4ms/mp153-devboard/v0.2/production/mp153-devboard-mockup-1.png

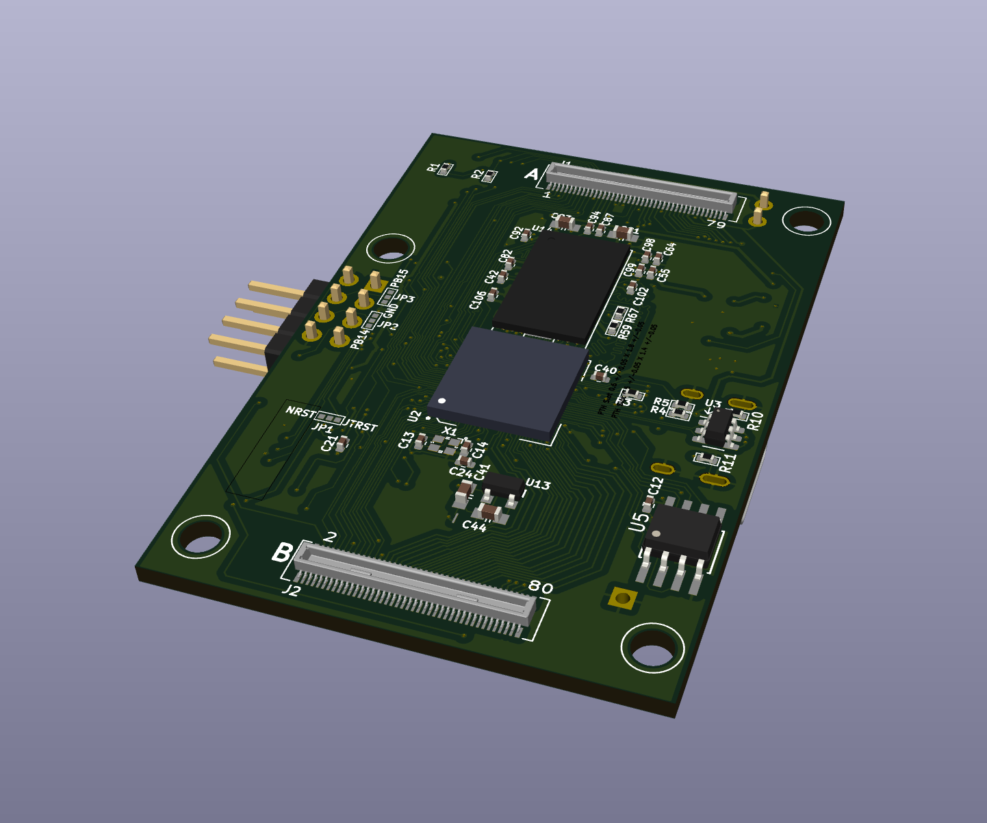
v0.2/production/mp153-devboard-mockup-1.png
