4ms/mp153-devboard/v0.2/uart-connection.jpg

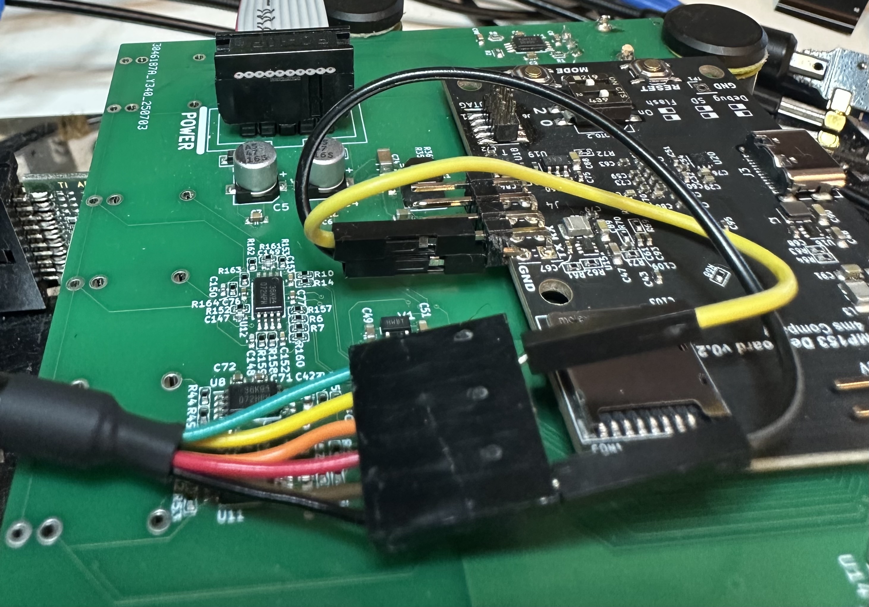
v0.2/uart-connection.jpg
