4ms/mp153-devboard/v0.2/production/mp153-devboard-mockup-2.png

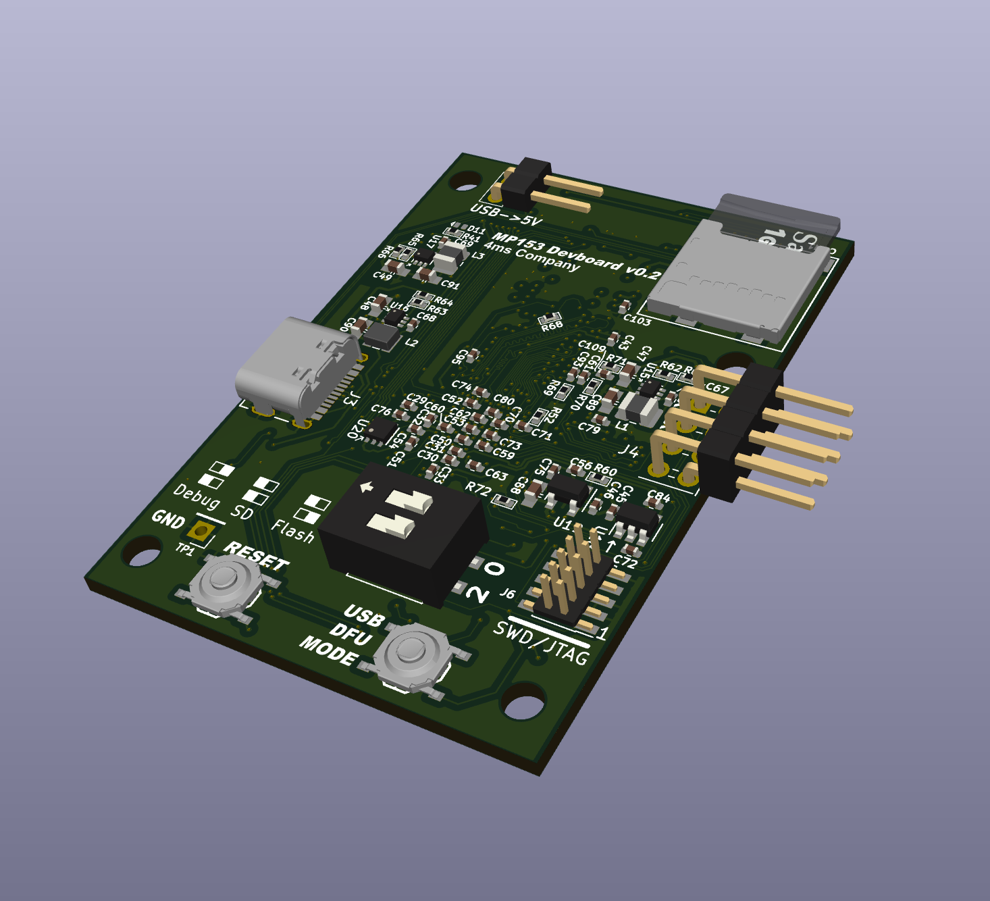
v0.2/production/mp153-devboard-mockup-2.png
