4ms/mp153-devboard/v0.2/production/mp153-devboard-v0.2-bom.xlsx

mp153-devboard-v0.2-bom
4ms Company
PCBA Project: | mp153-devboard | Revision: | v0.2
EMAIL: | 4ms@4mscompany.com
DATE: | 2025-07-10
Group | Item# | Manufacturer | Manufacter Part# | Designator | Quantity | Designation | Package | Comments | Supplied by:
A | 1 | Hirose | DF40C-80DP-0.4V(51) | J1, J2 | 2 | Pins_02x40_P0.4mm_W3.0mm_SMT | Connector-80pin-P0.4mm-W3.0mm
A | 2 | Molex | 217179-0001 | J3 | 1 | USB-C_Receptacle_Molex_2171790001 | USB_C_Receptacle_Molex_2171790001
A | 3 | CTS | 219-2MST | BOOT0_2 | 1 | SW_DIP_x02_CTS_219-2MST, DIP Switch SPST x 2, Gull wing P2.54mm, 6.7x6.55mm Body, 8.6mm Rows | SW_DIP_SPSTx02_CTS_219-2MSTR
A | 4 | Murata | GCM155R71C104KA55D | C12, C21, C30, C40, C42, C43, C61, C64, C67, C68, C69, C82, C87, C92, C93, C94, C95, C98, C99, C102, C103, C106 | 22 | 100nF_0402_16V, 0.1uF, Min. 16V 10%, X7R or X5R or similar | C0402
A | 5 | Yageo | CC0402CRNPO9BN6R8 | C13, C14 | 2 | 6.8pF_0402_25V, 6.8pF, Min. 25V 10%, NP0/C0G | C0402
A | 6 | Yageo | CC0402KRX7R7BB103 | C24 | 1 | 10nF_0402_16V, 10nF, Min. 16V 10%, X7R or X5R or similar | C0402
A | 7 | Murata | GRM155R60J225KE95D | C29, C32 | 2 | 2.2uF_0402_6.3V, 2.2uF, Min. 6.3V 10%, X7R or X5R or similar | C0402
A | 8 | Taiyo Yuden | GMK105CC6105KV-F | C31, C33, C45, C46, C50, C51, C52, C53, C54, C55, C59, C60, C62, C63, C70, C73, C79, C109 | 18 | 1uF_0402_25V, 1uF, Min. 25V, 0402, Ceramic/MLCC | C0402
A | 9 | Murata | GRM188R6YA225KA12D | C41, C47, C48, C49 | 4 | 2.2uF_0603_25V, 2.2uF, Min 25V 10% X5R | C0603
A | 10 | Murata | GRM188R61A106KE69D | C44, C81, C83 | 3 | 10uF_0603_10V, 10uF, Min. 10V X5R 10% | C0603
A | 11 | Murata | GRM155R71H104KE14D | C56, C72, C75 | 3 | 100nF_0402_50V, 0.1uF, Min. 50V 10%, X7R or X5R or similar | C0402
A | 12 | Vishay | VJ0402Y332KXACW1BC | C71, C74, C80 | 3 | 3.3nF_0402_16V, 3.3nF, Min. 16V 10%, X7R or X5R or similar | C0402
A | 13 | Murata | GRM155R60J475ME47 | C76, C84 | 2 | 4.7uF_0402_6.3V, 4.7uF, Min. 6.3V 20%, X7R or X5R or similar | C0402
A | 14 | Murata | GRM188R60J226MEA0J | C88, C89, C90, C91 | 4 | 22uF_0603_6.3V, 22uF, 6.3V,10%,X5R or X7R,0603 | C0603
A | 15 | Diodes Inc | BAT54LP-7 | D11 | 1 | BAT54LP, Schottky, 1mm x 0.6mm, Vr >= 30V, If >= 200mA, Vf = 240mA@0.1mA | DFN-1006-2
A | 16 | Murata | DFE252012P-1R0M=P2 | L1, L3 | 2 | 1uH_3.2A_2520, Inductor 1uH ~42mohm 3.2A 2.5mm x 2.0mm | L_1008_2520Metric
A | 17 | Bourns | SRN2510F-4R7M | L2 | 1 | 4.7uH_1.7A_2510, Power Inductors - SMD 4.7uH 20% SMD 2510 1.7A | L_Wuerth_MAPI-2510
A | 18 | Yageo | RC0402FR-0710KL | R1, R2, R41, R61, R64, R66, R67, R69, R72 | 9 | 10k_0402, 10k, 1%, 1/16W, 0402 | R0402
A | 19 | Yageo | RC0402FR-073KL | R3 | 1 | 3k_0402, 3k, 1%, 1/16W, 0402 | R0402
A | 20 | Yageo | RC0402FR-07430KL | R4 | 1 | 430k_0402, 430k, 1%, 1/16W, 0402 | R0402
A | 21 | Yageo | RC0402FR-07620KL | R5 | 1 | 620k_0402, 620k, 1%, 1/16W, 0402 | R0402
A | 22 | Yageo | RC0402FR-075K1L | R10, R11 | 2 | 5.1k_0402, 5.1k, 1%, 1/16W, 0402 | R0402
A | 23 | Yageo | RC0402FR-07240RL | R52, R59 | 2 | 240Ω_0402, 240Ω, 1%, 1/16W, 0402 | R0402
A | 24 | Yageo | RC0402FR-07100KL | R60 | 1 | 100k_0402, 100k, 1%, 1/16W, 0402 | R0402
A | 25 | Yageo | RC0402FR-0720KL | R62 | 1 | 20k_0402, 20k, 1%, 1/16W, 0402 | R0402
A | 26 | Yageo | RC0402FR-0731K6L | R63 | 1 | 31.6k_0402, 31.6k, 1%, 1/16W, 0402 | R0402
A | 27 | Yageo | RC0402FR-076K8L | R65 | 1 | 6.8k_0402, 6.8k, 1%, 1/16W, 0402 | R0402
A | 28 | Yageo | RC0402FR-07100RL | R68 | 1 | 100Ω_0402, 100Ω, 1%, 1/16W, 0402 | R0402
A | 29 | Yageo | RC0402FR-071KL | R70, R71 | 2 | 1k_0402, 1k, 1%, 1/16W, 0402 | R0402
A | 30 | C&K Switches | PTS526 SM15 SMTR2 LFS | S2, S3 | 2 | SW_Push_PTS526 SM15 SMTR2 LFS, Tact button, NO, | Button_Tact_PTS526
A | 31 | STMicroelectronics | STM32MP153DAD | U2 | 1 | STM32MP15xxAD, Cortex A7x2 + M4, 800MHz, TFBGA12x12 | TFBGA-257_10x10mm_perP0.5_cntrP0.65
A | 32 | STMicroelectronics | USBLC6-2SC6 | U3 | 1 | USBLC6-2SC6, ESD Protection, pins 3+4, 1+6 shorted | SOT-23-6
A | 33 | Winbond | W25Q128JVSIQ | U5 | 1 | NORFLASH_W25Q128JV, 16Mbit QSPI NOR FLASH, 4kb uniform sectors | SOIC-8_5.28x4.9mm_Pitch1.27mm
A | 34 | ON Semiconductor | NCP51460SN33T1G | U13 | 1 | NCP51460SN33, Precision 3.3V Ref 1% 18PPM 28Vmax 20mAmax | SOT23-3_PO132
A | 35 | Micron | MT41K256M16TW-107-P-V00H | U14 | 1 | DDR3L-RAM-4Gb_MT41K256M16TW, 4Gbit DDR3L | FBGA-96_Layout2x3x16_Body8x14_P0.8mm
A | 36 | Diodes Inc | AP62301Z6 | U15, U16, U17 | 3 | AP6230xZ6, 3A, 750kHz Buck DC/DC Converter, VinMax>=12V | SOT-563
A | 37 | Toshiba | TAR5S33TE85LF | U18, U19 | 2 | TAR5S33, LDO 3.3V, Vin >= 12V, Enable, Min Iout >= 50mA | SOT-23-5
A | 38 | Diodes Incorporated | AP2411SN-7 | U20 | 1 | AP2411SN | DFN-6-1EP_2x2mm_P0.65mm_EP1x1.6mm
A | 39 | ECS | ECS-240-8-37-CKM-TR3 | X1 | 1 | 24MHz_8pF_2x1.6mm, 24MHz 8pF Crystal Resonator, 10ppm, 2016 2x1.6mm | Crystal_2.0x1.6mm_4pin
AB | 40 | Molex | 104031-0811 | CON1 | 1 | microSDCon_SMT_104031-0811, MicroSD Card Conn Horiz SMT | CardSlot_MicroSD_Molex_104031-0811
AB | 41 | Samtec | FTSH-105-01-F-DV | J6 | 1 | Pins_02x05_P1.27mm_SMT, Header 2x5 Pins, Pitch=1.27mm, Pin Height=3mm, Vertical, SMT | Pins_2x05_1.27mm_SMD
B | 42 | Samtec | TSW-104-08-T-D-RA | J4 | 1 | Pins_02x04_RightAngle_P2.54mm_TH, HEADER 2x4 MALE PINS 0.100” 90deg Right Angle | Pins_2x04_P2.54mm_Horizontal_CroppedSilk
B | 43 | Samtec | TSW-102-08-T-S-RA | J5 | 1 | Conn_01x02, Pins_01x02, Header, Male Pins, 1*2, spacing 2.54mm, right angle pin | Pins_1x02_2.54mm_Horizontal_TH
 |  |  | DNP | H1, H2, H3, H4 |  | DNP | DNP
 |  |  | DNP | TP1 |  | DNP | DNP
