4ms/mp153-devboard/v0.1/3d-models/DF40HC(3.0)-80DS.stp

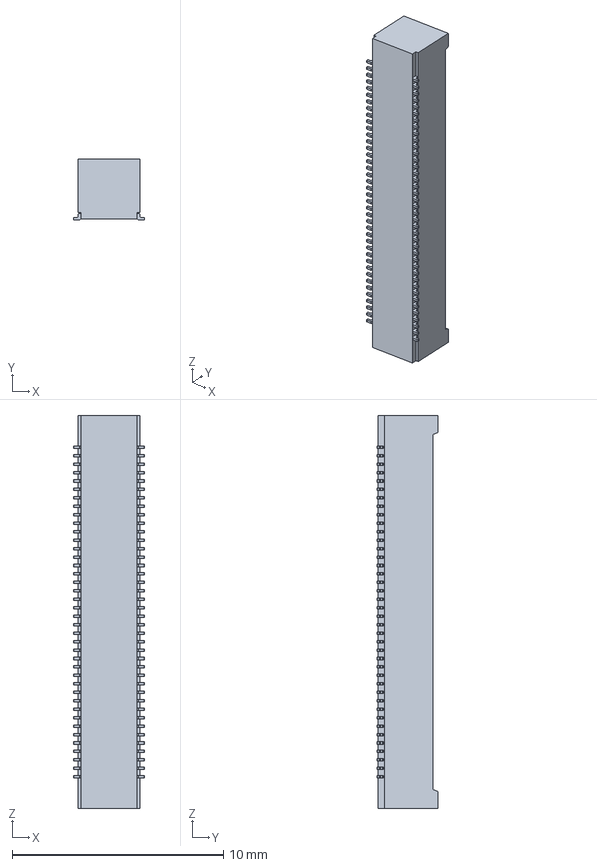
[picture p4: CAD file, 2025-06-03, an earlier design]
v0.1/3d-models/DF40HC(3.0)-80DS.stp
3.38 x 2.90 x 18.6 mm
