4ms/mp153-devboard/v0.1/3d-models/DF40C-80DP.stp

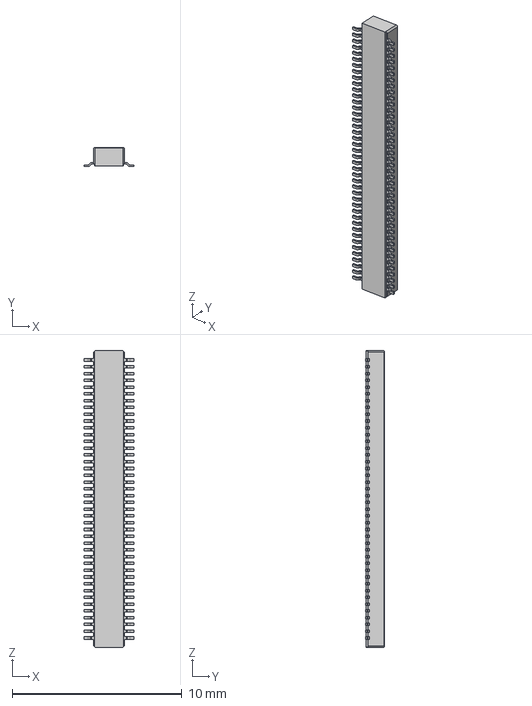
[picture p5: CAD file, 2025-06-03, an earlier design]
v0.1/3d-models/DF40C-80DP.stp
2.97 x 1.14 x 17.5 mm
