4ms/mp153-devboard/carrier-breakout/v0.1/mp153-carrier-board.pdf

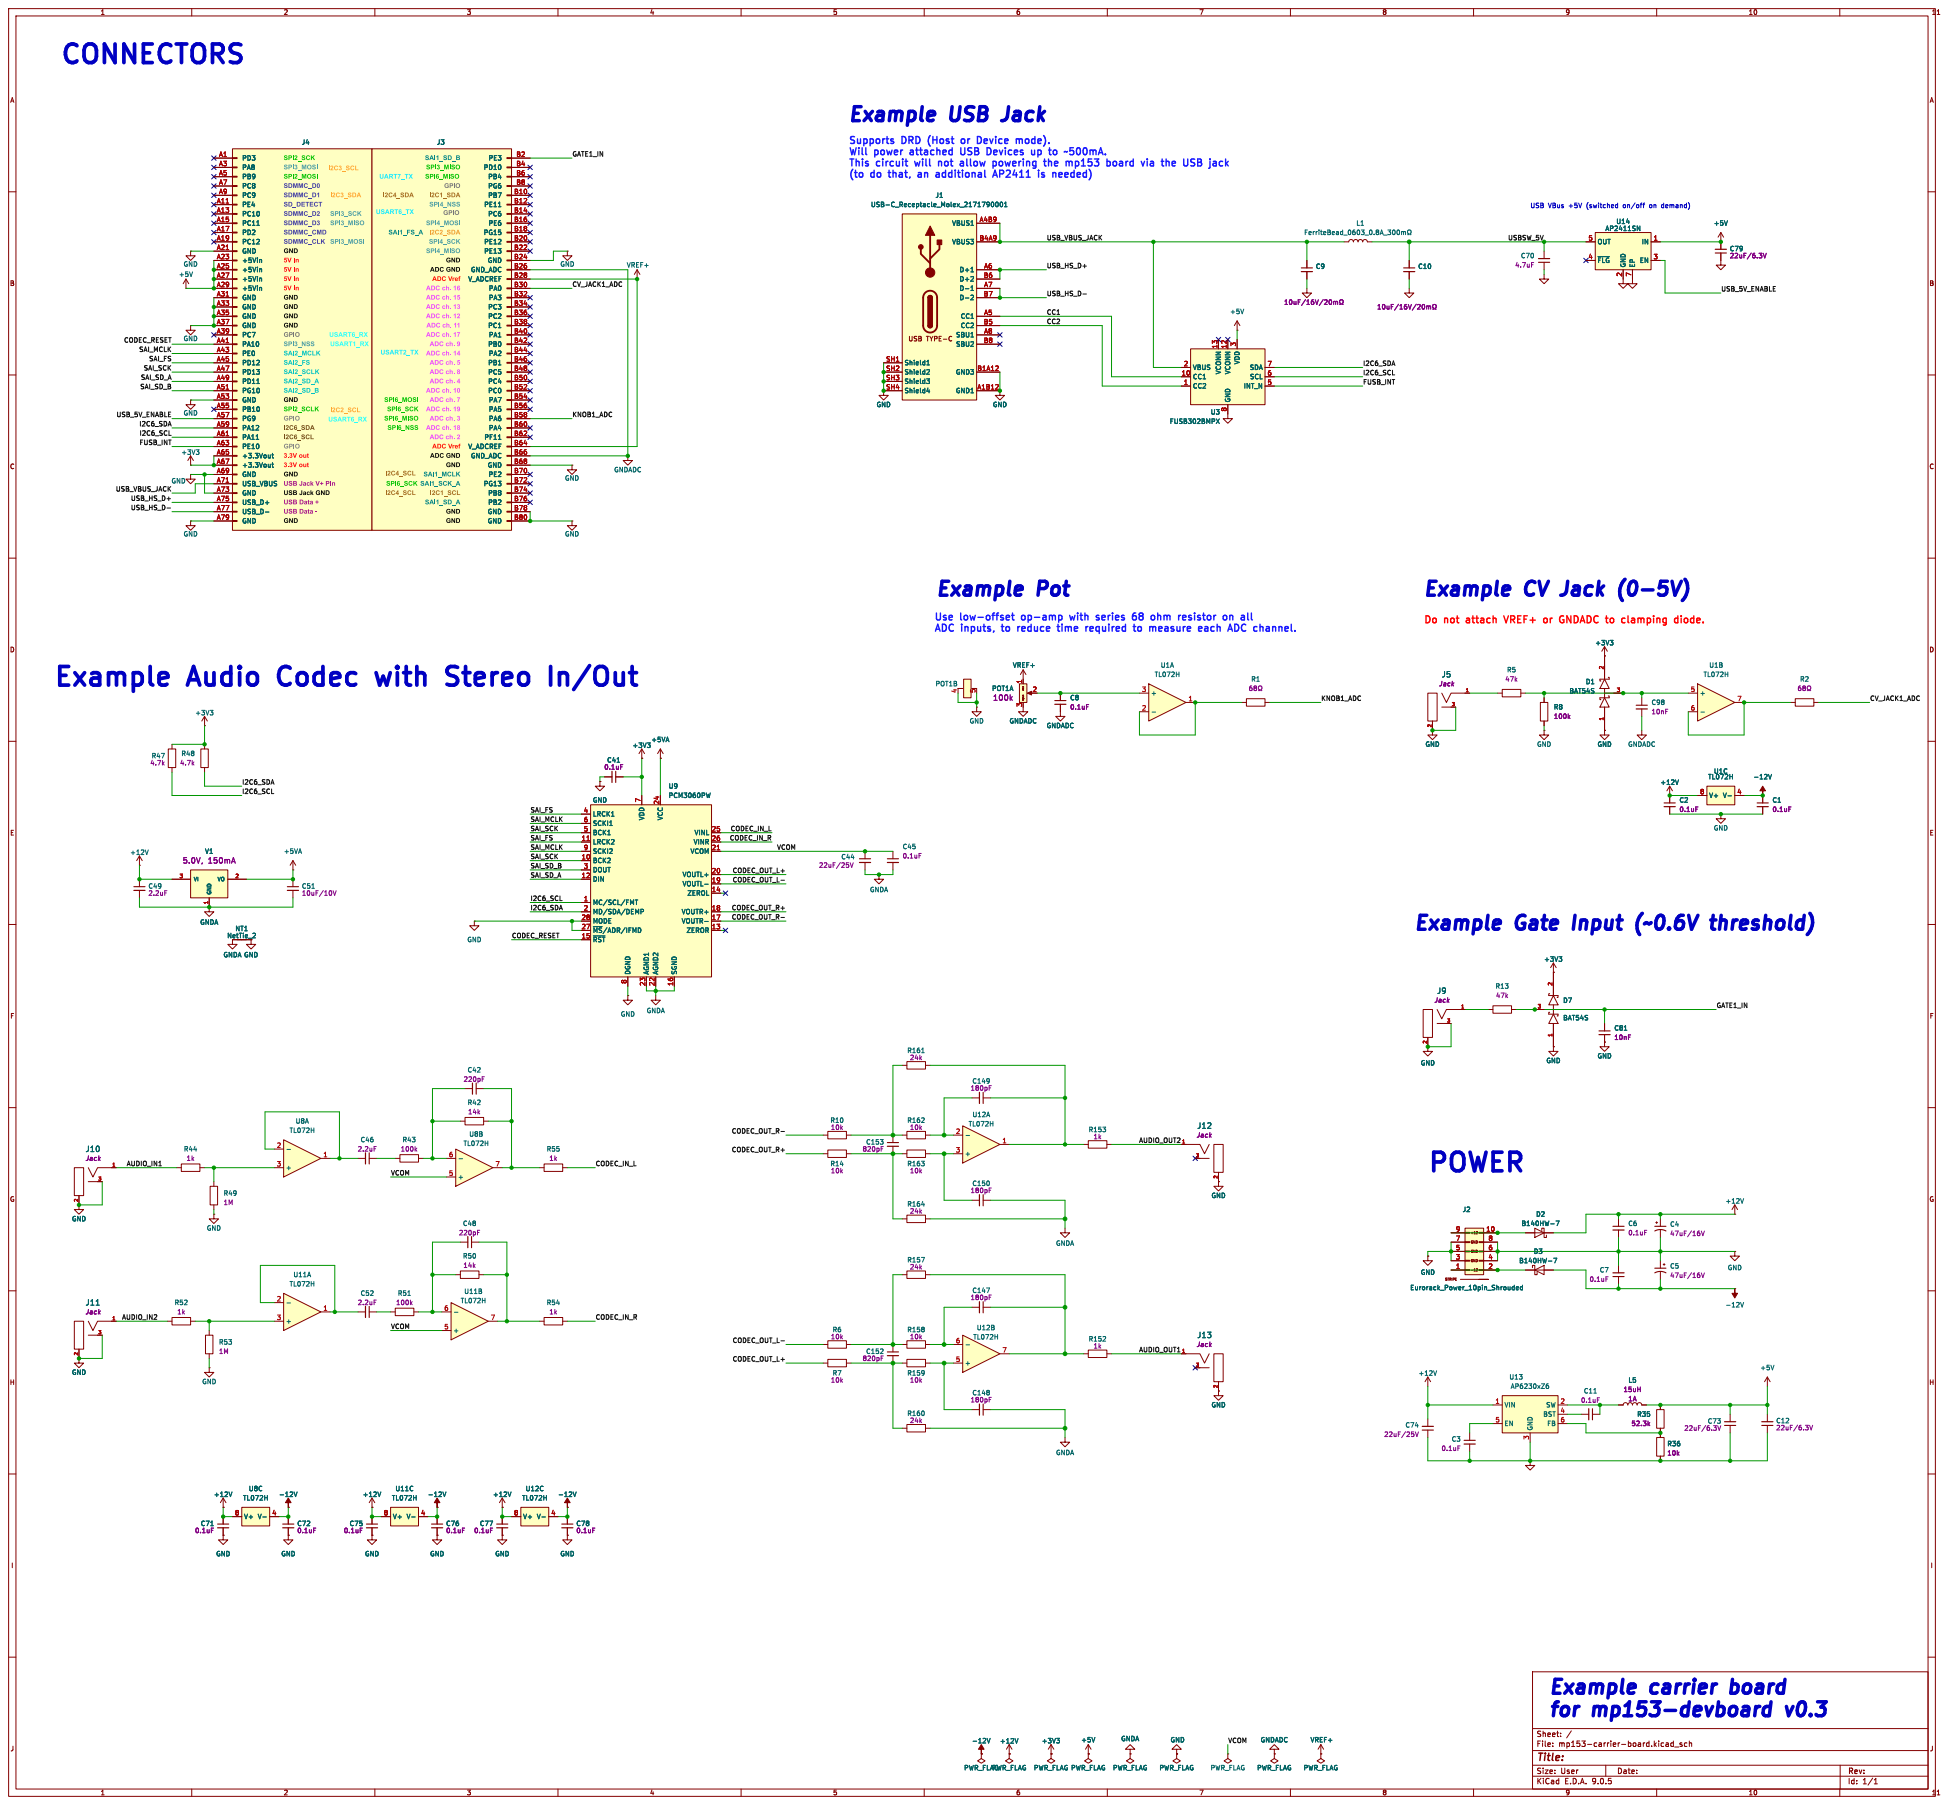
[picture p6: page 1]

Supports DRD (Host or Device mode).
Will power attached USB Devices up to ~500mA.
This circuit will not allow powering the mp153 board via the USB jack

SAI1_FS_A
ADC Vref ADC ch. 16 ADC ch. 15 ADC ch. 13 ADC ch. 12 ADC ch. 11 ADC ch. 17 ADC ch. 9 ADC ch. 14 ADC ch. 5 ADC ch. 8 ADC ch. 4 ADC ch. 10 ADC ch. 7 ADC ch. 19 ADC ch. 3 ADC ch. 18 ADC ch. 2 ADC Vref ADC GND GND

5V In GND GND GND GND GPIO

USB Jack V+ Pin USB Jack GND

USB Data + USB Data - GND

ADC inputs, to reduce time required to measure each ADC channel.

Do not attach VREF+ or GNDADC to clamping diode.

AUDIO_IN2 Example Audio Codec with Stereo In/Out

7 AGND1 23 AGND2 22 VCC 24 SGND 16 VINL 25 VINR 26 VCOM 21 VOUTL+ 20 VOUTL- 19 ZEROL 14 VOUTR+ 18 VOUTR- 17 ZEROR 13 U9PCM3060PW

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

Example Gate Input (~0.6V threshold)

Id: 1/1 Title: File: mp153-carrier-board.kicad_sch Sheet: /
