4ms/mp153-devboard/sdprog/sdprog/sdprog.kicad_pcb

## KiCad design sdprog/sdprog/sdprog.kicad_pcb (2026-02-20)

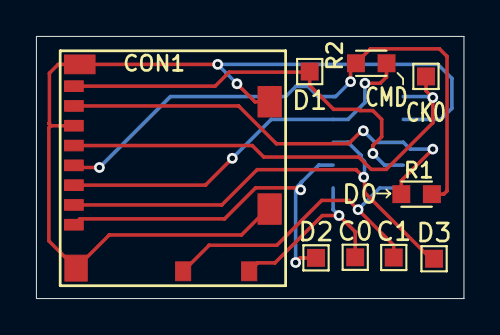
[picture p7: board sdprog.kicad_pcb from above]

Board: 2 copper layers, 23.7 x 14.6 mm, 10 parts (1 on the bottom side), 10 nets.

Parts:
C0, C1: TestPoint; TestPoint_Pad_1.0x1.0mm
CK0: TestPoint; TestPoint_Pad_1.0x1.0mm
CON1: microSDCon_SMT_104031-0811; CardSlot_MicroSD_Molex_104031-0811
D1, D2, D3: TestPoint; TestPoint_Pad_1.0x1.0mm
J1: Socket_02x05_P1.27mm_SMT; Socket_2x05_1.27mm_SMD
R1, R2: 10k_0603; R_0603

Connections:
+3.3V: CON1.4 (VDD), J1.1, R1.1, R2.1
/CD0: C0.1, CON1.10 (SDDET1), J1.9 (GND)
/CD1: C1.1, CON1.11 (SDDET2), J1.10 (GND)
/SDMMC_CLK: CK0.1, CON1.5 (CLK), J1.2
/SDMMC_CMD: CON1.3 (CMD), J1.3, R2.2
/SDMMC_D0: CON1.7 (DAT0), J1.6, R1.2
/SDMMC_D1: CON1.8 (DAT1), D1.1, J1.8 (+12V)
/SDMMC_D2: CON1.1 (DAT2), D2.1, J1.7 (12V)
/SDMMC_D3: CON1.2 (CD/DAT3), D3.1, J1.5 (+12V)
GND: CON1.6 (VSS), CON1.9 (SHELL1), J1.4
