4ms/mp153-devboard/v0.4-mp133/mp133-devboard.kicad_pcb

## KiCad design v0.4-mp133/mp133-devboard.kicad_pcb (2026-01-02)

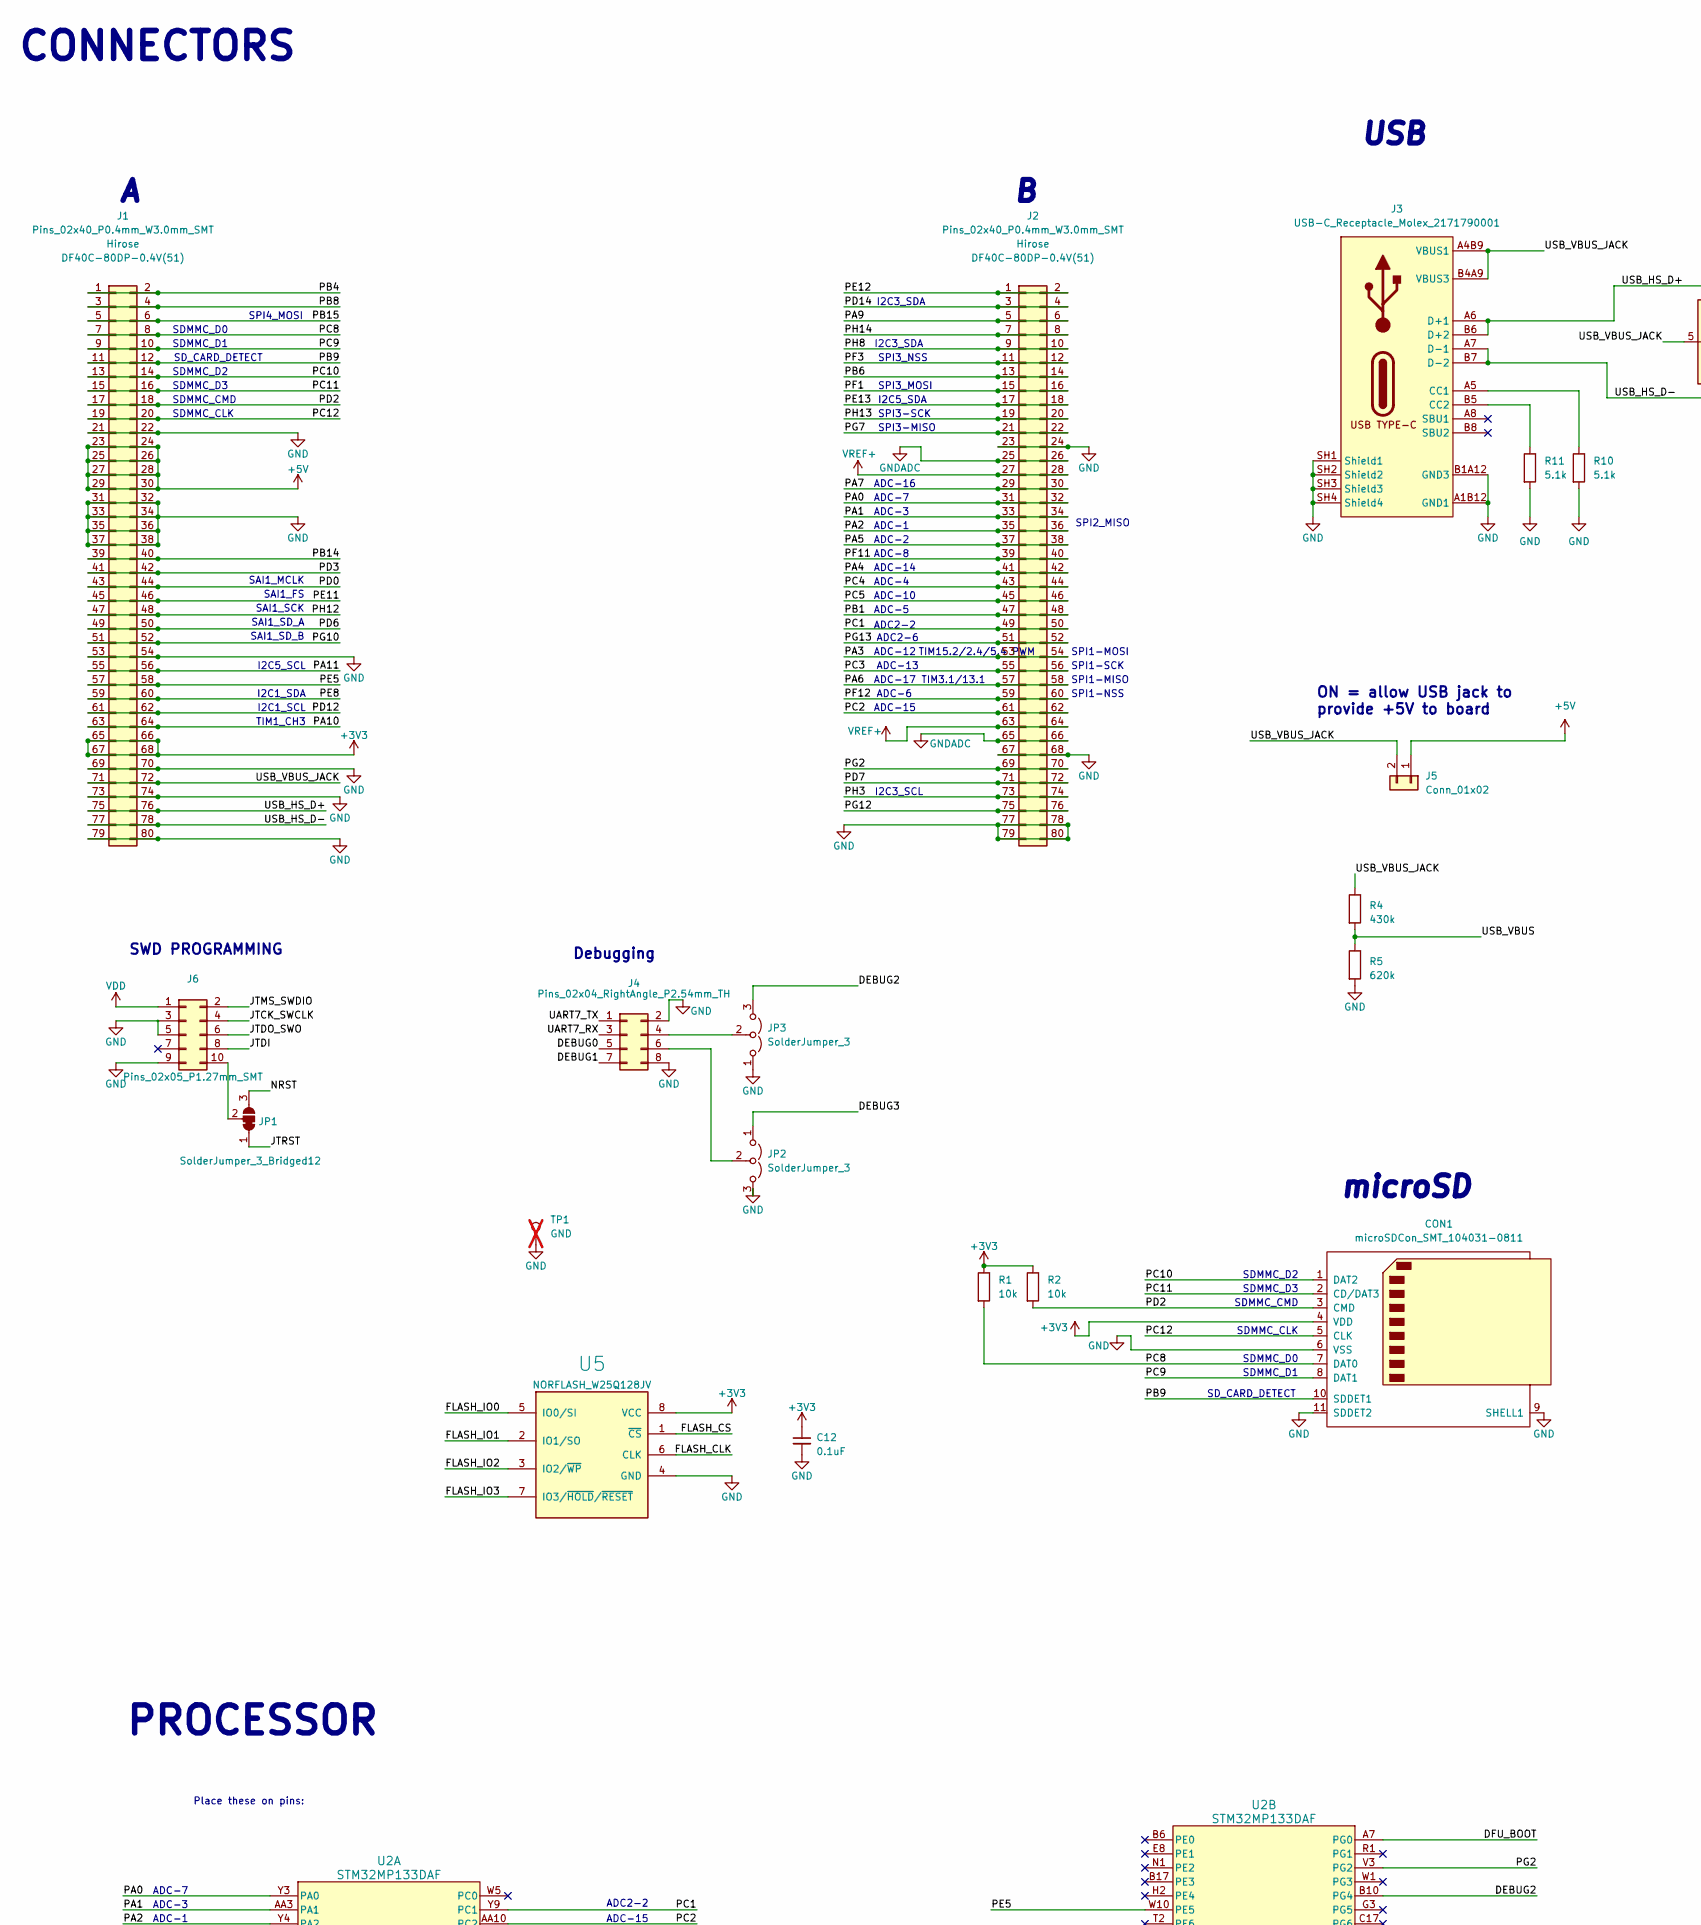
[picture p8: schematic mp133-devboard.kicad_sch, part in row 1, column 1]

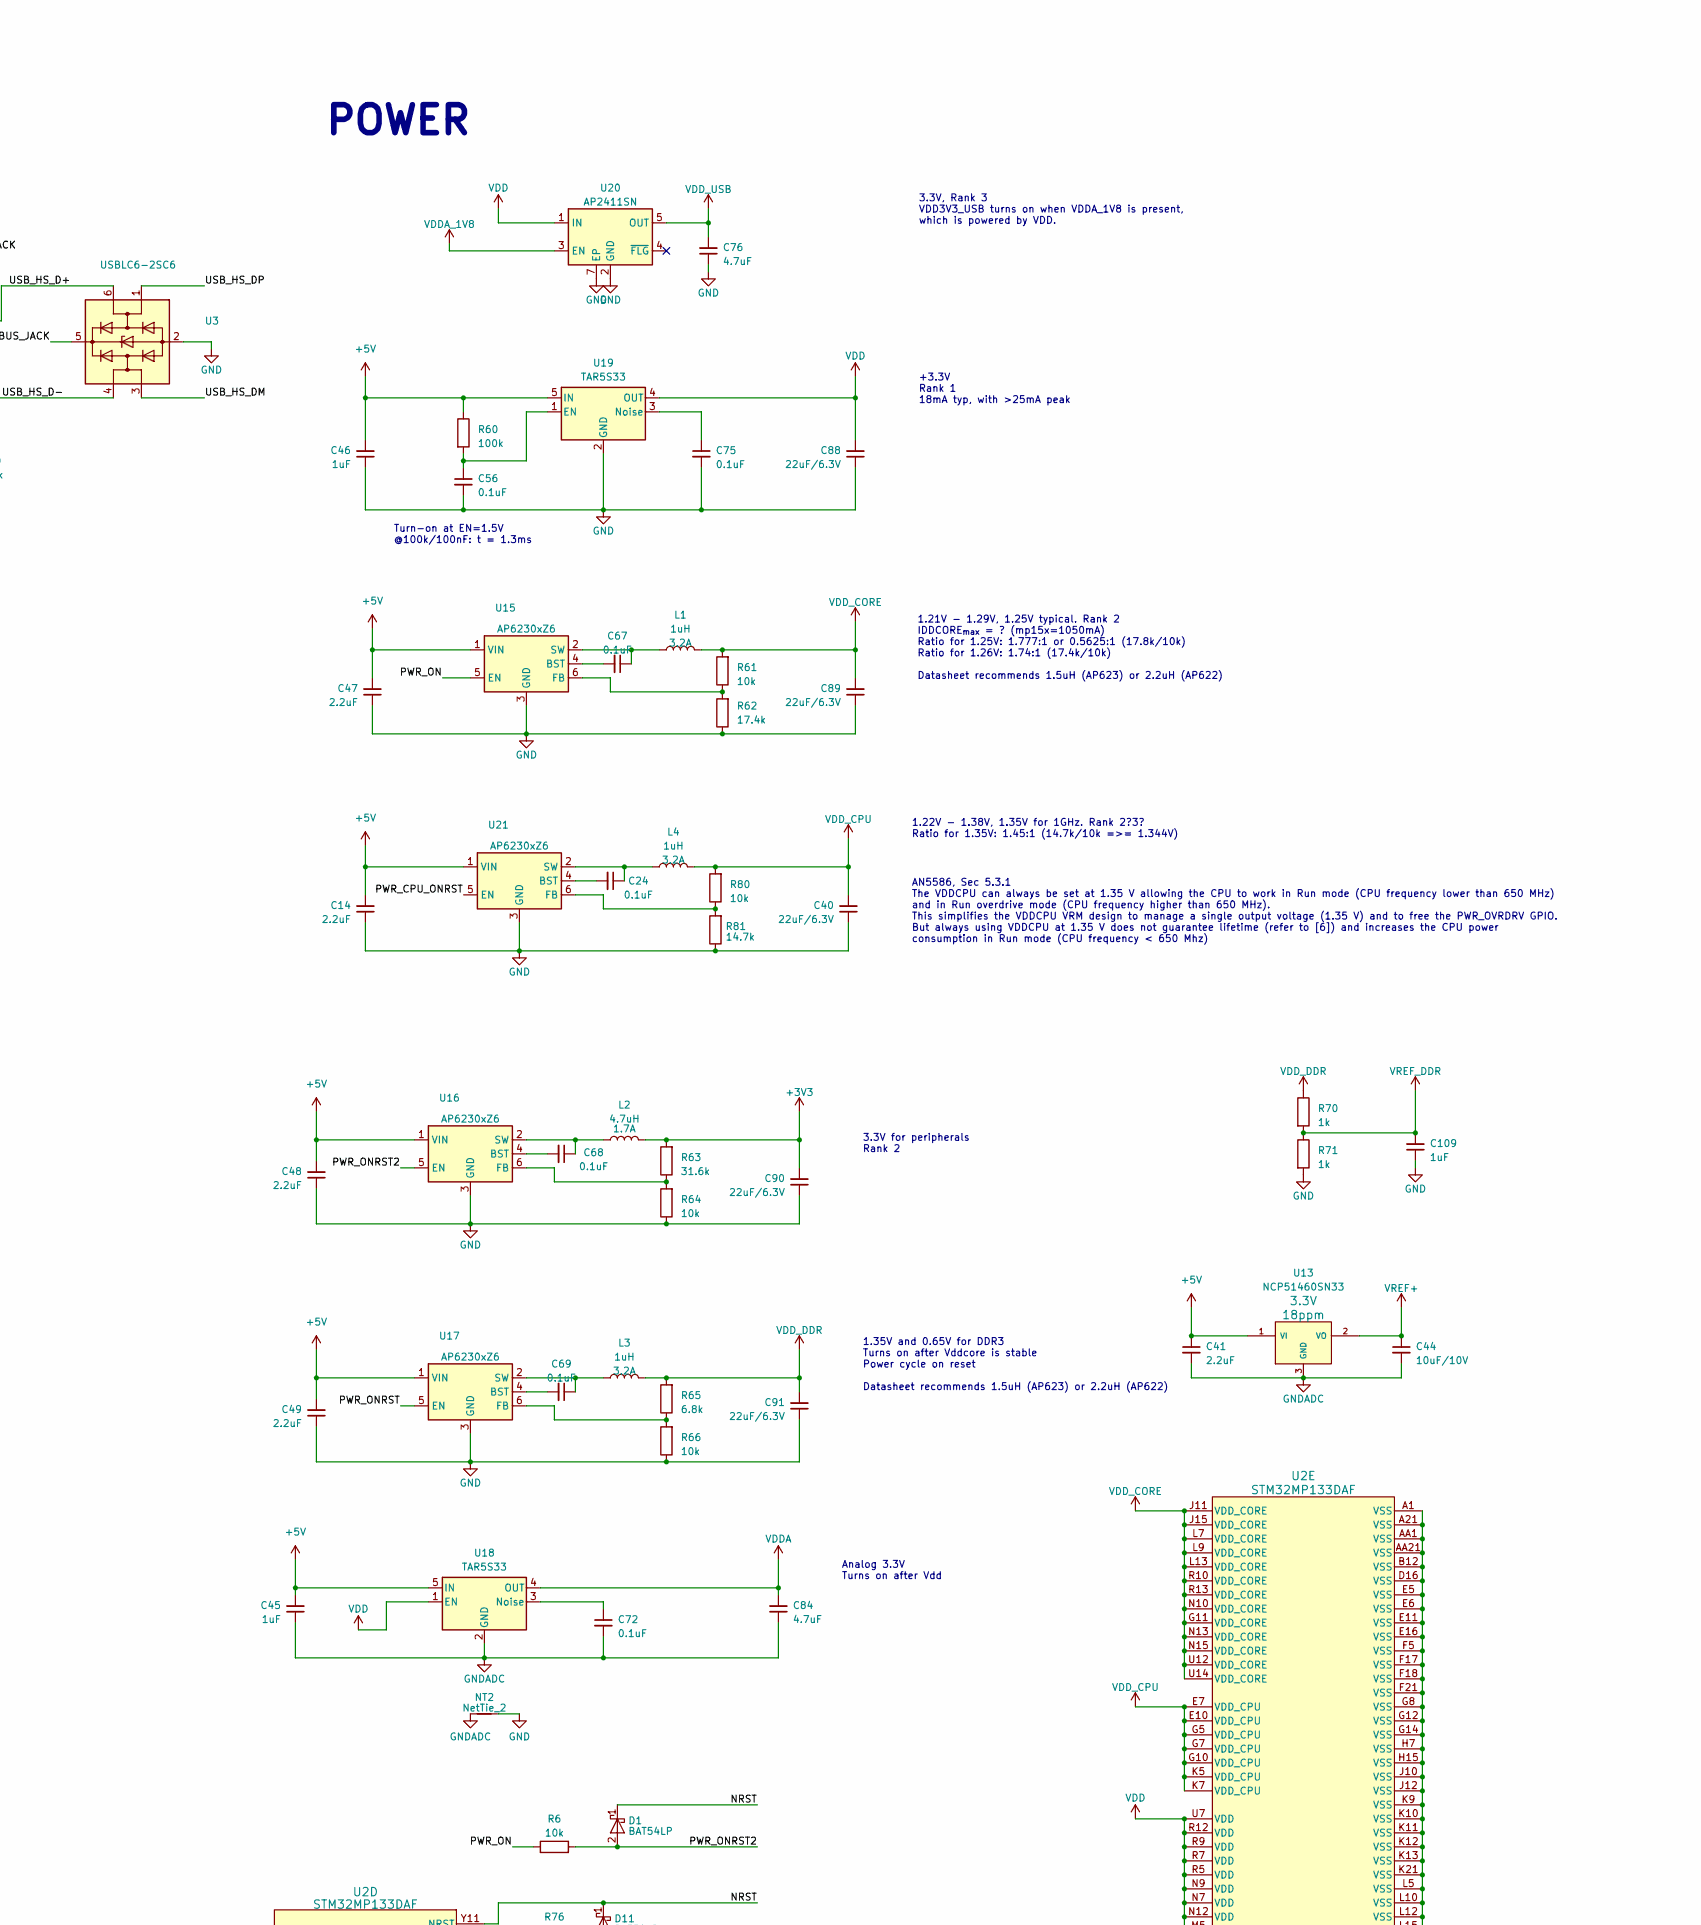
[picture p9: schematic mp133-devboard.kicad_sch, part in row 1, column 2]

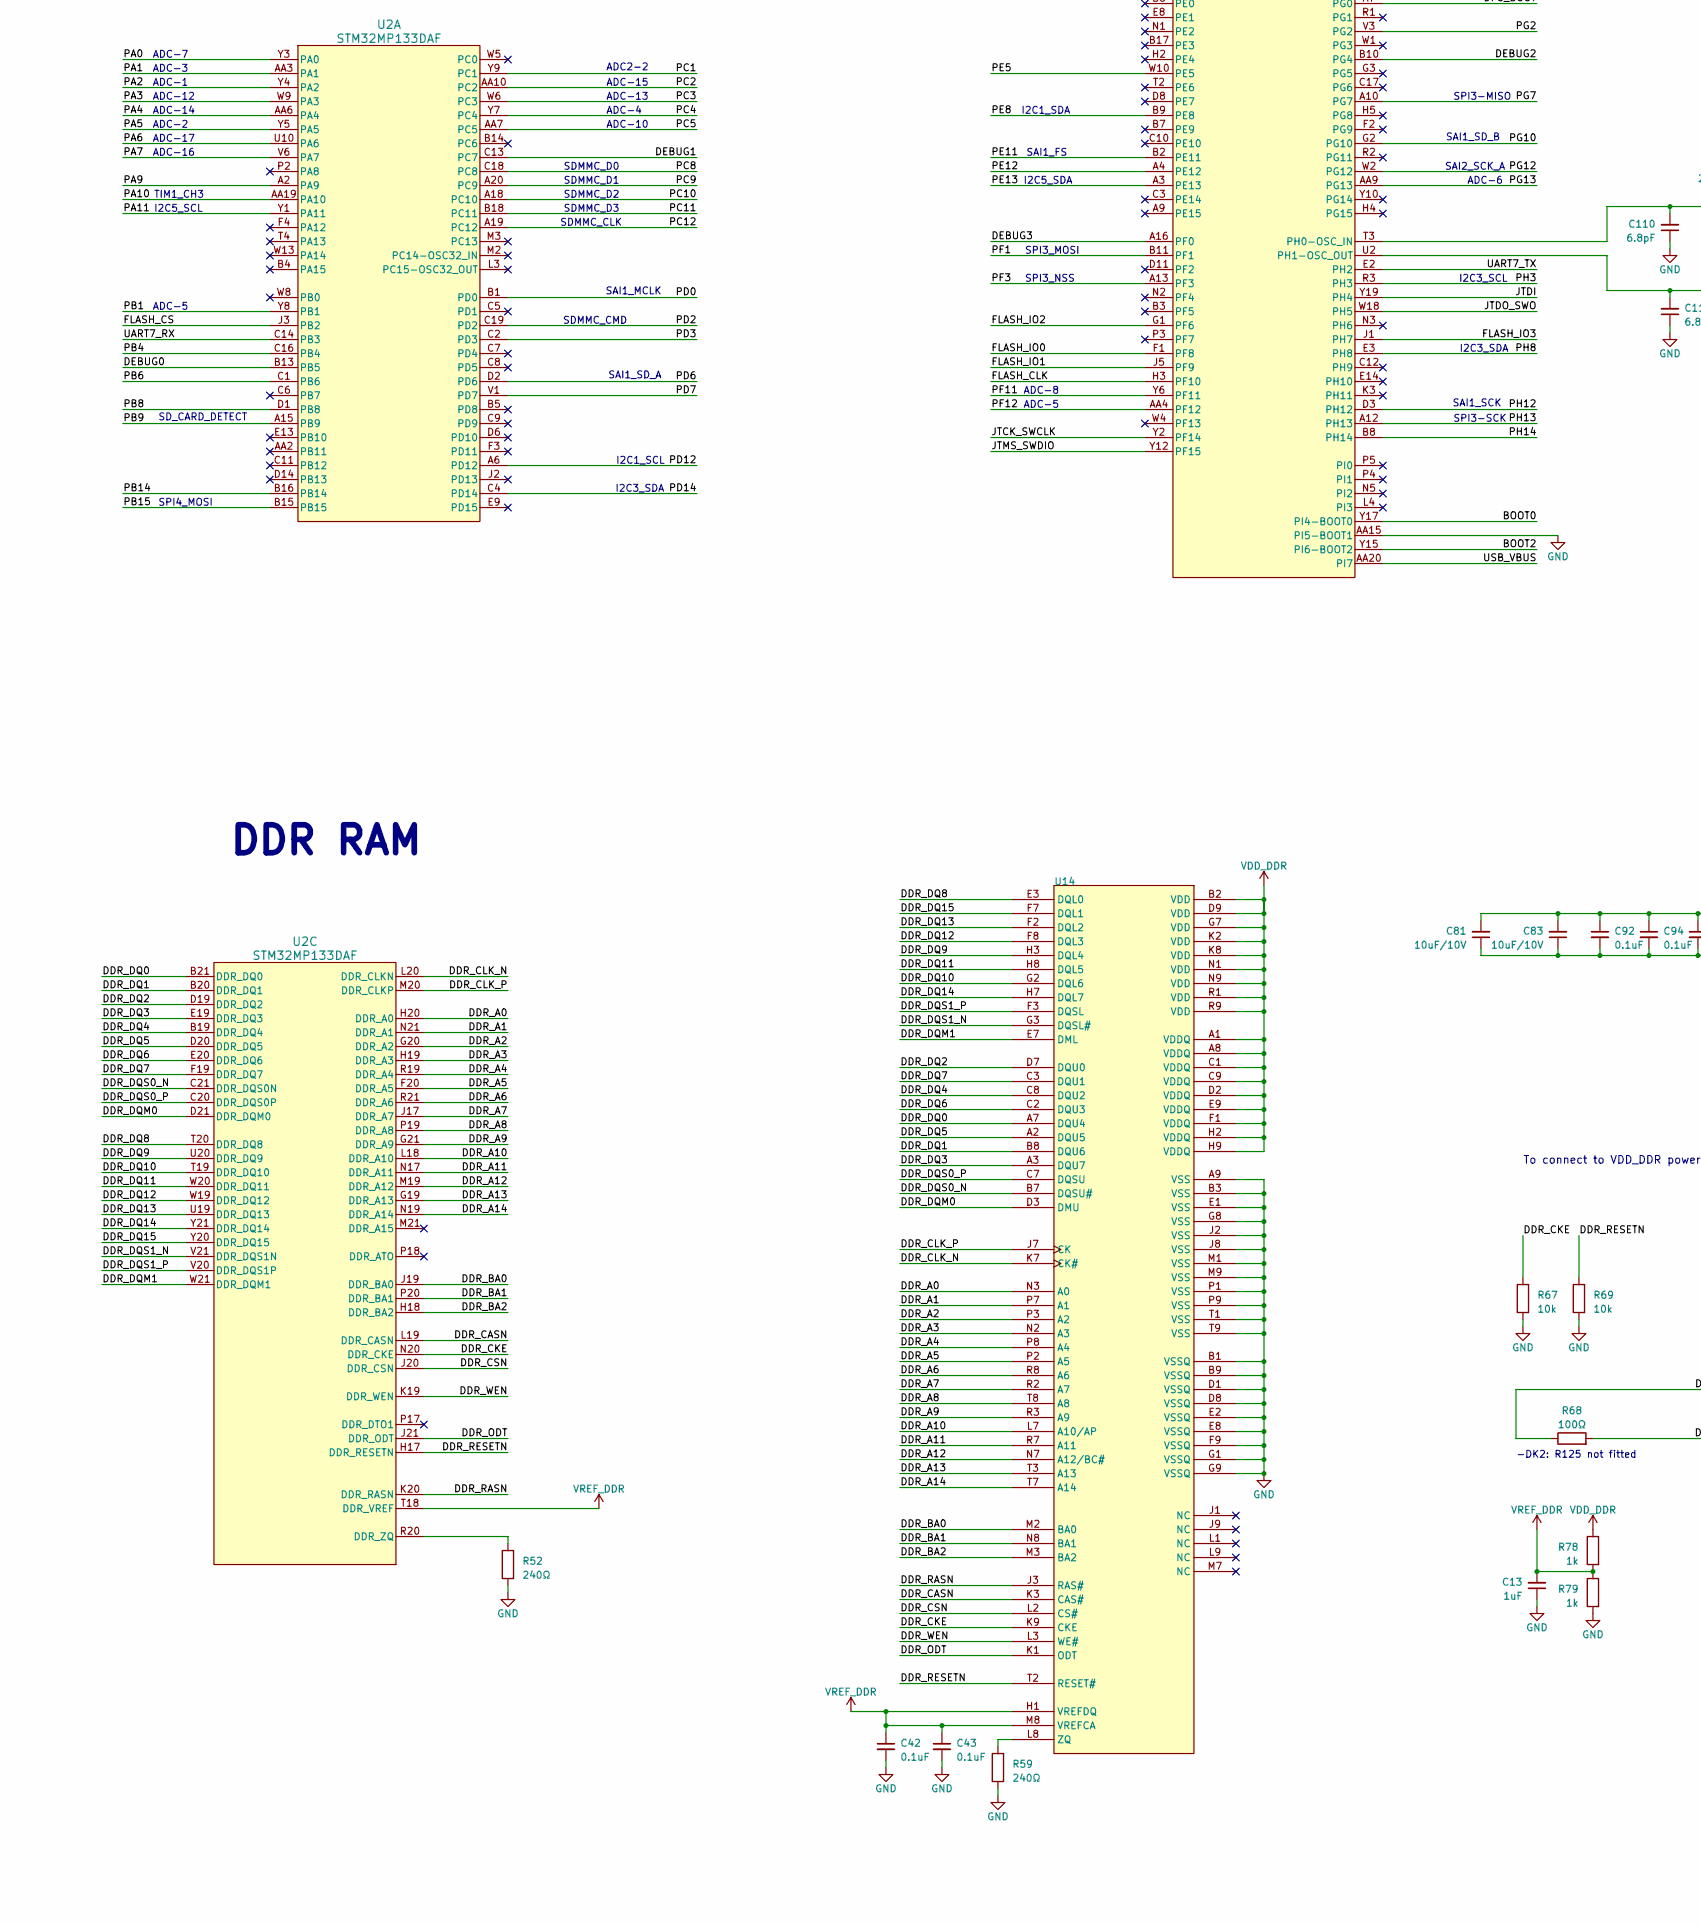
[picture p10: schematic mp133-devboard.kicad_sch, part in row 2, column 1]

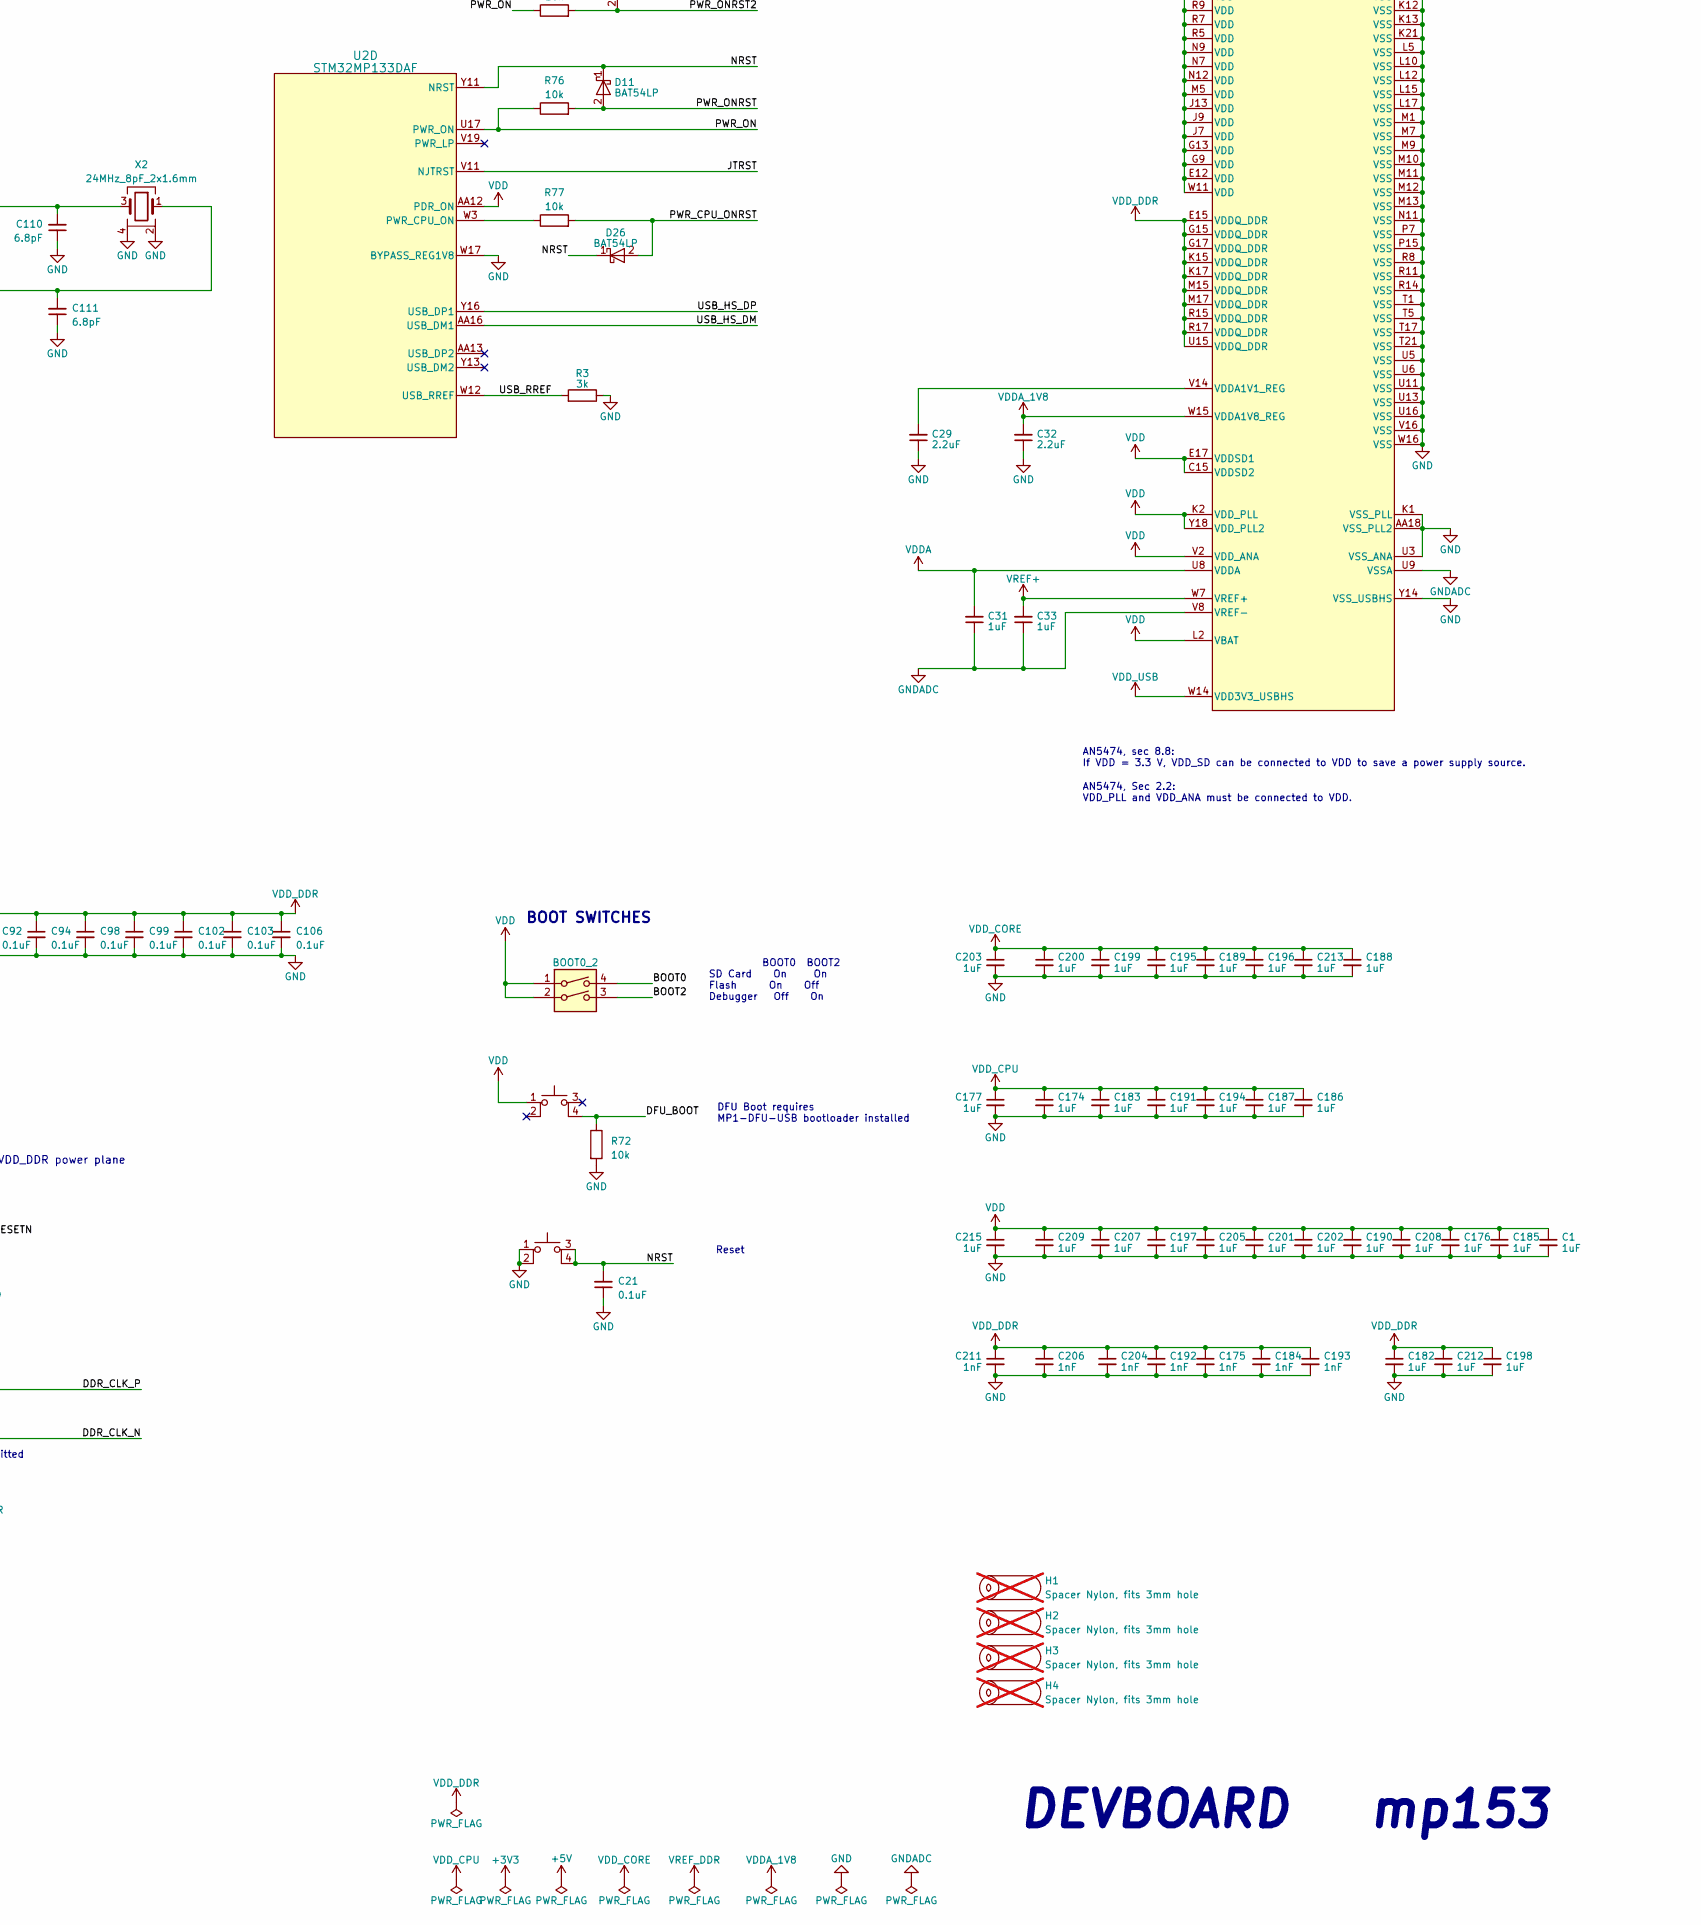
[picture p11: schematic mp133-devboard.kicad_sch, part in row 2, column 2]

Parts:
BOOT0_2: SW_DIP_x02_CTS_219-2MST; SW_DIP_SPSTx02_CTS_219-2MSTR; Part Number 219-2MST; JLCPCB ID C2961978
C1, C174, C176, C177, C182, C183, C185, C186, C187, C188, C189, C190, C191, C194, C195, C196, C197, C198, C199, C200, C201, C202, C203, C205, C207, C208, C209, C212, C213, C215: 1uF_0201_4V; C_0201; Part Number CC0201MRX5R5BB105; JLCPCB ID C272877
C12, C21, C24, C42, C43, C67, C68, C69, C92, C94, C98, C99, C102, C103, C106: 100nF_0402_16V; C_0402; Part Number GCM155R71C104KA55D; JLCPCB ID C1525
C13, C31, C33, C45, C46, C109: 1uF_0402_25V; C_0402; Part Number GMK105CC6105KV-F; JLCPCB ID C52923
C14, C41, C47, C48, C49: 2.2uF_0603_25V; C_0603; Part Number GRM188R6YA225KA12D; JLCPCB ID C57895
C29, C32: 2.2uF_0402_6.3V; C_0402; Part Number GRM155R60J225KE95D; JLCPCB ID C12530
C40, C88, C89, C90, C91: 22uF_0603_6.3V; C_0603; Part Number GRM188R60J226MEA0J; JLCPCB ID C59461
C44, C81, C83: 10uF_0603_10V; C_0603; Part Number GRM188R61A106KE69D; JLCPCB ID C19702
C56, C72, C75: 100nF_0402_50V; C_0402; Part Number GRM155R71H104KE14D; JLCPCB ID C307331
C76, C84: 4.7uF_0402_6.3V; C_0402; Part Number GRM155R60J475ME47; JLCPCB ID C23733
C110, C111: 6.8pF_0402_25V; C_0402; Part Number CC0402CRNPO9BN6R8; JLCPCB ID C1576
C175, C184, C192, C193, C204, C206, C211: 1nF_0201_4V; C_0201; Part Number GRM033R71E102JA01D; JLCPCB ID C258477
CON1: microSDCon_SMT_104031-0811; CardSlot_MicroSD_Molex_104031-0811; Part Number 104031-0811; JLCPCB ID C585350
D1, D11, D26: BAT54LP; DFN-1006-2; Part Number BAT54LP-7; JLCPCB ID C134410
H1, H2, H3, H4: Spacer Nylon, fits 3mm hole; MountingHole_Generic_3mm; not fitted
J1, J2: Pins_02x40_P0.4mm_W3.0mm_SMT; Connector-80pin-P0.4mm-W3.0mm; Part Number DF40C-80DP-0.4V(51); JLCPCB ID C294544
J3: USB-C_Receptacle_Molex_2171790001; USB_C_Receptacle_Molex_2171790001; Part Number 217179-0001; JLCPCB ID C2894899
J4: Pins_02x04_RightAngle_P2.54mm_TH; Pins_2x04_P2.54mm_Horizontal_CroppedSilk; Part Number TSW-104-08-T-D-RA
J5: Conn_01x02; Pins_1x02_2.54mm_TH; Part Number TSW-102-08-T-S-RA
J6: Pins_02x05_P1.27mm_SMT; Pins_2x05_1.27mm_SMD; Part Number FTSH-105-01-F-DV; JLCPCB ID C598540
JP1: SolderJumper_3_Bridged12; JUMPER_SMD_1x3_tiny
JP2, JP3: SolderJumper_3; JUMPER_SMD_1x3_tiny_open
L1, L3, L4: 1uH_3.2A_2520; L_1008_2520Metric; Part Number DFE252012P-1R0M=P2; JLCPCB ID C435392
L2: 4.7uH_1.7A_2510; L_Wuerth_MAPI-2510; Part Number SRN2510F-4R7M; JLCPCB ID C2047781
NT2: NetTie_2; NetTie-2_SMD_Pad0.16mm_6mil
R1, R2, R6, R61, R64, R66, R67, R69, R72, R76, R77, R80: 10k_0402; R_0402; Part Number RC0402FR-0710KL; JLCPCB ID C60490
R3: 3k_0402; R_0402; Part Number RC0402FR-073KL; JLCPCB ID C137987
R4: 430k_0402; R_0402; Part Number RC0402FR-07430KL; JLCPCB ID C163463
R5: 620k_0402; R_0402; Part Number RC0402FR-07620KL; JLCPCB ID C137952
R10, R11: 5.1k_0402; R_0402; Part Number RC0402FR-075K1L; JLCPCB ID C105872
R52, R59: 240Ω_0402; R_0402; Part Number RC0402FR-07240RL; JLCPCB ID C114755
R60: 100k_0402; R_0402; Part Number RC0402FR-07100KL; JLCPCB ID C60491
R62: 17.4k_0402; R_0402; Part Number RC0402FR-0717K4L; JLCPCB ID C327366
R63: 31.6k_0402; R_0402; Part Number RC0402FR-0731K6L; JLCPCB ID C276265
R65: 6.8k_0402; R_0402; Part Number RC0402FR-076K8L; JLCPCB ID C93940
R68: 100Ω_0402; R_0402; Part Number RC0402FR-07100RL; JLCPCB ID C106232
R70, R71, R78, R79: 1k_0402; R_0402; Part Number RC0402FR-071KL; JLCPCB ID C106235
R81: 14.7k_0402; R_0402; Part Number RC0402FR-0714K7L; JLCPCB ID C138055
S2, S3: SW_Push_PTS526 SM15 SMTR2 LFS; Button_Tact_PTS526; Part Number PTS526 SM15 SMTR2 LFS; JLCPCB ID C2689521
TP1: GND; PinHeader_1x01_P2.54mm_Vertical; not fitted
U2: STM32MP133DAF; TFBGA-320_11x11mm_P0.5; Part Number STM32MP133DAF
U3: USBLC6-2SC6; SOT-23-6; Part Number USBLC6-2SC6; JLCPCB ID C2827654
U5: NORFLASH_W25Q128JV; SOIC-8_5.28x4.9mm_Pitch1.27mm; Part Number W25Q128JVSIQ; JLCPCB ID C113767
U13: NCP51460SN33; SOT23-3_PO132; Part Number NCP51460SN33T1G; JLCPCB ID C233715
U14: DDR3L-RAM-4Gb_MT41K256M16TW; FBGA-96_Layout2x3x16_Body8x14_P0.8mm; Part Number MT41K256M16TW-107-P-V00H; JLCPCB ID C253882
U15, U16, U17, U21: AP6230xZ6; SOT-563; Part Number AP62301Z6-7; JLCPCB ID C1880992
U18, U19: TAR5S33; SOT-23-5; Part Number TAR5S33TE85LF; JLCPCB ID C2762700
U20: AP2411SN; DFN-6-1EP_2x2mm_P0.65mm_EP1x1.6mm; Part Number AP2411SN-7; JLCPCB ID C2149815
X2: 24MHz_8pF_2x1.6mm; Crystal_2.0x1.6mm_4pin; Part Number ECS-240-8-37-CKM-TR3; JLCPCB ID C1986107

Connections:
+3V3: C12.1, C90.2, CON1.4 (VDD), J1.65, J1.66, J1.67, J1.68, L2.2, R1.1, R2.1, R63.2, U5.8 (VCC)
+5V: C14.2, C41.1, C45.2, C46.2, C47.2, C48.2, C49.2, J1.23, J1.24, J1.25, J1.26, J1.27, J1.28, J1.29, J1.30, J5.1, R60.1, U13.1 (VI), U15.1 (VIN), U16.1 (VIN), U17.1 (VIN), U18.5 (IN), U19.5 (IN), U21.1 (VIN)
/BOOT0: BOOT0_2.4, U2.Y17 (PI4-BOOT0)
/BOOT2: BOOT0_2.3, U2.Y15 (PI6-BOOT2)
/DDR_A0: U2.H20 (DDR_A0), U14.N3 (A0)
/DDR_A1: U2.N21 (DDR_A1), U14.P7 (A1)
/DDR_A2: U2.G20 (DDR_A2), U14.P3 (A2)
/DDR_A3: U2.H19 (DDR_A3), U14.N2 (A3)
/DDR_A4: U2.R19 (DDR_A4), U14.P8 (A4)
/DDR_A5: U2.F20 (DDR_A5), U14.P2 (A5)
/DDR_A6: U2.R21 (DDR_A6), U14.R8 (A6)
/DDR_A7: U2.J17 (DDR_A7), U14.R2 (A7)
/DDR_A8: U2.P19 (DDR_A8), U14.T8 (A8)
/DDR_A9: U2.G21 (DDR_A9), U14.R3 (A9)
/DDR_A10: U2.L18 (DDR_A10), U14.L7 (A10/AP)
/DDR_A11: U2.N17 (DDR_A11), U14.R7 (A11)
/DDR_A12: U2.M19 (DDR_A12), U14.N7 (A12/BC#)
/DDR_A13: U2.G19 (DDR_A13), U14.T3 (A13)
/DDR_A14: U2.N19 (DDR_A14), U14.T7 (A14)
/DDR_BA0: U2.J19 (DDR_BA0), U14.M2 (BA0)
/DDR_BA1: U2.P20 (DDR_BA1), U14.N8 (BA1)
/DDR_BA2: U2.H18 (DDR_BA2), U14.M3 (BA2)
/DDR_CASN: U2.L19 (DDR_CASN), U14.K3 (CAS#)
/DDR_CKE: R67.2, U2.N20 (DDR_CKE), U14.K9 (CKE)
/DDR_CLK_N: R68.2, U2.L20 (DDR_CLKN), U14.K7 (CK#)
/DDR_CLK_P: R68.1, U2.M20 (DDR_CLKP), U14.J7 (CK)
/DDR_CSN: U2.J20 (DDR_CSN), U14.L2 (CS#)
/DDR_DQ0: U2.B21 (DDR_DQ0), U14.A7 (DQU4)
/DDR_DQ1: U2.B20 (DDR_DQ1), U14.B8 (DQU6)
/DDR_DQ2: U2.D19 (DDR_DQ2), U14.D7 (DQU0)
/DDR_DQ3: U2.E19 (DDR_DQ3), U14.A3 (DQU7)
/DDR_DQ4: U2.B19 (DDR_DQ4), U14.C8 (DQU2)
/DDR_DQ5: U2.D20 (DDR_DQ5), U14.A2 (DQU5)
/DDR_DQ6: U2.E20 (DDR_DQ6), U14.C2 (DQU3)
/DDR_DQ7: U2.F19 (DDR_DQ7), U14.C3 (DQU1)
/DDR_DQ8: U2.T20 (DDR_DQ8), U14.E3 (DQL0)
/DDR_DQ9: U2.U20 (DDR_DQ9), U14.H3 (DQL4)
/DDR_DQ10: U2.T19 (DDR_DQ10), U14.G2 (DQL6)
/DDR_DQ11: U2.W20 (DDR_DQ11), U14.H8 (DQL5)
/DDR_DQ12: U2.W19 (DDR_DQ12), U14.F8 (DQL3)
/DDR_DQ13: U2.U19 (DDR_DQ13), U14.F2 (DQL2)
/DDR_DQ14: U2.Y21 (DDR_DQ14), U14.H7 (DQL7)
/DDR_DQ15: U2.Y20 (DDR_DQ15), U14.F7 (DQL1)
/DDR_DQM0: U2.D21 (DDR_DQM0), U14.D3 (DMU)
/DDR_DQM1: U2.W21 (DDR_DQM1), U14.E7 (DML)
/DDR_DQS0_N: U2.C21 (DDR_DQS0N), U14.B7 (DQSU#)
/DDR_DQS0_P: U2.C20 (DDR_DQS0P), U14.C7 (DQSU)
/DDR_DQS1_N: U2.V21 (DDR_DQS1N), U14.G3 (DQSL#)
/DDR_DQS1_P: U2.V20 (DDR_DQS1P), U14.F3 (DQSL)
/DDR_ODT: U2.J21 (DDR_ODT), U14.K1 (ODT)
/DDR_RASN: U2.K20 (DDR_RASN), U14.J3 (RAS#)
/DDR_RESETN: R69.2, U2.H17 (DDR_RESETN), U14.T2 (RESET#)
/DDR_WEN: U2.K19 (DDR_WEN), U14.L3 (WE#)
/DEBUG0: J4.5, U2.B13 (PB5)
/DEBUG1: J4.7, U2.C13 (PC7)
/DEBUG2: JP3.3 (B), U2.B10 (PG4)
/DEBUG3: JP2.1 (A), U2.A16 (PF0)
/DFU_BOOT: R72.1, S3.4, U2.A7 (PG0)
/FLASH_CLK: U2.H3 (PF10), U5.6 (CLK)
/FLASH_CS: U2.J3 (PB2), U5.1 (~CS)
/FLASH_IO0: U2.F1 (PF8), U5.5 (IO0/SI)
/FLASH_IO1: U2.J5 (PF9), U5.2 (IO1/SO)
/FLASH_IO2: U2.G1 (PF6), U5.3 (IO2/~WP)
/FLASH_IO3: U2.J1 (PH7), U5.7 (IO3/~HOLD/~RESET)
/JTCK_SWCLK: J6.4, U2.Y2 (PF14)
/JTDI: J6.8, U2.Y19 (PH4)
/JTDO_SWO: J6.6, U2.W18 (PH5)
/JTMS_SWDIO: J6.2, U2.Y12 (PF15)
/JTRST: JP1.1 (A), U2.V11 (NJTRST)
/NRST: C21.2, D1.1 (K), D11.1 (K), D26.1 (K), JP1.3 (B), S2.3, S2.4, U2.Y11 (NRST)
/PA0: J2.31, J2.32, U2.Y3 (PA0)
/PA1: J2.33, J2.34, U2.AA3 (PA1)
/PA2: J2.35, J2.36, U2.Y4 (PA2)
/PA3: J2.53, J2.54, U2.W9 (PA3)
/PA4: J2.41, J2.42, U2.AA6 (PA4)
/PA5: J2.37, J2.38, U2.Y5 (PA5)
/PA6: J2.57, J2.58, U2.U10 (PA6)
/PA7: J2.29, J2.30, U2.V6 (PA7)
/PA9: J2.5, J2.6, U2.A2 (PA9)
/PA10: J1.63, J1.64, U2.AA19 (PA10)
/PA11: J1.55, J1.56, U2.Y1 (PA11)
/PB1: J2.47, J2.48, U2.Y8 (PB1)
/PB4: J1.1, J1.2, U2.C16 (PB4)
/PB6: J2.13, J2.14, U2.C1 (PB6)
/PB8: J1.3, J1.4, U2.D1 (PB8)
/PB9: CON1.10 (SDDET1), J1.11, J1.12, U2.A15 (PB9)
/PB14: J1.39, J1.40, U2.B16 (PB14)
/PB15: J1.5, J1.6, U2.B15
/PC1: J2.49, J2.50, U2.Y9 (PC1)
/PC2: J2.61, J2.62, U2.AA10 (PC2)
/PC3: J2.55, J2.56, U2.W6 (PC3)
/PC4: J2.43, J2.44, U2.Y7 (PC4)
/PC5: J2.45, J2.46, U2.AA7 (PC5)
/PC8: CON1.7 (DAT0), J1.7, J1.8, R1.2, U2.C18 (PC8)
/PC9: CON1.8 (DAT1), J1.9, J1.10, U2.A20 (PC9)
/PC10: CON1.1 (DAT2), J1.13, J1.14, U2.A18 (PC10)
/PC11: CON1.2 (CD/DAT3), J1.15, J1.16, U2.B18 (PC11)
/PC12: CON1.5 (CLK), J1.19, J1.20, U2.A19 (PC12)
/PD0: J1.43, J1.44, U2.B1 (PD0)
/PD2: CON1.3 (CMD), J1.17, J1.18, R2.2, U2.C19 (PD2)
/PD3: J1.41, J1.42, U2.C2 (PD3)
/PD6: J1.49, J1.50, U2.D2 (PD6)
/PD7: J2.71, J2.72, U2.V1 (PD7)
/PD12: J1.61, J1.62, U2.A6 (PD12)
/PD14: J2.3, J2.4, U2.C4 (PD14)
/PE5: J1.57, J1.58, U2.W10 (PE5)
/PE8: J1.59, J1.60, U2.B9 (PE8)
/PE11: J1.45, J1.46, U2.B2 (PE11)
/PE12: J2.1, J2.2, U2.A4 (PE12)
/PE13: J2.17, J2.18, U2.A3 (PE13)
/PF1: J2.15, J2.16, U2.B11 (PF1)
/PF3: J2.11, J2.12, U2.A13 (PF3)
/PF11: J2.39, J2.40, U2.Y6 (PF11)
/PF12: J2.59, J2.60, U2.AA4 (PF12)
/PG2: J2.69, J2.70, U2.V3 (PG2)
/PG7: J2.21, J2.22, U2.A10 (PG7)
/PG10: J1.51, J1.52, U2.G2 (PG10)
/PG12: J2.75, J2.76, U2.W2 (PG12)
/PG13: J2.51, J2.52, U2.AA9 (PG13)
/PH3: J2.73, J2.74, U2.R3 (PH3)
/PH8: J2.9, J2.10, U2.E3 (PH8)
/PH12: J1.47, J1.48, U2.D3 (PH12)
/PH13: J2.19, J2.20, U2.A12 (PH13)
/PH14: J2.7, J2.8, U2.B8 (PH14)
/PWR_CPU_ONRST: D26.2 (A), R77.2, U21.5 (EN)
/PWR_ON: R6.1, R76.1, U2.U17 (PWR_ON), U15.5 (EN)
/PWR_ONRST: D11.2 (A), R76.2, U17.5 (EN)
/PWR_ONRST2: D1.2 (A), R6.2, U16.5 (EN)
/UART7_RX: J4.3, U2.C14 (PB3)
/UART7_TX: J4.1, U2.E2 (PH2)
/USB_HS_D+: J1.75, J1.76, J3.A6 (D+1), J3.B6 (D+2), U3.6 (I/O1)
/USB_HS_D-: J1.77, J1.78, J3.A7 (D-1), J3.B7 (D-2), U3.4 (I/O2)
/USB_HS_DM: U2.AA16 (USB_DM1), U3.3 (I/O2)
/USB_HS_DP: U2.Y16 (USB_DP1), U3.1 (I/O1)
/USB_RREF: R3.2, U2.W12 (USB_RREF)
/USB_VBUS: R4.2, R5.1, U2.AA20 (PI7)
/USB_VBUS_JACK: J1.71, J1.72, J3.A4B9 (VBUS1), J3.B4A9 (VBUS3), J5.2, R4.1, U3.5 (VBUS)
GND: C1.2, C12.2, C13.1, C14.1, C21.1, C29.1, C32.1, C40.1, C42.2, C43.2, C46.1, C47.1, C48.1, C49.1, C56.2, C75.2, C76.1, C81.1, C83.1, C88.1, C89.1, C90.1, C91.1, C92.2, C94.2, C98.2, C99.2, C102.2, C103.2, C106.2, C109.1, C110.1, C111.1, C174.2, C175.2, C176.2, C177.2, C182.2, C183.2, C184.2, C185.2, C186.2, C187.2, C188.2, C189.2, C190.2, C191.2, C192.2, C193.2, C194.2, C195.2, C196.2, C197.2, C198.2, C199.2, C200.2, C201.2, C202.2, C203.2, C204.2, C205.2, C206.2, C207.2, C208.2, C209.2, C211.2, C212.2, C213.2, C215.2, CON1.6 (VSS), CON1.9 (SHELL1), CON1.11 (SDDET2), J1.21, J1.22, J1.31, J1.32, J1.33, J1.34, J1.35, J1.36, J1.37, J1.38, J1.53, J1.54, J1.69, J1.70, J1.73, J1.74, J1.79, J1.80, J2.23, J2.24, J2.67, J2.68, J2.77, J2.78, J2.79, J2.80, J3.A1B12 (GND1), J3.B1A12 (GND3), J3.SH1 (Shield1), J3.SH2 (Shield2), J3.SH3 (Shield3), J3.SH4 (Shield4), J4.2, J4.8, J6.3, J6.5, J6.9, JP2.3 (B), JP3.1 (A), NT2.2, R3.1, R5.2, R10.2, R11.2, R52.2, R59.1, R62.1, R64.1, R66.1, R67.1, R69.1, R71.2, R72.2, R79.2, R81.1, S2.1, S2.2, TP1.1, U2.A1 (VSS), U2.A21 (VSS), U2.AA1 (VSS), U2.AA15 (PI5-BOOT1), U2.AA18 (VSS_PLL2), U2.AA21 (VSS), U2.B12 (VSS), U2.D16 (VSS), U2.E5 (VSS), U2.E6 (VSS), U2.E11 (VSS), U2.E16 (VSS), U2.F5 (VSS), U2.F17 (VSS), U2.F18 (VSS), U2.F21 (VSS), U2.G8 (VSS), U2.G12 (VSS), U2.G14 (VSS), U2.H7 (VSS), U2.H15 (VSS), U2.J10 (VSS), U2.J12 (VSS), U2.K1 (VSS_PLL), U2.K9 (VSS), U2.K10 (VSS), U2.K11 (VSS), U2.K12 (VSS), U2.K13 (VSS), U2.K21 (VSS), U2.L5 (VSS), U2.L10 (VSS), U2.L12 (VSS), U2.L15 (VSS), U2.L17 (VSS), U2.M1 (VSS), U2.M7 (VSS), U2.M9 (VSS), U2.M10 (VSS), U2.M11 (VSS), U2.M12 (VSS), U2.M13 (VSS), U2.N11 (VSS), U2.P7 (VSS), U2.P15 (VSS), U2.R8 (VSS), U2.R11 (VSS), U2.R14 (VSS), U2.T1 (VSS), U2.T5 (VSS), U2.T17 (VSS), U2.T21 (VSS), U2.U3 (VSS_ANA), U2.U5 (VSS), U2.U6 (VSS), U2.U11 (VSS), U2.U13 (VSS), U2.U16 (VSS), U2.V16 (VSS), U2.W16 (VSS), U2.W17 (BYPASS_REG1V8), U2.Y14 (VSS_USBHS), U3.2 (GND), U5.4 (GND), U14.A9 (VSS), U14.B1 (VSSQ), U14.B3 (VSS), U14.B9 (VSSQ), U14.D1 (VSSQ), U14.D8 (VSSQ), U14.E1 (VSS), U14.E2 (VSSQ), U14.E8 (VSSQ), U14.F9 (VSSQ), U14.G1 (VSSQ), U14.G8 (VSS), U14.G9 (VSSQ), U14.J2 (VSS), U14.J8 (VSS), U14.M1 (VSS), U14.M9 (VSS), U14.P1 (VSS), U14.P9 (VSS), U14.T1 (VSS), U14.T9 (VSS), U15.3 (GND), U16.3 (GND), U17.3 (GND), U19.2 (GND), U20.2 (GND), U20.7 (EP), U21.3 (GND), X2.2, X2.4
GNDADC: C31.1, C33.1, C41.2, C44.2, C45.1, C72.2, C84.1, J2.25, J2.26, J2.65, J2.66, NT2.1, U2.U9 (VSSA), U2.V8 (VREF-), U13.3 (GND), U18.2 (GND)
unnamed: J3.A5 (CC1), R10.1
unnamed: J3.B5 (CC2), R11.1
unnamed: J4.4, JP3.2 (C)
unnamed: J4.6, JP2.2 (C)
unnamed: J6.10, JP1.2 (C)
unnamed: C110.2, U2.T3 (PH0-OSC_IN), X2.3
unnamed: C111.2, U2.U2 (PH1-OSC_OUT), X2.1
unnamed: R52.1, U2.R20 (DDR_ZQ)
unnamed: R77.1, U2.W3 (PWR_CPU_ON)
unnamed: C29.2, U2.V14 (VDDA1V1_REG)
unnamed: R59.2, U14.L8 (ZQ)
unnamed: C67.2, U15.4 (BST)
unnamed: R61.1, R62.2, U15.6 (FB)
unnamed: C67.1, L1.1, U15.2 (SW)
unnamed: C68.2, U16.4 (BST)
unnamed: R63.1, R64.2, U16.6 (FB)
unnamed: C68.1, L2.1, U16.2 (SW)
unnamed: C69.2, U17.4 (BST)
unnamed: R65.1, R66.2, U17.6 (FB)
unnamed: C69.1, L3.1, U17.2 (SW)
unnamed: C72.1, U18.3 (Noise)
unnamed: C56.1, R60.2, U19.1 (EN)
unnamed: C75.1, U19.3 (Noise)
unnamed: C24.2, U21.4 (BST)
unnamed: R80.1, R81.2, U21.6 (FB)
unnamed: C24.1, L4.1, U21.2 (SW)
VDD: BOOT0_2.1, BOOT0_2.2, C1.1, C88.2, C176.1, C185.1, C190.1, C197.1, C201.1, C202.1, C205.1, C207.1, C208.1, C209.1, C215.1, J6.1, S3.1, U2.AA12 (PDR_ON), U2.C15 (VDDSD2), U2.E12 (VDD), U2.E17 (VDDSD1), U2.G9 (VDD), U2.G13 (VDD), U2.J7 (VDD), U2.J9 (VDD), U2.J13 (VDD), U2.K2 (VDD_PLL), U2.L2 (VBAT), U2.M5 (VDD), U2.N7 (VDD), U2.N9 (VDD), U2.N12 (VDD), U2.R5 (VDD), U2.R7 (VDD), U2.R9 (VDD), U2.R12 (VDD), U2.U7 (VDD), U2.V2 (VDD_ANA), U2.W11 (VDD), U2.Y18 (VDD_PLL2), U18.1 (EN), U19.4 (OUT), U20.1 (IN)
VDDA: C31.2, C84.2, U2.U8 (VDDA), U18.4 (OUT)
VDDA_1V8: C32.2, U2.W15 (VDDA1V8_REG), U20.3 (EN)
VDD_CORE: C89.2, C188.1, C189.1, C195.1, C196.1, C199.1, C200.1, C203.1, C213.1, L1.2, R61.2, U2.G11 (VDD_CORE), U2.J11 (VDD_CORE), U2.J15 (VDD_CORE), U2.L7 (VDD_CORE), U2.L9 (VDD_CORE), U2.L13 (VDD_CORE), U2.N10 (VDD_CORE), U2.N13 (VDD_CORE), U2.N15 (VDD_CORE), U2.R10 (VDD_CORE), U2.R13 (VDD_CORE), U2.U12 (VDD_CORE), U2.U14 (VDD_CORE)
VDD_CPU: C40.2, C174.1, C177.1, C183.1, C186.1, C187.1, C191.1, C194.1, L4.2, R80.2, U2.E7 (VDD_CPU), U2.E10 (VDD_CPU), U2.G5 (VDD_CPU), U2.G7 (VDD_CPU), U2.G10 (VDD_CPU), U2.K5 (VDD_CPU), U2.K7 (VDD_CPU)
VDD_DDR: C81.2, C83.2, C91.2, C92.1, C94.1, C98.1, C99.1, C102.1, C103.1, C106.1, C175.1, C182.1, C184.1, C192.1, C193.1, C198.1, C204.1, C206.1, C211.1, C212.1, L3.2, R65.2, R70.1, R78.1, U2.E15 (VDDQ_DDR), U2.G15 (VDDQ_DDR), U2.G17 (VDDQ_DDR), U2.K15 (VDDQ_DDR), U2.K17 (VDDQ_DDR), U2.M15 (VDDQ_DDR), U2.M17 (VDDQ_DDR), U2.R15 (VDDQ_DDR), U2.R17 (VDDQ_DDR), U2.U15 (VDDQ_DDR), U14.A1 (VDDQ), U14.A8 (VDDQ), U14.B2 (VDD), U14.C1 (VDDQ), U14.C9 (VDDQ), U14.D2 (VDDQ), U14.D9 (VDD), U14.E9 (VDDQ), U14.F1 (VDDQ), U14.G7 (VDD), U14.H2 (VDDQ), U14.H9 (VDDQ), U14.K2 (VDD), U14.K8 (VDD), U14.N1 (VDD), U14.N9 (VDD), U14.R1 (VDD), U14.R9 (VDD)
VDD_USB: C76.2, U2.W14 (VDD3V3_USBHS), U20.5 (OUT)
VREF+: C33.2, C44.1, J2.27, J2.28, J2.63, J2.64, U2.W7 (VREF+), U13.2 (VO)
VREF_DDR: C13.2, C42.1, C43.1, C109.2, R70.2, R71.1, R78.2, R79.1, U2.T18 (DDR_VREF), U14.H1 (VREFDQ), U14.M8 (VREFCA)

Notes on the sheet:
I2C1_SCL
ADC-3
DFU Boot requires MP1-DFU-USB bootloader installed
SDMMC_CMD
I2C3_SCL
ADC2-2
microSD
SDMMC_D0
ADC-14
I2C3_SDA
ADC-5
SAI1_SD_B
ADC-17
ADC-12
1.22V - 1.38V, 1.35V for 1GHz. Rank 2?3? Ratio for 1.35V: 1.45:1 (14.7k/10k =>= 1.344V)
SAI1_FS
ADC-8
SAI1_MCLK
ADC-6
POWER
SDMMC_D3
SD_CARD_DETECT
I2C5_SDA
ADC-2
SPI3_NSS
BOOT SWITCHES
ADC-13
SDMMC_CLK
mp153
AN5586, Sec 5.3.1 The VDDCPU can always be set at 1.35 V allowing the CPU to work in Run mode (CPU frequency lower than 650 MHz) and in Run overdrive mode (CPU frequency higher than 650 MHz). This simplifies the VDDCPU VRM design to manage a single output voltage (1.35 V) and to free the PWR_OVRDRV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
SPI1-MOSI
SPI4_MOSI
SPI3-SCK
SAI1_SD_A
SPI3-MISO
SWD PROGRAMMING
SPI3_MOSI
Place these on pins:
3.3V for peripherals Rank 2
ADC-1
SAI1_SCK
SDMMC_D2
CONNECTORS
1.35V and 0.65V for DDR3 Turns on after Vddcore is stable Power cycle on reset Datasheet recommends 1.5uH (AP623) or 2.2uH (AP622)
ADC-15
ADC-7
ADC-16
3.3V, Rank 3 VDD3V3_USB turns on when VDDA_1V8 is present, which is powered by VDD.
TIM1_CH3
SAI2_SCK_A
AN5474, Sec 2.2: VDD_PLL and VDD_ANA must be connected to VDD.
I2C1_SDA
Analog 3.3V Turns on after Vdd
ADC-10
ADC-4
USB
SPI1-MISO
SDMMC_D1
-DK2: R125 not fitted
PROCESSOR
TIM15.2/2.4/5.4 PWM
1.21V - 1.29V, 1.25V typical. Rank 2 IDDCORE_{max} = ? (mp15x=1050mA) Ratio for 1.25V: 1.777:1 or 0.5625:1 (17.8k/10k) Ratio for 1.26V: 1.74:1 (17.4k/10k) Datasheet recommends 1.5uH (AP623) or 2.2uH (AP622)
SPI1-SCK
DEVBOARD
SPI1-NSS
DDR RAM
To connect to VDD_DDR power plane
Turn-on at EN=1.5V @100k/100nF: t = 1.3ms
BOOT0 BOOT2 SD Card On On Flash On Off Debugger Off On
ON = allow USB jack to provide +5V to board
I2C5_SCL
Reset
SPI2_MISO
AN5474, sec 8.8: If VDD = 3.3 V, VDD_SD can be connected to VDD to save a power supply source.
ADC2-6
Debugging
+3.3V Rank 1 18mA typ, with >25mA peak
TIM3.1/13.1
