4ms/mp153-devboard/v0.4-mp133/mp133-devboard.kicad_pcb

## KiCad design v0.4-mp133/mp133-devboard.kicad_pcb (continued)

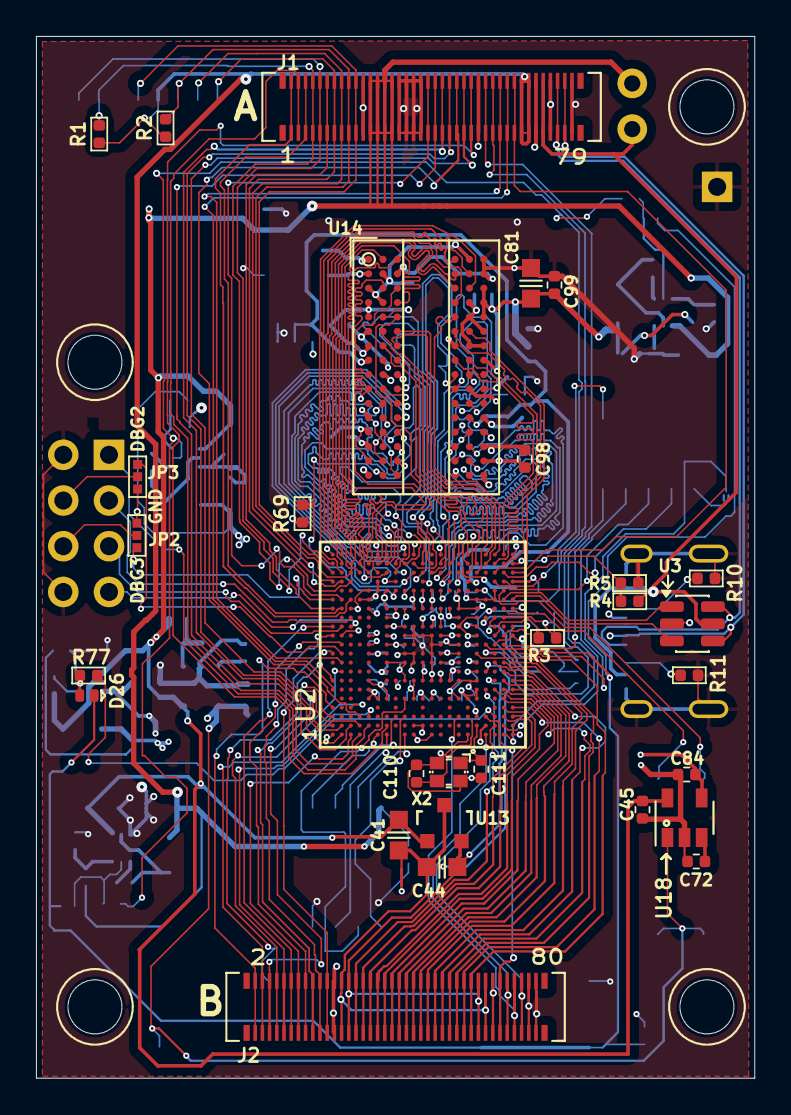
[picture p12: board mp133-devboard.kicad_pcb from above]

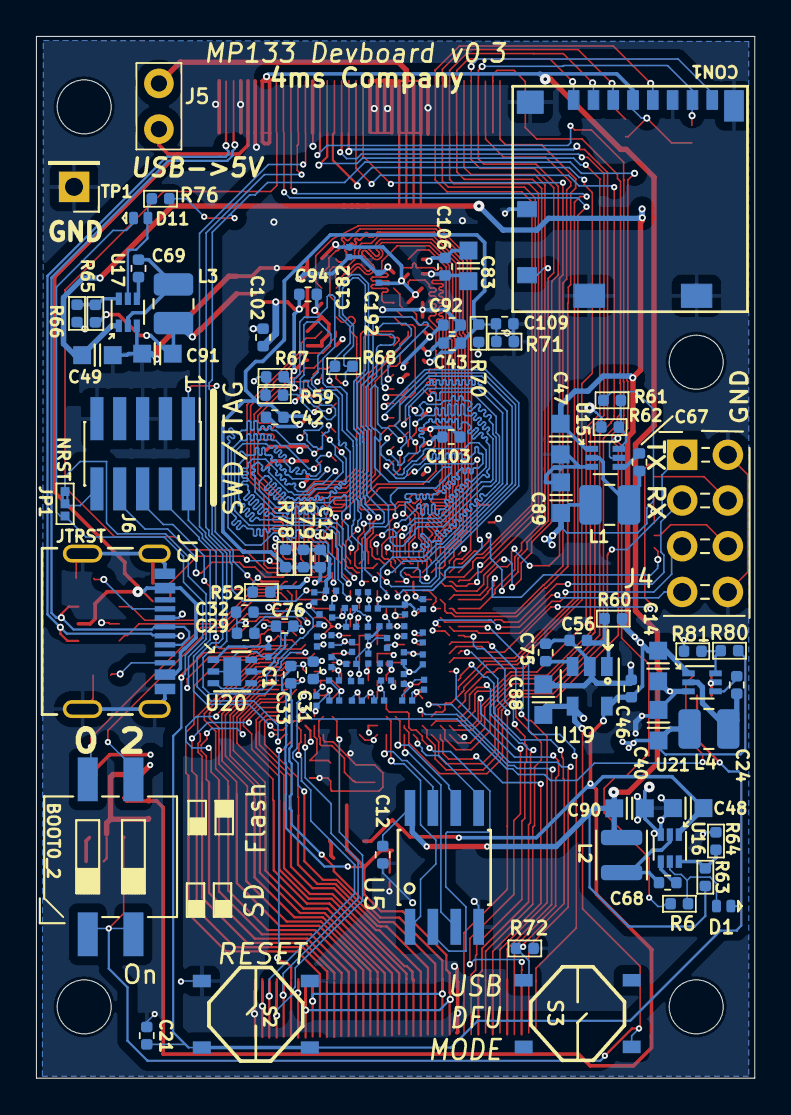
[picture p13: board mp133-devboard.kicad_pcb from below]

Board: 4 copper layers, 39.9 x 57.9 mm, 148 parts (113 on the bottom side), 174 nets.
