4ms/mp153-devboard/carrier-breakout/v0.1/mp153-carrier-board.kicad_pcb

## KiCad design carrier-breakout/v0.1/mp153-carrier-board.kicad_pcb (2025-12-29)

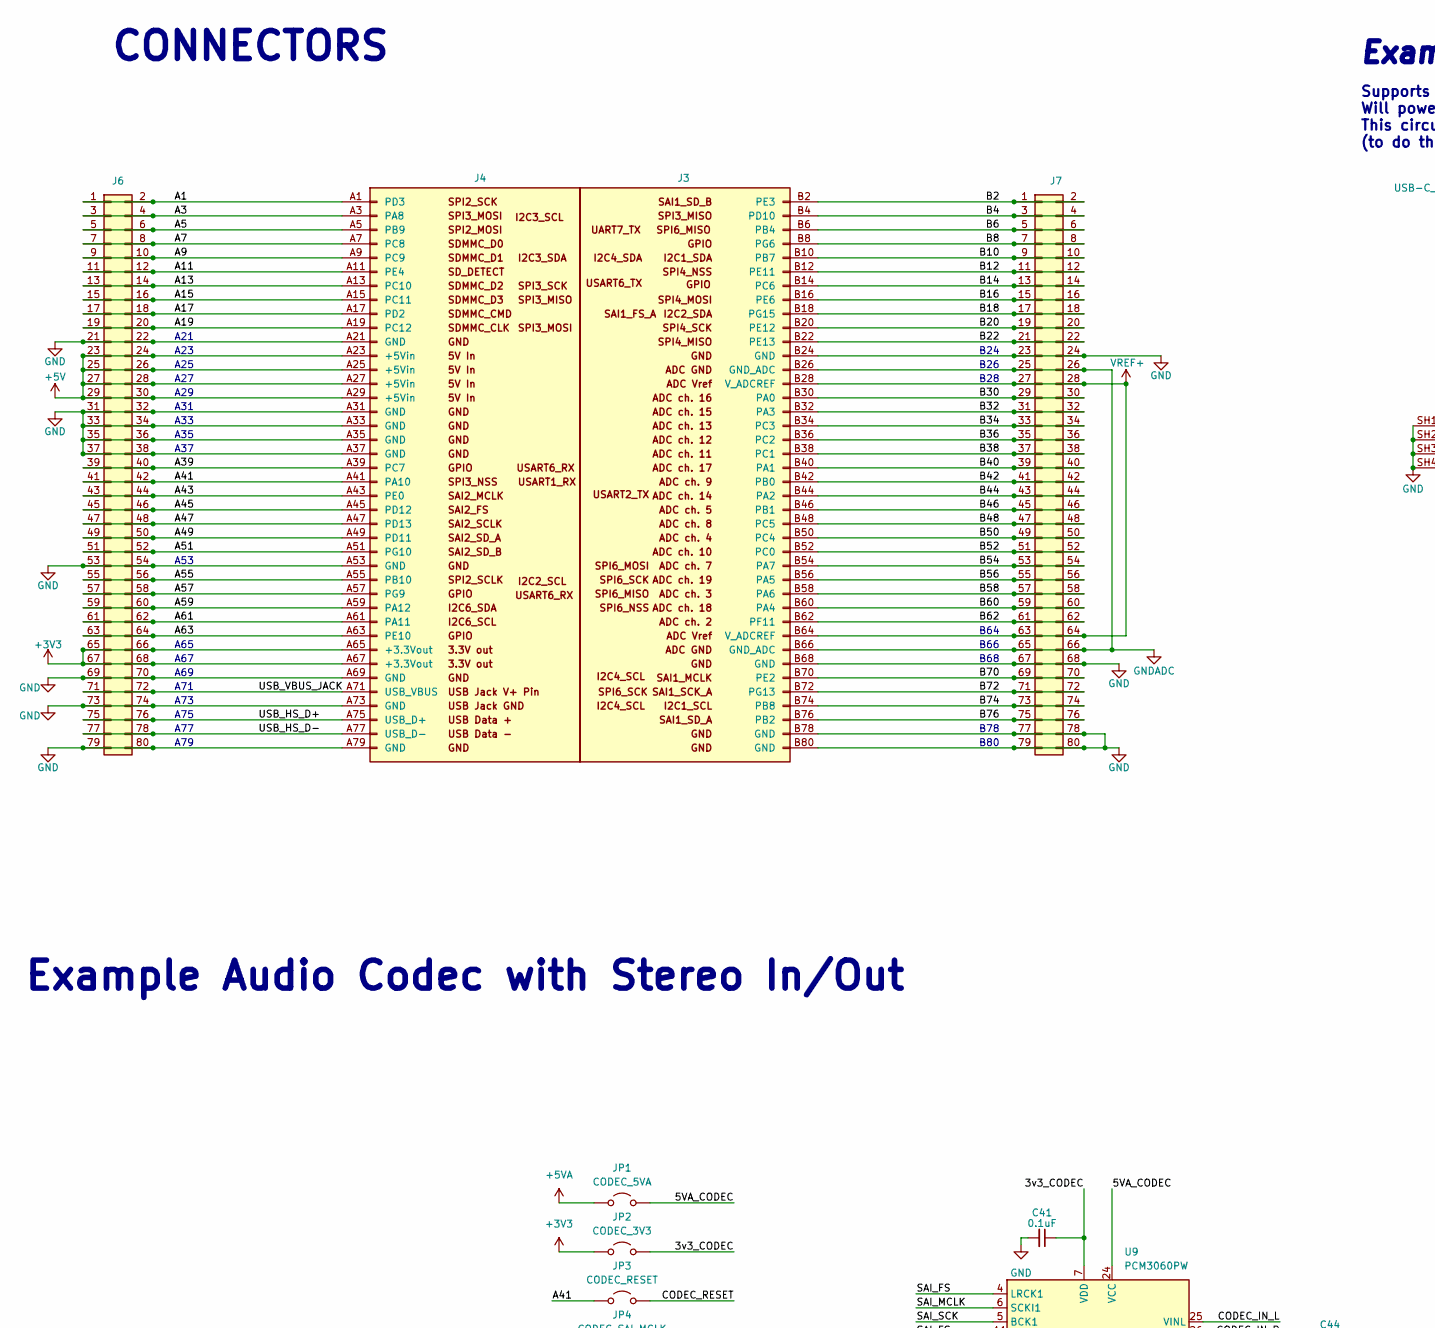
[picture p14: schematic mp153-carrier-board.kicad_sch, part in row 1, column 1]

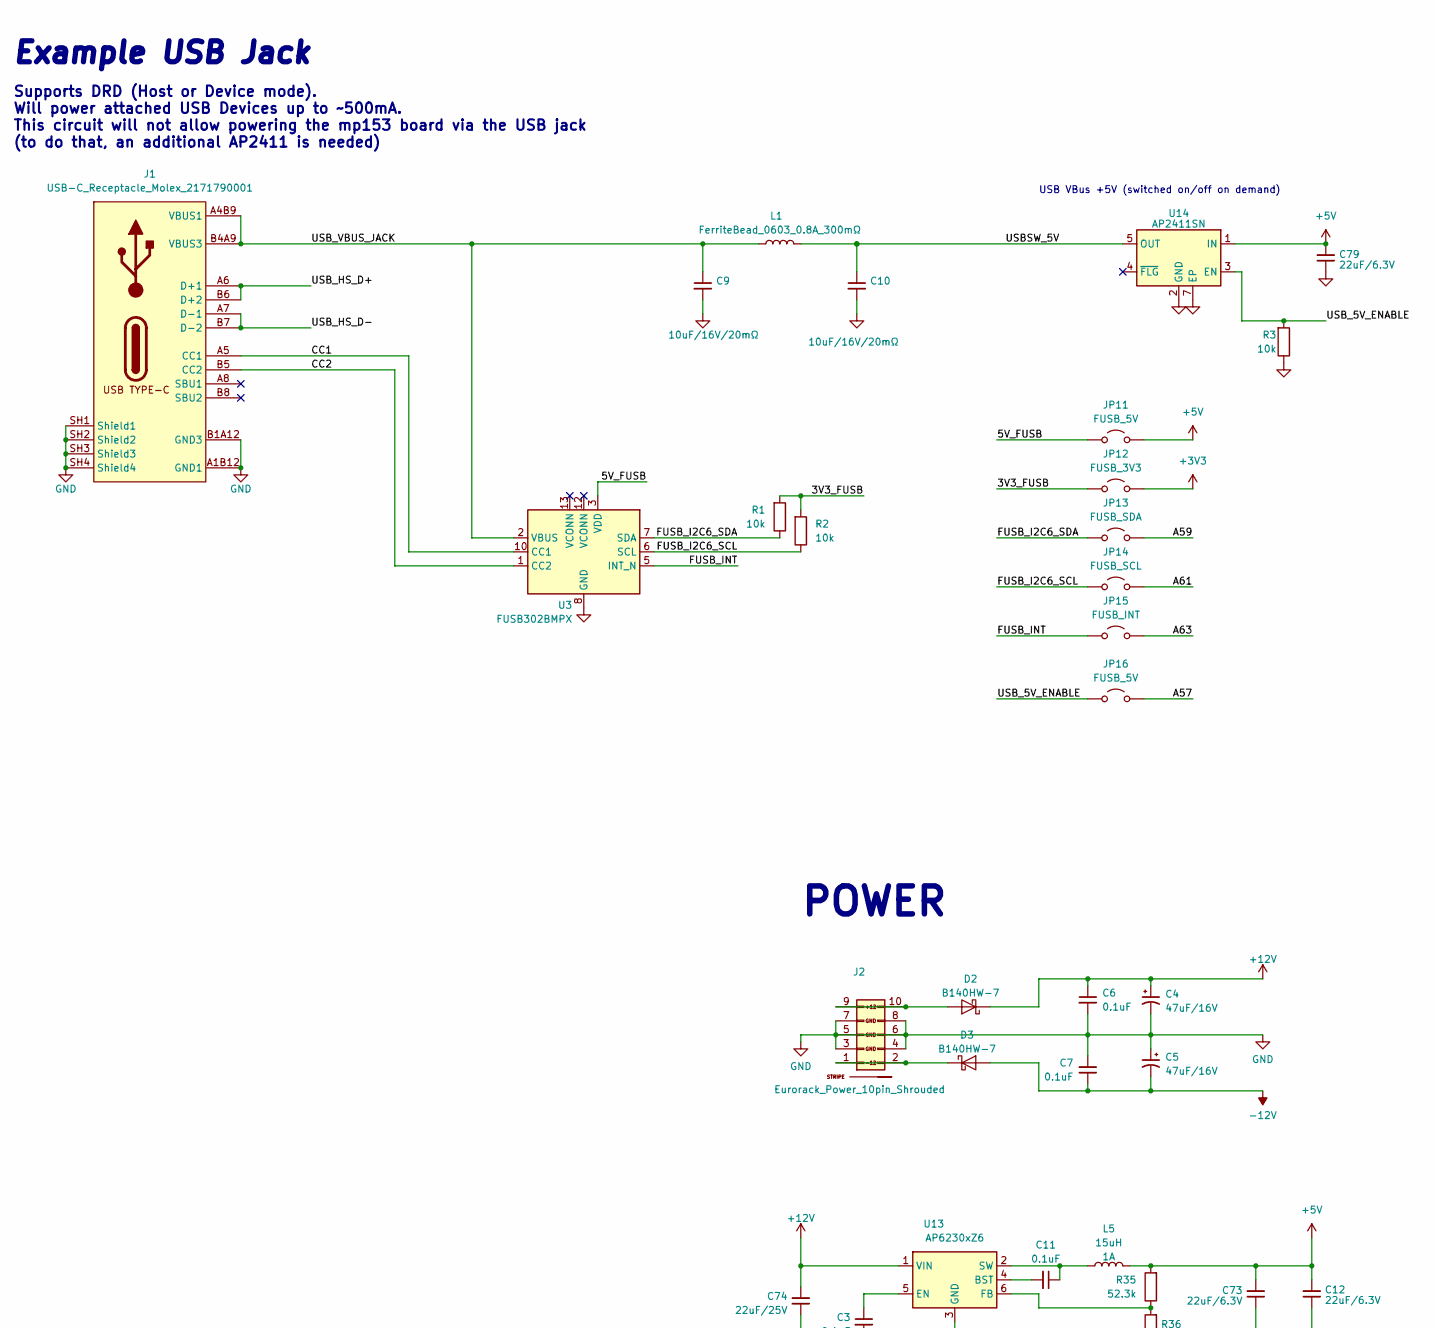
[picture p15: schematic mp153-carrier-board.kicad_sch, part in row 1, column 2]

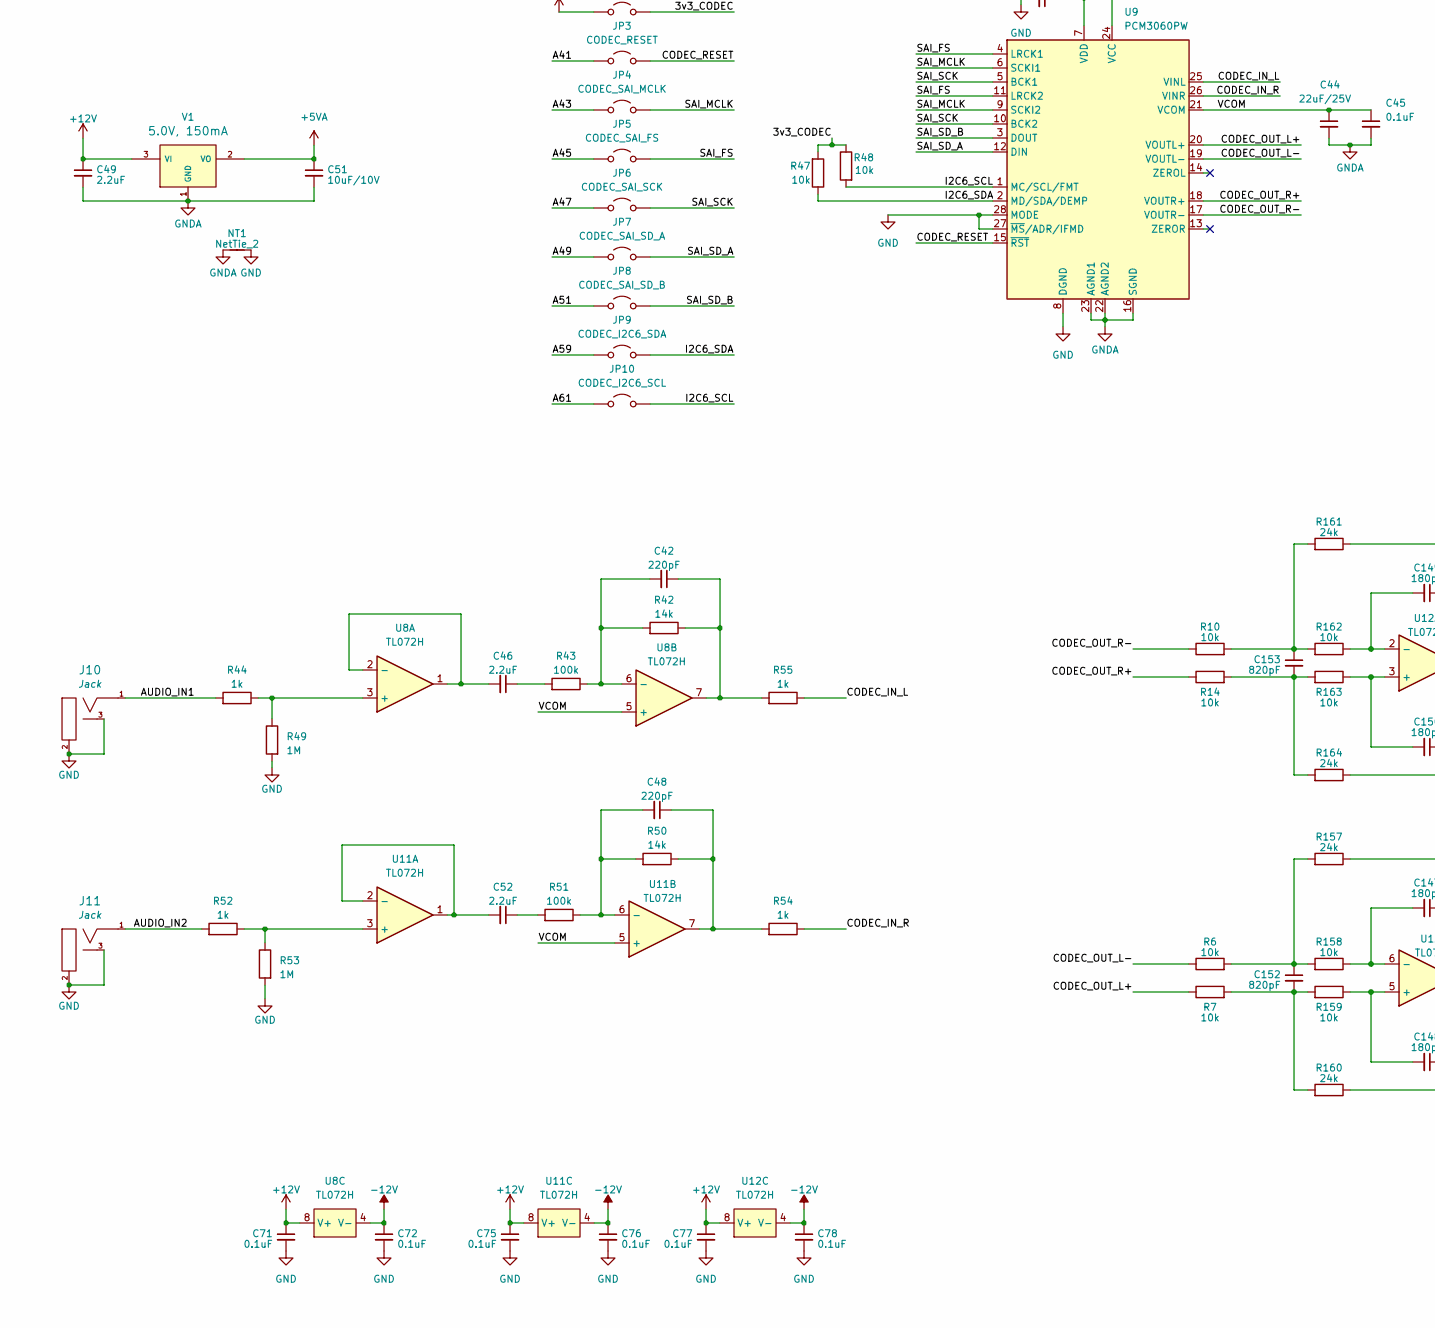
[picture p16: schematic mp153-carrier-board.kicad_sch, part in row 2, column 1]

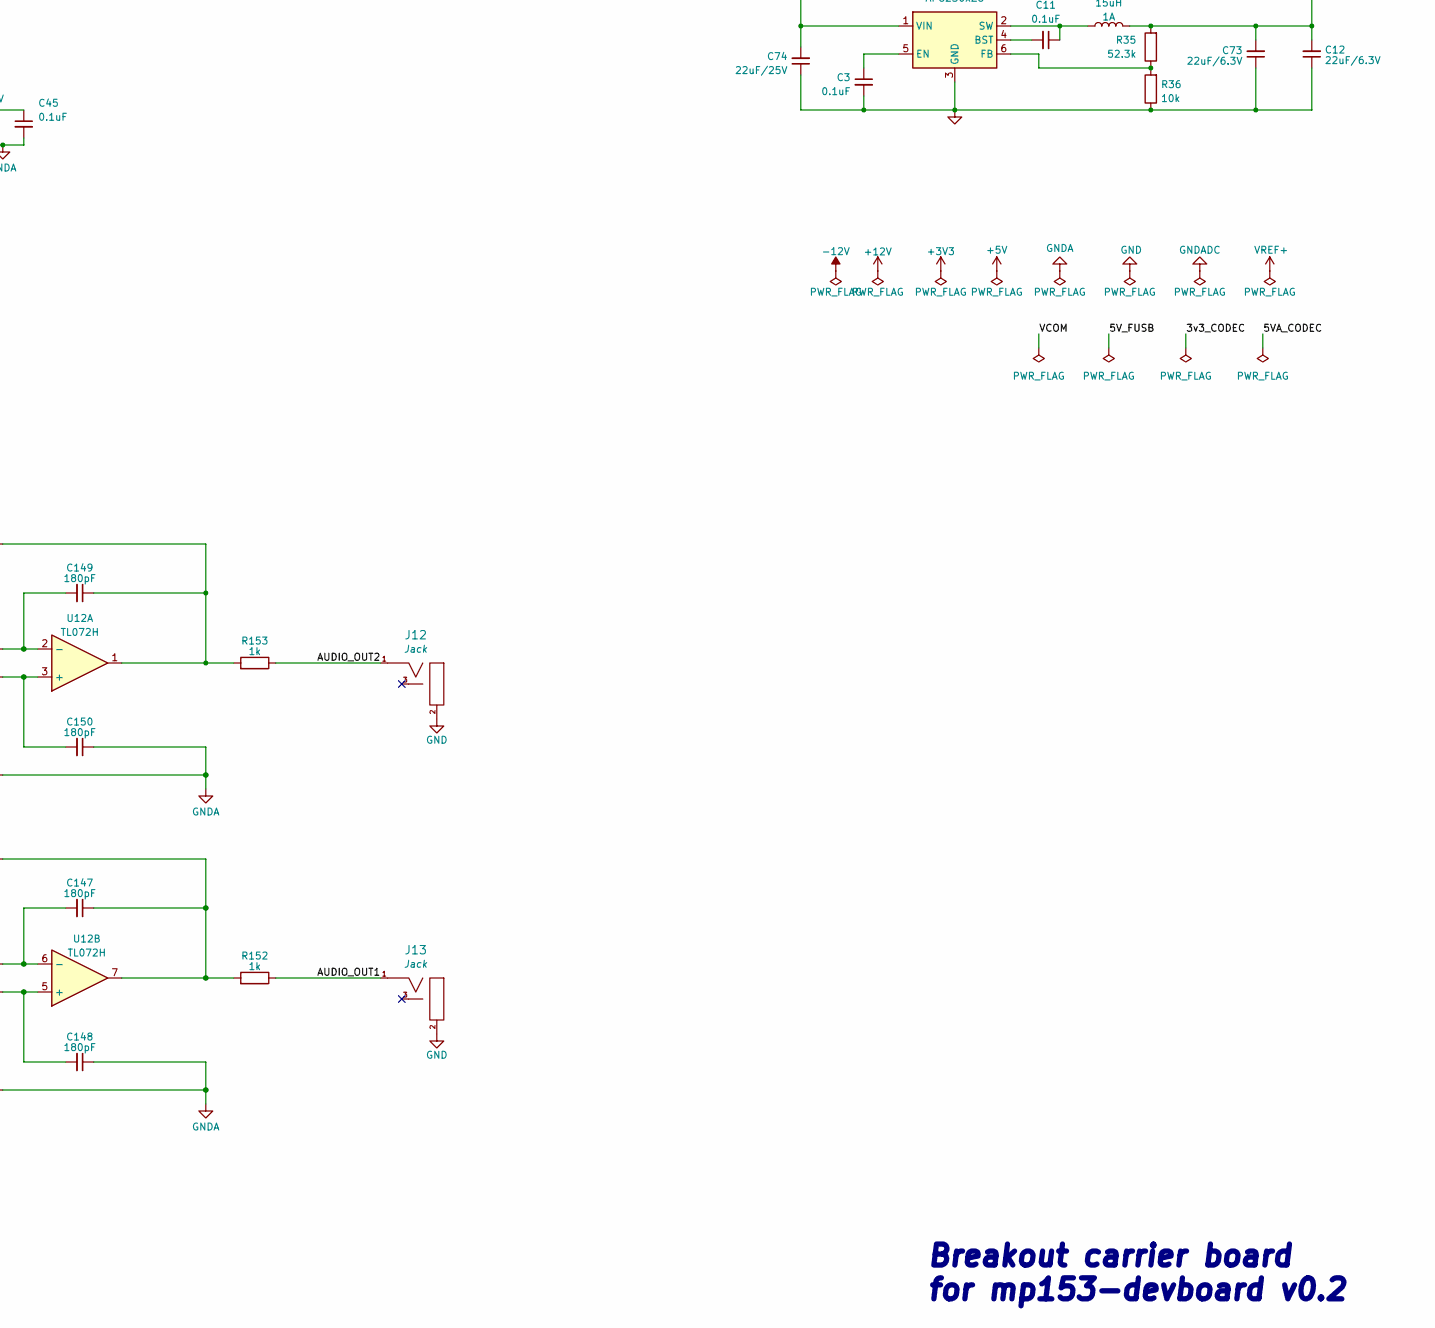
[picture p17: schematic mp153-carrier-board.kicad_sch, part in row 2, column 2]

Parts:
C3, C11, C41, C45: 100nF_0402_50V; C_0402; Part Number GCM155R71C104KA55D; JLCPCB ID C1525
C4, C5: 47uF_5x5.3_16V; CP_Elec_5x5.3; Part Number VES470M1CTR-0505; JLCPCB ID C134798
C6, C7: 100nF_0603_16V; C_0603; Part Number 0603YC104KAT2A; JLCPCB ID C14663
C9, C10: 10uF_0805_16V_lowESR; C_0805; Part Number EMK212ABJ106KG-T; JLCPCB ID C190442
C12, C73, C79: 22uF_0603_6.3V; C_0603; Part Number GRM188R60J226MEA0J; JLCPCB ID C59461
C42, C48: 220pF_0603_25V; C_0603; Part Number CC0603JRNPO9BN221; JLCPCB ID C1603
C44: 22uF_0805_25V; C_0805; Part Number GRM21BR61E226ME44L; JLCPCB ID C45783
C46, C49, C52: 2.2uF_0603_25V; C_0603; Part Number GRM188R6YA225KA12D; JLCPCB ID C57895
C51: 10uF_0603_10V; C_0603; Part Number GRM188R61A106KE69D; JLCPCB ID C19702
C71, C72, C75, C76, C77, C78: 100nF_0402_50V; C_0402; Part Number GRM155R71H104KE14D; JLCPCB ID C307331
C74: 22uF_0805_25V; C_1206; Part Number TMK316BBJ226ML-T; JLCPCB ID C12891
C147, C148, C149, C150: 180pF_0402_25V; C_0402; Part Number GRM1555C2A181JE01D; JLCPCB ID C106999
C152, C153: 820pF_0402_10v; C_0402; Part Number 0402ZC821KAT2A; JLCPCB ID C565563
D2, D3: B140HW-7; D_SOD-123; Part Number B140HW-7; JLCPCB ID C134429
J1: USB-C_Receptacle_Molex_2171790001; USB_C_Receptacle_Molex_2171790001; Part Number 217179-0001; JLCPCB ID C2894899
J2: Eurorack_Power_10pin_Shrouded; Pins_2x05_2.54mm_TH_EurorackPower_Shrouded; Part Number 61201021621
J3: mp153-devboard-sockets_B; Part Number DF40HC(3.0)-80DS-0.4V(51); JLCPCB ID C2858577
J4: mp153-devboard-sockets_A; Part Number DF40HC(3.0)-80DS-0.4V(51); JLCPCB ID C2858577
J6, J7: Pins_02x40_P2.54mm_TH; Pins_2x40_P2.54mm_TH
J10, J11, J12, J13: 3.5mm_Mono_Switched_sm; EighthInch_PJ398SM; Part Number WQP-WQP518MA
JP1, JP2, JP3, JP4, JP5, JP6, JP7, JP8, JP9, JP10, JP11, JP12, JP13, JP14, JP15, JP16: SolderJumper_2_Open; JUMPER_SMD_1x2_tiny
L1: FerriteBead_0603_0.8A_300mΩ; R_0603; Part Number MPZ1608S102ATA00; JLCPCB ID C76814
L5: 15uH_1A_5040; COIL_5040; Part Number SRN5040TA-150M; JLCPCB ID C222950
NT1: NetTie_2; NetTie-2_SMD_Pad0.5mm
R1, R2, R3, R6, R7, R10, R14, R36, R47, R48, R158, R159, R162, R163: 10k_0402; R_0402; Part Number RC0402FR-0710KL; JLCPCB ID C60490
R35: 52.3k_0402; R_0402; Part Number RC0402FR-0752K3L; JLCPCB ID C276275
R42, R50: 14k_0402; R_0402; Part Number RC0402FR-0714KL; JLCPCB ID C327372
R43, R51: 100k_0402; R_0402; Part Number RC0402FR-07100KL; JLCPCB ID C60491
R44, R52, R54, R55, R152, R153: 1k_0402; R_0402; Part Number RC0402FR-071KL; JLCPCB ID C106235
R49, R53: 1M_0402; R_0402; Part Number RC0402FR-071ML; JLCPCB ID C138033
R157, R160, R161, R164: 24k_0402; R_0402; Part Number RC0402FR-0724KL; JLCPCB ID C138026
U3: FUSB302BMPX; WQFN-14-1EP_2.5x2.5mm_P0.5mm_EP1.45x1.45mm; Part Number FUSB302BMPX; JLCPCB ID C132291
U8, U11, U12: TL072H; TSSOP-8_4.4x3mm_Pitch0.65mm; Part Number TL072HIPWR; JLCPCB ID C4370341
U9: PCM3060PW; TSSOP-28_4.4x9.7mm_P0.65mm; Part Number PCM3060PW; JLCPCB ID C2651841
U13: AP6230xZ6; SOT-563; Part Number AP62301Z6; JLCPCB ID C1880992
U14: AP2411SN; DFN-6-1EP_2x2mm_P0.65mm_EP1x1.6mm; Part Number AP2411SN-7; JLCPCB ID C2149815
V1: AP2120N-5.0TRG1; SOT23-3_PO132; Part Number AP2120N-5.0TRG1; JLCPCB ID C50754

Connections:
+3V3: J4.A65 (+3.3Vout), J4.A67 (+3.3Vout), J6.65, J6.66, J6.67, J6.68, JP2.1 (A), JP12.2 (B)
+5V: C12.2, C73.2, C79.2, J4.A23 (+5Vin), J4.A25 (+5Vin), J4.A27 (+5Vin), J4.A29 (+5Vin), J6.23, J6.24, J6.25, J6.26, J6.27, J6.28, J6.29, J6.30, JP11.2 (B), L5.2, R35.2, U14.1 (IN)
+5VA: C51.1, JP1.1 (A), V1.2 (VO)
+12V: C4.1, C6.1, C49.1, C71.1, C74.2, C75.1, C77.1, D2.1 (K), U8.8 (V+), U11.8 (V+), U12.8 (V+), U13.1 (VIN), V1.3 (VI)
-12V: C5.2, C7.1, C72.1, C76.1, C78.1, D3.2 (A), U8.4 (V-), U11.4 (V-), U12.4 (V-)
/3V3_FUSB: JP12.1 (A), R1.2, R2.2
/3v3_CODEC: C41.1, JP2.2 (B), R47.2, R48.1, U9.7 (VDD)
/5VA_CODEC: JP1.2 (B), U9.24 (VCC)
/5V_FUSB: JP11.1 (A), U3.3 (VDD), U3.4 (VDD)
/A1: J4.A1 (PD3), J6.1, J6.2
/A3: J4.A3 (PA8), J6.3, J6.4
/A5: J4.A5 (PB9), J6.5, J6.6
/A7: J4.A7 (PC8), J6.7, J6.8
/A9: J4.A9 (PC9), J6.9, J6.10
/A11: J4.A11 (PE4), J6.11, J6.12
/A13: J4.A13 (PC10), J6.13, J6.14
/A15: J4.A15 (PC11), J6.15, J6.16
/A17: J4.A17 (PD2), J6.17, J6.18
/A19: J4.A19 (PC12), J6.19, J6.20
/A39: J4.A39 (PC7), J6.39, J6.40
/A41: J4.A41 (PA10), J6.41, J6.42, JP3.1 (A)
/A43: J4.A43 (PE0), J6.43, J6.44, JP4.1 (A)
/A45: J4.A45 (PD12), J6.45, J6.46, JP5.1 (A)
/A47: J4.A47 (PD13), J6.47, J6.48, JP6.1 (A)
/A49: J4.A49 (PD11), J6.49, J6.50, JP7.1 (A)
/A51: J4.A51 (PG10), J6.51, J6.52, JP8.1 (A)
/A55: J4.A55 (PB10), J6.55, J6.56
/A57: J4.A57 (PG9), J6.57, J6.58, JP16.2 (B)
/A59: J4.A59 (PA12), J6.59, J6.60, JP9.1 (A), JP13.2 (B)
/A61: J4.A61 (PA11), J6.61, J6.62, JP10.1 (A), JP14.2 (B)
/A63: J4.A63 (PE10), J6.63, J6.64, JP15.2 (B)
/AUDIO_IN1: J10.1 (SIG), R44.2
/AUDIO_IN2: J11.1 (SIG), R52.2
/AUDIO_OUT1: J13.1 (SIG), R152.1
/AUDIO_OUT2: J12.1 (SIG), R153.1
/B2: J3.B2 (PE3), J7.1, J7.2
/B4: J3.B4 (PD10), J7.3, J7.4
/B6: J3.B6 (PB4), J7.5, J7.6
/B8: J3.B8 (PG6), J7.7, J7.8
/B10: J3.B10 (PB7), J7.9, J7.10
/B12: J3.B12 (PE11), J7.11, J7.12
/B14: J3.B14 (PC6), J7.13, J7.14
/B16: J3.B16 (PE6), J7.15, J7.16
/B18: J3.B18 (PG15), J7.17, J7.18
/B20: J3.B20 (PE12), J7.19, J7.20
/B22: J3.B22 (PE13), J7.21, J7.22
/B30: J3.B30 (PA0), J7.29, J7.30
/B32: J3.B32 (PA3), J7.31, J7.32
/B34: J3.B34 (PC3), J7.33, J7.34
/B36: J3.B36 (PC2), J7.35, J7.36
/B38: J3.B38 (PC1), J7.37, J7.38
/B40: J3.B40 (PA1), J7.39, J7.40
/B42: J3.B42 (PB0), J7.41, J7.42
/B44: J3.B44 (PA2), J7.43, J7.44
/B46: J3.B46 (PB1), J7.45, J7.46
/B48: J3.B48 (PC5), J7.47, J7.48
/B50: J3.B50 (PC4), J7.49, J7.50
/B52: J3.B52 (PC0), J7.51, J7.52
/B54: J3.B54 (PA7), J7.53, J7.54
/B56: J3.B56 (PA5), J7.55, J7.56
/B58: J3.B58 (PA6), J7.57, J7.58
/B60: J3.B60 (PA4), J7.59, J7.60
/B62: J3.B62 (PF11), J7.61, J7.62
/B70: J3.B70 (PE2), J7.69, J7.70
/B72: J3.B72 (PG13), J7.71, J7.72
/B74: J3.B74 (PB8), J7.73, J7.74
/B76: J3.B76 (PB2), J7.75, J7.76
/CC1: J1.A5 (CC1), U3.10 (CC1), U3.11 (CC1)
/CC2: J1.B5 (CC2), U3.1 (CC2), U3.14 (CC2)
/CODEC_IN_L: R55.1, U9.25 (VINL)
/CODEC_IN_R: R54.1, U9.26 (VINR)
/CODEC_OUT_L+: R7.1, U9.20 (VOUTL+)
/CODEC_OUT_L-: R6.1, U9.19 (VOUTL-)
/CODEC_OUT_R+: R14.1, U9.18 (VOUTR+)
/CODEC_OUT_R-: R10.1, U9.17 (VOUTR-)
/CODEC_RESET: JP3.2 (B), U9.15 (~RST)
/FUSB_I2C6_SCL: JP14.1 (A), R2.1, U3.6 (SCL)
/FUSB_I2C6_SDA: JP13.1 (A), R1.1, U3.7 (SDA)
/FUSB_INT: JP15.1 (A), U3.5 (INT_N)
/I2C6_SCL: JP10.2 (B), R48.2, U9.1 (MC/SCL/FMT)
/I2C6_SDA: JP9.2 (B), R47.1, U9.2 (MD/SDA/DEMP)
/SAI_FS: JP5.2 (B), U9.4 (LRCK1), U9.11 (LRCK2)
/SAI_MCLK: JP4.2 (B), U9.6 (SCKI1), U9.9 (SCKI2)
/SAI_SCK: JP6.2 (B), U9.5 (BCK1), U9.10 (BCK2)
/SAI_SD_A: JP7.2 (B), U9.12 (DIN)
/SAI_SD_B: JP8.2 (B), U9.3 (DOUT)
/USBSW_5V: C10.1, L1.1, U14.5 (OUT)
/USB_5V_ENABLE: JP16.1 (A), R3.2, U14.3 (EN)
/USB_HS_D+: J1.A6 (D+1), J1.B6 (D+2), J4.A75 (USB_D+), J6.75, J6.76
/USB_HS_D-: J1.A7 (D-1), J1.B7 (D-2), J4.A77 (USB_D-), J6.77, J6.78
/USB_VBUS_JACK: C9.1, J1.A4B9 (VBUS1), J1.B4A9 (VBUS3), J4.A71 (USB_VBUS), J6.71, J6.72, L1.2, U3.2 (VBUS)
/VCOM: C44.1, C45.1, U8.5 (+), U9.21 (VCOM), U11.5 (+)
GND: C3.2, C4.2, C5.1, C6.2, C7.2, C9.2, C10.2, C12.1, C41.2, C71.2, C72.2, C73.1, C74.1, C75.2, C76.2, C77.2, C78.2, C79.1, J1.A1B12 (GND1), J1.B1A12 (GND3), J1.SH1 (Shield1), J1.SH2 (Shield2), J1.SH3 (Shield3), J1.SH4 (Shield4), J2.3 (GND), J2.4 (GND), J2.5 (GND), J2.6 (GND), J2.7 (GND), J2.8 (GND), J3.B24 (GND), J3.B68 (GND), J3.B78 (GND), J3.B80 (GND), J4.A21 (GND), J4.A31 (GND), J4.A33 (GND), J4.A35 (GND), J4.A37 (GND), J4.A53 (GND), J4.A69 (GND), J4.A73 (GND), J4.A79 (GND), J6.21, J6.22, J6.31, J6.32, J6.33, J6.34, J6.35, J6.36, J6.37, J6.38, J6.53, J6.54, J6.69, J6.70, J6.73, J6.74, J6.79, J6.80, J7.23, J7.24, J7.67, J7.68, J7.77, J7.78, J7.79, J7.80, J10.2 (SHEILD), J10.3 (SW), J11.2 (SHEILD), J11.3 (SW), J12.2 (SHEILD), J13.2 (SHEILD), NT1.2, R3.1, R36.1, R49.2, R53.2, U3.8 (GND), U3.9 (GND), U3.15 (GND), U9.8 (DGND), U9.27 (~MS/ADR/IFMD), U9.28 (MODE), U13.3 (GND), U14.2 (GND), U14.7 (EP)
GNDA: C44.2, C45.2, C49.2, C51.2, C148.1, C150.1, NT1.1, R160.1, R164.1, U9.16 (SGND), U9.22 (AGND2), U9.23 (AGND1), V1.1 (GND)
GNDADC: J3.B26 (GND_ADC), J3.B66 (GND_ADC), J7.25, J7.26, J7.65, J7.66
unnamed: C42.1, R42.1, R55.2, U8.7
unnamed: C46.1, R43.2
unnamed: C48.1, R50.1, R54.2, U11.7
unnamed: C52.1, R51.2
unnamed: C147.1, R152.2, R157.1, U12.7
unnamed: C149.1, R153.2, R161.1, U12.1
unnamed: C152.1, R6.2, R157.2, R158.2
unnamed: C152.2, R7.2, R159.2, R160.2
unnamed: C153.1, R10.2, R161.2, R162.2
unnamed: C153.2, R14.2, R163.2, R164.2
unnamed: D2.2 (A), J2.9 (+12V), J2.10 (+12V)
unnamed: D3.1 (K), J2.1 (-12V), J2.2 (-12V)
unnamed: R44.1, R49.1, U8.3 (+)
unnamed: C46.2, U8.1, U8.2 (-)
unnamed: C42.2, R42.2, R43.1, U8.6 (-)
unnamed: R52.1, R53.1, U11.3 (+)
unnamed: C52.2, U11.1, U11.2 (-)
unnamed: C48.2, R50.2, R51.1, U11.6 (-)
unnamed: C150.2, R163.1, U12.3 (+)
unnamed: C149.2, R162.1, U12.2 (-)
unnamed: C148.2, R159.1, U12.5 (+)
unnamed: C147.2, R158.1, U12.6 (-)
unnamed: C11.2, U13.4 (BST)
unnamed: C3.1, U13.5 (EN)
unnamed: R35.1, R36.2, U13.6 (FB)
unnamed: C11.1, L5.1, U13.2 (SW)
VREF+: J3.B28 (V_ADCREF), J3.B64 (V_ADCREF), J7.27, J7.28, J7.63, J7.64

Notes on the sheet:
A73
A37
A33
A77
POWER
B80
A65
B64
A25
A71
A69
B28
B24
CONNECTORS
B26
B68
Supports DRD (Host or Device mode). Will power attached USB Devices up to ~500mA. This circuit will not allow powering the mp153 board via the USB jack (to do that, an additional AP2411 is needed)
A79
A75
Example USB Jack
A67
Example Audio Codec with Stereo In/Out
A31
A29
A21
Breakout carrier board for mp153-devboard v0.2
B78
B66
A35
USB VBus +5V (switched on/off on demand)
A53
A23
A27

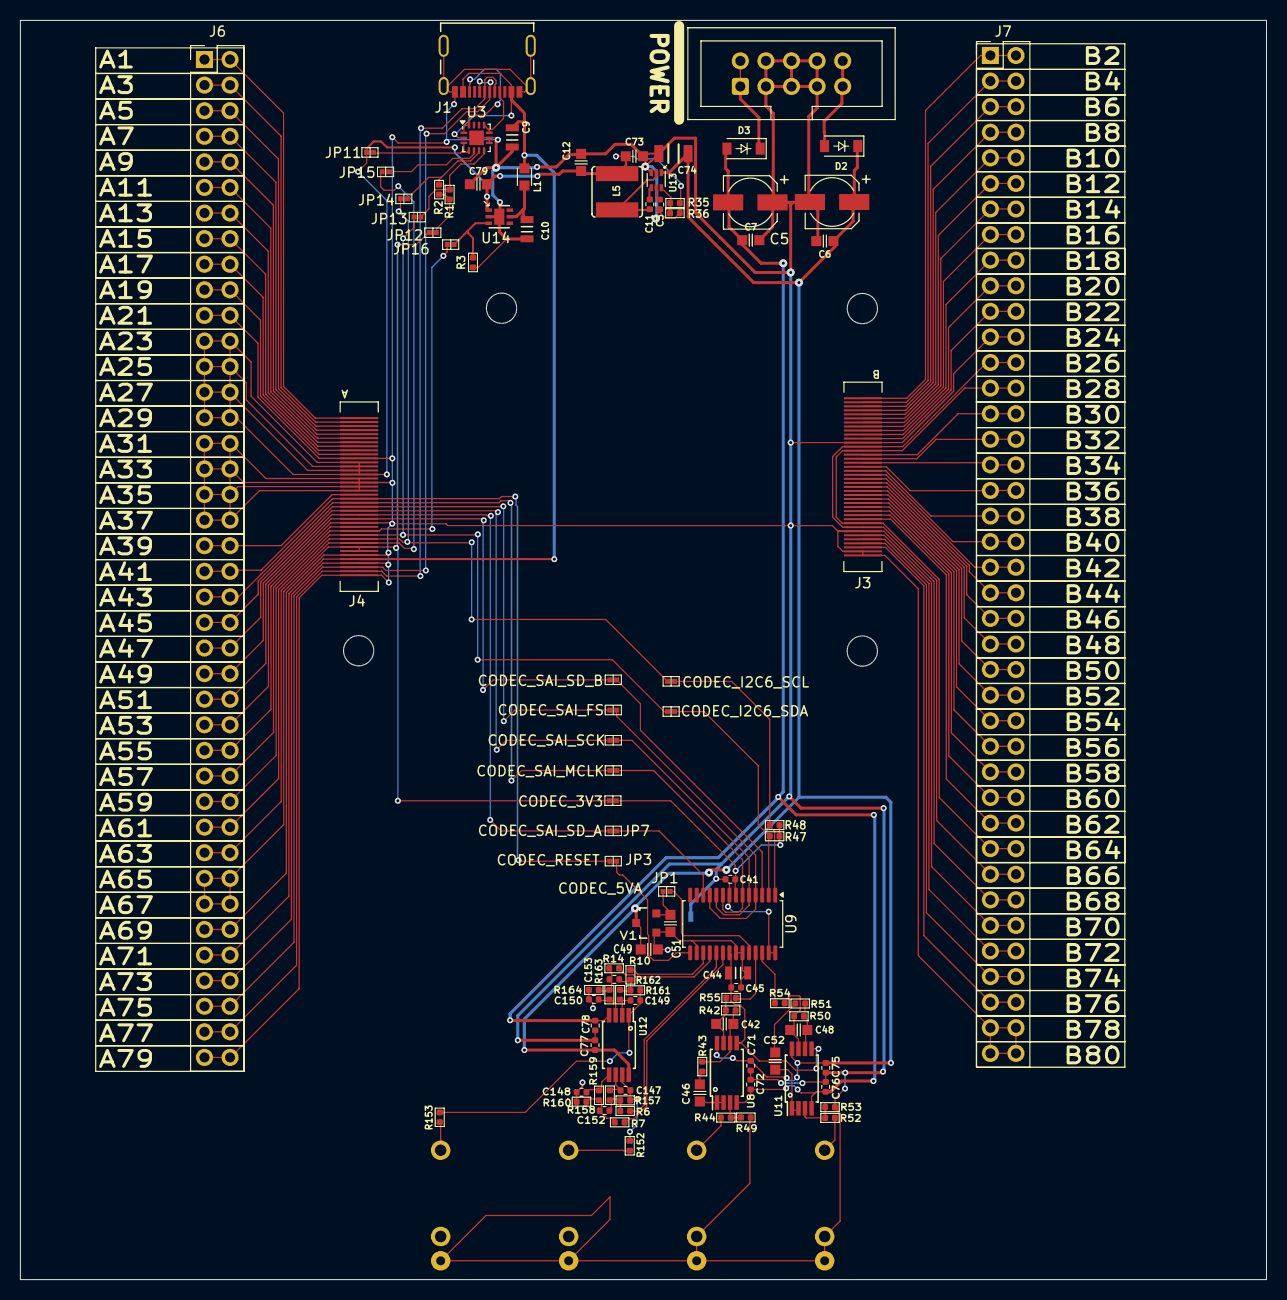
[picture p18: board carrier-breakout/v0.1/mp153-carrier-board.kicad_pcb from above]

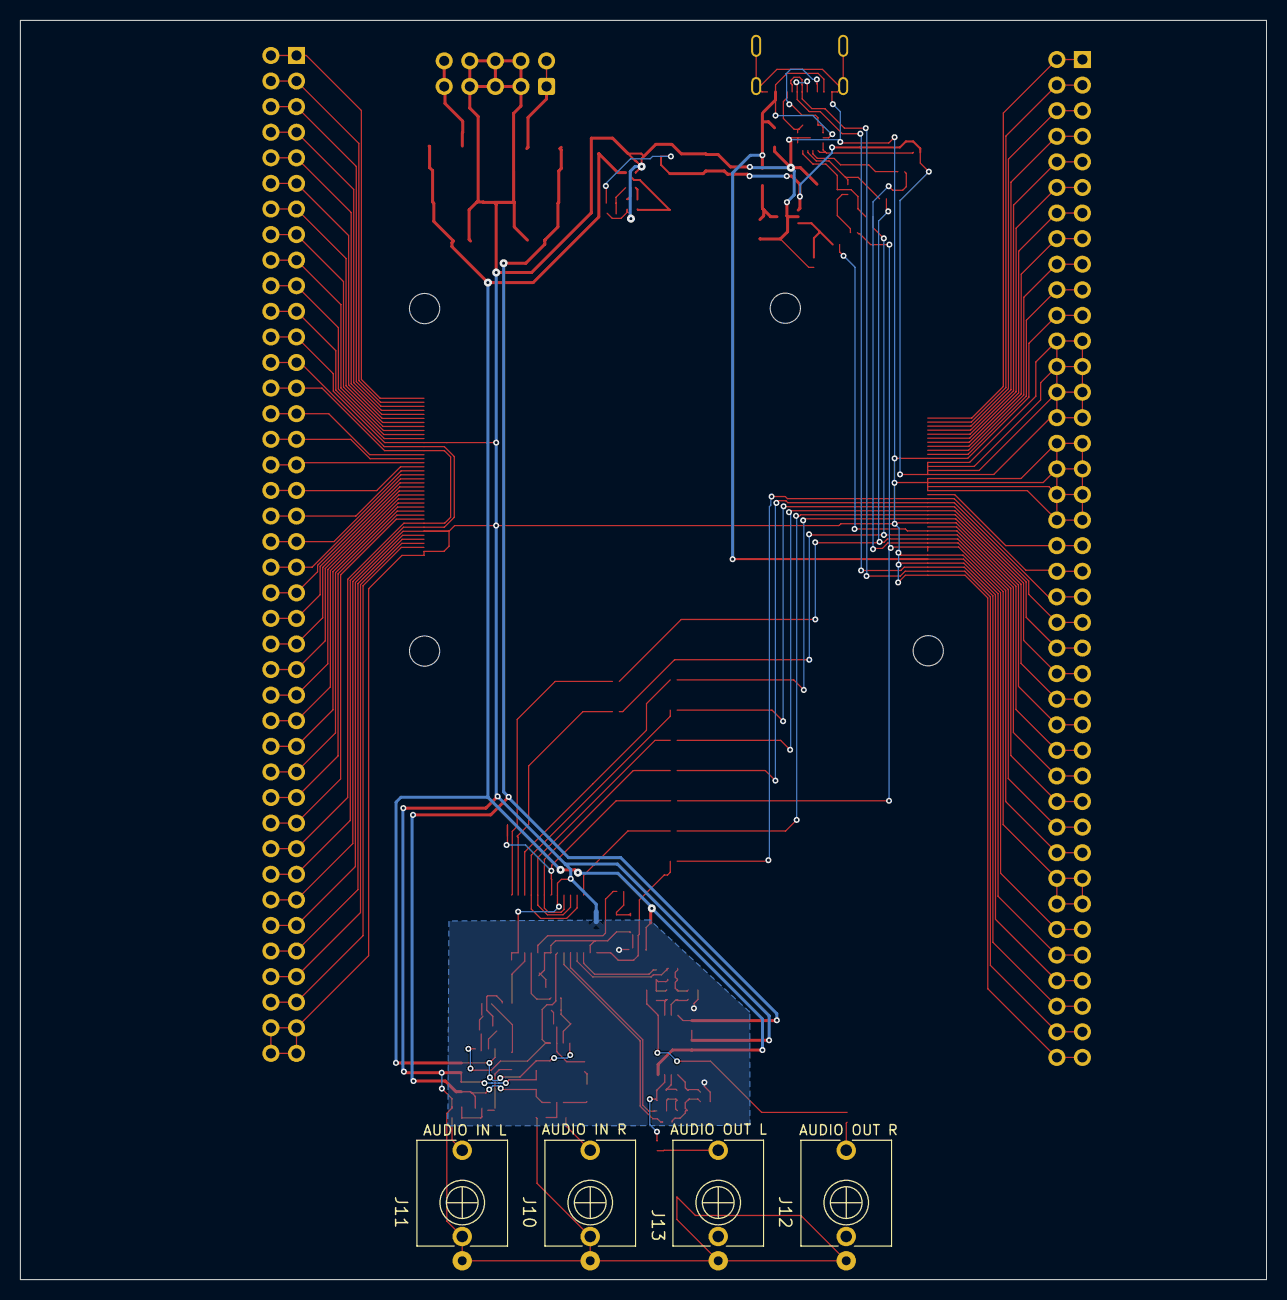
[picture p19: board carrier-breakout/v0.1/mp153-carrier-board.kicad_pcb from below]

Board: 2 copper layers, 123.7 x 125.0 mm, 103 parts (5 on the bottom side), 122 nets.
