4ms/mp153-devboard/rgb carrier/mp153-rgb-carrier/mp153-rgb-carrier.kicad_pcb

## KiCad design rgb carrier/mp153-rgb-carrier/mp153-rgb-carrier.kicad_pcb (2025-07-30)

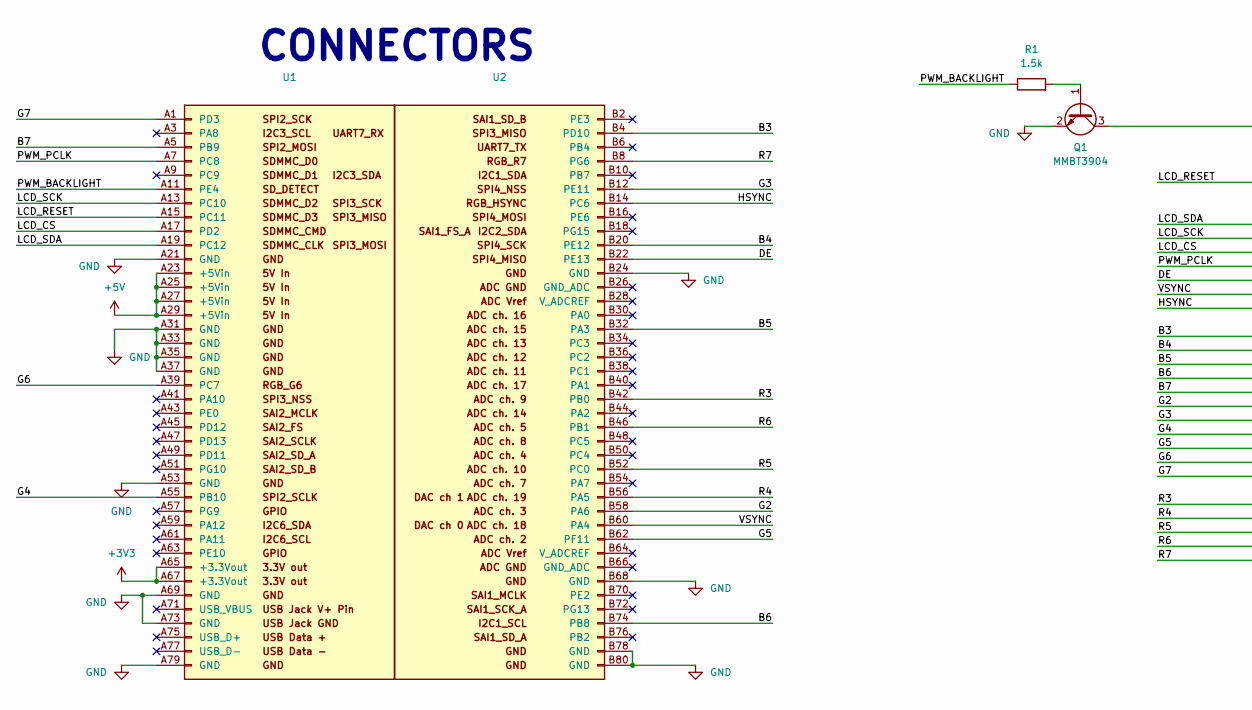
[picture p20: schematic mp153-rgb-carrier.kicad_sch, part in row 1, column 1]

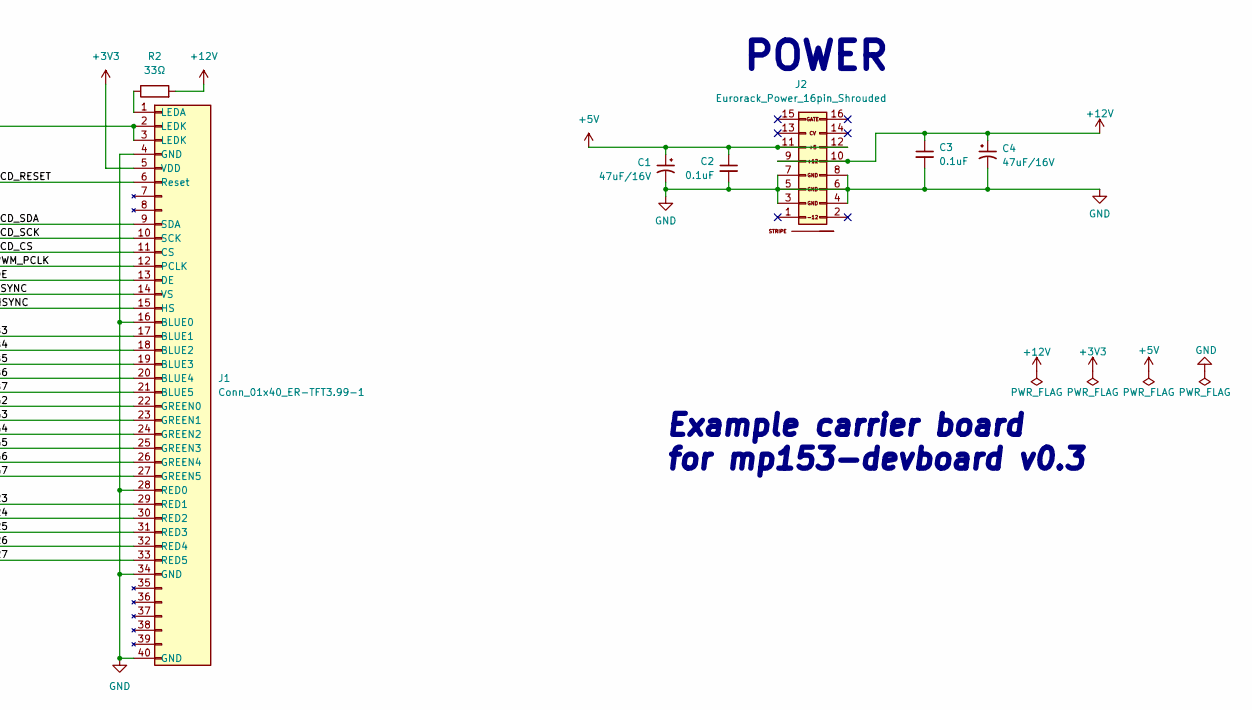
[picture p21: schematic mp153-rgb-carrier.kicad_sch, part in row 1, column 2]

Parts:
C1, C4: 47uF_5x5.3_16V; CP_Elec_5x5.3; Part Number VES470M1CTR-0505; JLCPCB ID C134798
C2, C3: 100nF_0603_16V; C_0603; Part Number 0603YC104KAT2A; JLCPCB ID C14663
J1: Conn_01x40_ER-TFT3.99-1; Amphenol_F32R-1A7x1-11040_1x40-1MP_P0.5mm_Horizontal; Part Number ER-TFT3.99-1
J2: Eurorack_Power_16pin_Shrouded; Pins_2x08_2.54mm_TH_EurorackPower_Shrouded; Part Number LL1007-1 (2*8 HITEMP)
Q1: MMBT3904; TO-92; Part Number MMBT3904-TP; JLCPCB ID C20526
R1: 1.5k_0603; R_Axial_DIN0207_L6.3mm_D2.5mm_P7.62mm_Horizontal; Part Number RC0603FR-071K5L; JLCPCB ID C114668
R2: 33Ω_0603; R_Axial_DIN0207_L6.3mm_D2.5mm_P7.62mm_Horizontal; Part Number RC0603FR-0733RL; JLCPCB ID C108661
U1: mp153-devboard-v0.1-sockets_A
U2: mp153-devboard-v0.1-sockets_B

Connections:
+3V3: J1.5 (VDD), U1.A65 (+3.3Vout), U1.A67 (+3.3Vout)
+5V: C1.1, C2.1, J2.11 (5V), J2.12 (5V), U1.A23 (+5Vin), U1.A25 (+5Vin), U1.A27 (+5Vin), U1.A29 (+5Vin)
+12V: C3.1, C4.1, J2.9 (+12V), J2.10 (+12V), R2.2
/B3: J1.17 (BLUE1), U2.B4 (PD10)
/B4: J1.18 (BLUE2), U2.B20 (PE12)
/B5: J1.19 (BLUE3), U2.B32 (PA3)
/B6: J1.20 (BLUE4), U2.B74 (PB8)
/B7: J1.21 (BLUE5), U1.A5 (PB9)
/DE: J1.13 (DE), U2.B22 (PE13)
/G2: J1.22 (GREEN0), U2.B58 (PA6)
/G3: J1.23 (GREEN1), U2.B12 (PE11)
/G4: J1.24 (GREEN2), U1.A55 (PB10)
/G5: J1.25 (GREEN3), U2.B62 (PF11)
/G6: J1.26 (GREEN4), U1.A39 (PC7)
/G7: J1.27 (GREEN5), U1.A1 (PD3)
/HSYNC: J1.15 (HS), U2.B14 (PC6)
/LCD_CS: J1.11 (CS), U1.A17 (PD2)
/LCD_RESET: J1.6 (Reset), U1.A15 (PC11)
/LCD_SCK: J1.10 (SCK), U1.A13 (PC10)
/LCD_SDA: J1.9 (SDA), U1.A19 (PC12)
/PWM_BACKLIGHT: R1.1, U1.A11 (PE4)
/PWM_PCLK: J1.12 (PCLK), U1.A7 (PC8)
/R3: J1.29 (RED1), U2.B42 (PB0)
/R4: J1.30 (RED2), U2.B56 (PA5)
/R5: J1.31 (RED3), U2.B52 (PC0)
/R6: J1.32 (RED4), U2.B46 (PB1)
/R7: J1.33 (RED5), U2.B8 (PG6)
/VSYNC: J1.14 (VS), U2.B60 (PA4)
GND: C1.2, C2.2, C3.2, C4.2, J1.4 (GND), J1.16 (BLUE0), J1.28 (RED0), J1.34 (GND), J1.40 (GND), J2.3 (GND), J2.4 (GND), J2.5 (GND), J2.6 (GND), J2.7 (GND), J2.8 (GND), Q1.2 (E), U1.A21 (GND), U1.A31 (GND), U1.A33 (GND), U1.A35 (GND), U1.A37 (GND), U1.A53 (GND), U1.A69 (GND), U1.A73 (GND), U1.A79 (GND), U2.B24 (GND), U2.B68 (GND), U2.B78 (GND), U2.B80 (GND)
unnamed: J1.1 (LEDA), R2.1
unnamed: Q1.1 (B), R1.2
unnamed: J1.2 (LEDK), J1.3 (LEDK), Q1.3 (C)

Notes on the sheet:
POWER
CONNECTORS
Example carrier board for mp153-devboard v0.3
