4ms/mp153-devboard/rgb carrier/mp153-rgb-carrier/mp153-rgb-carrier.kicad_pcb

## KiCad design rgb carrier/mp153-rgb-carrier/mp153-rgb-carrier.kicad_pcb (continued)

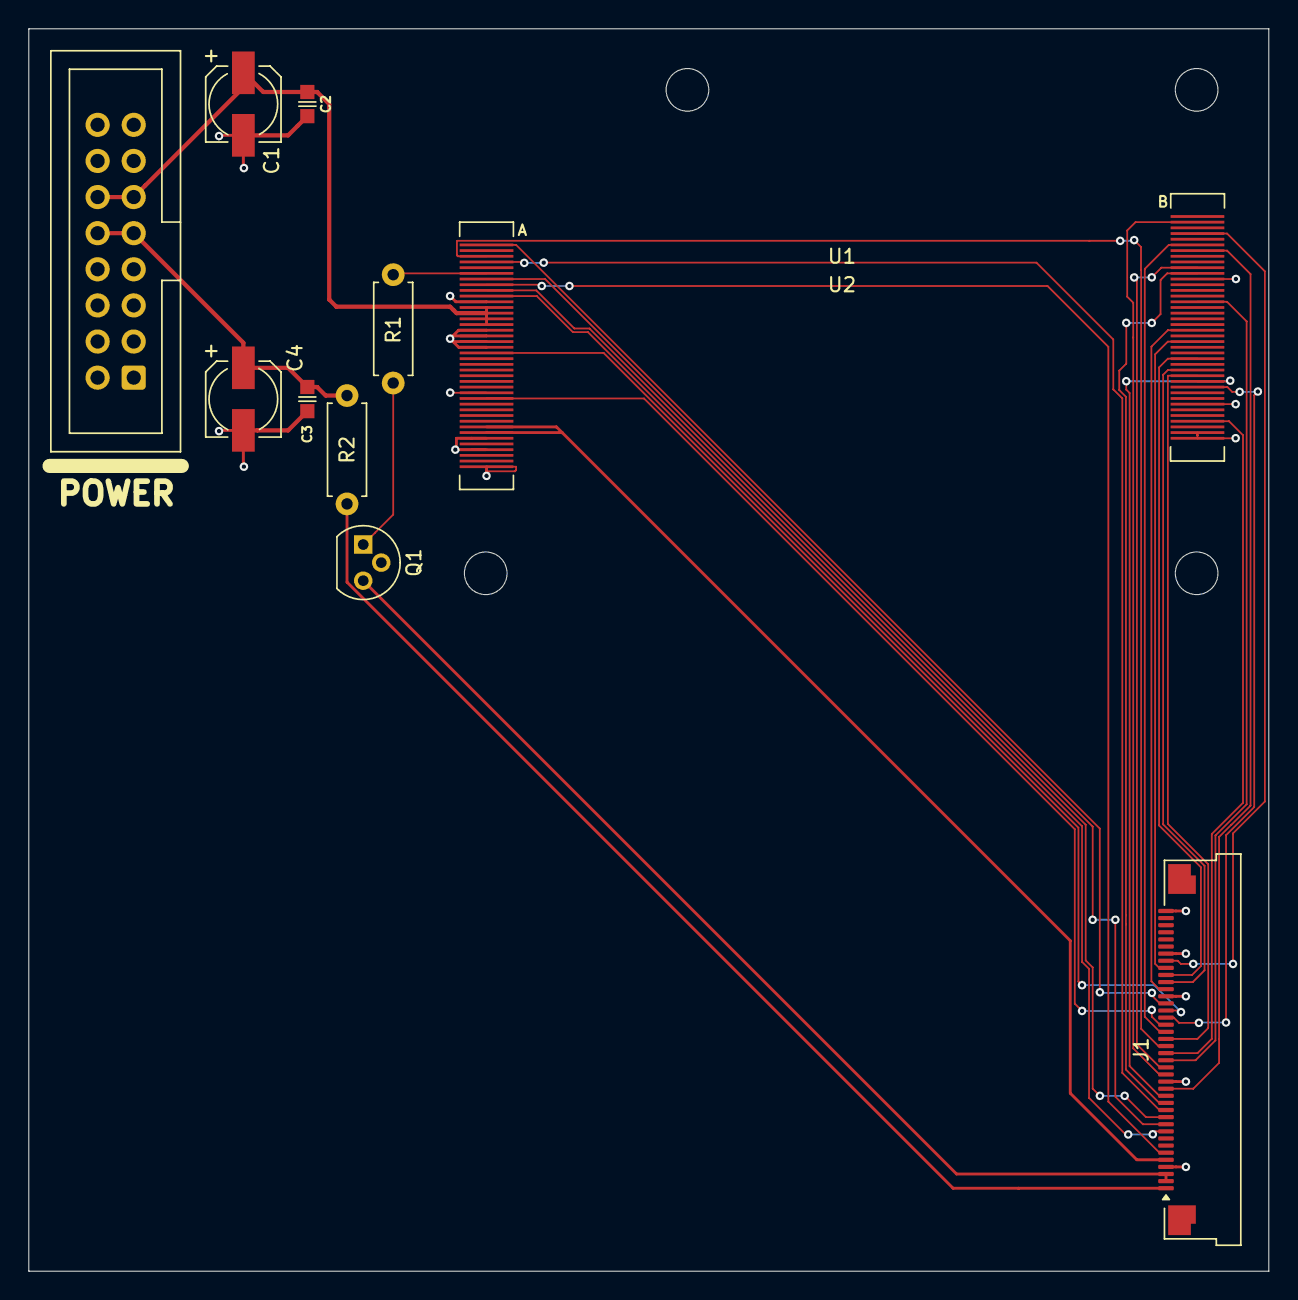
[picture p22: board mp153-rgb-carrier.kicad_pcb from above]

Board: 2 copper layers, 87.2 x 87.4 mm, 11 parts (0 on the bottom side), 32 nets.
