4ms/mp153-devboard/v0.1/mp153-devboard.kicad_pcb

## KiCad design v0.1/mp153-devboard.kicad_pcb (2025-07-02, an earlier design)

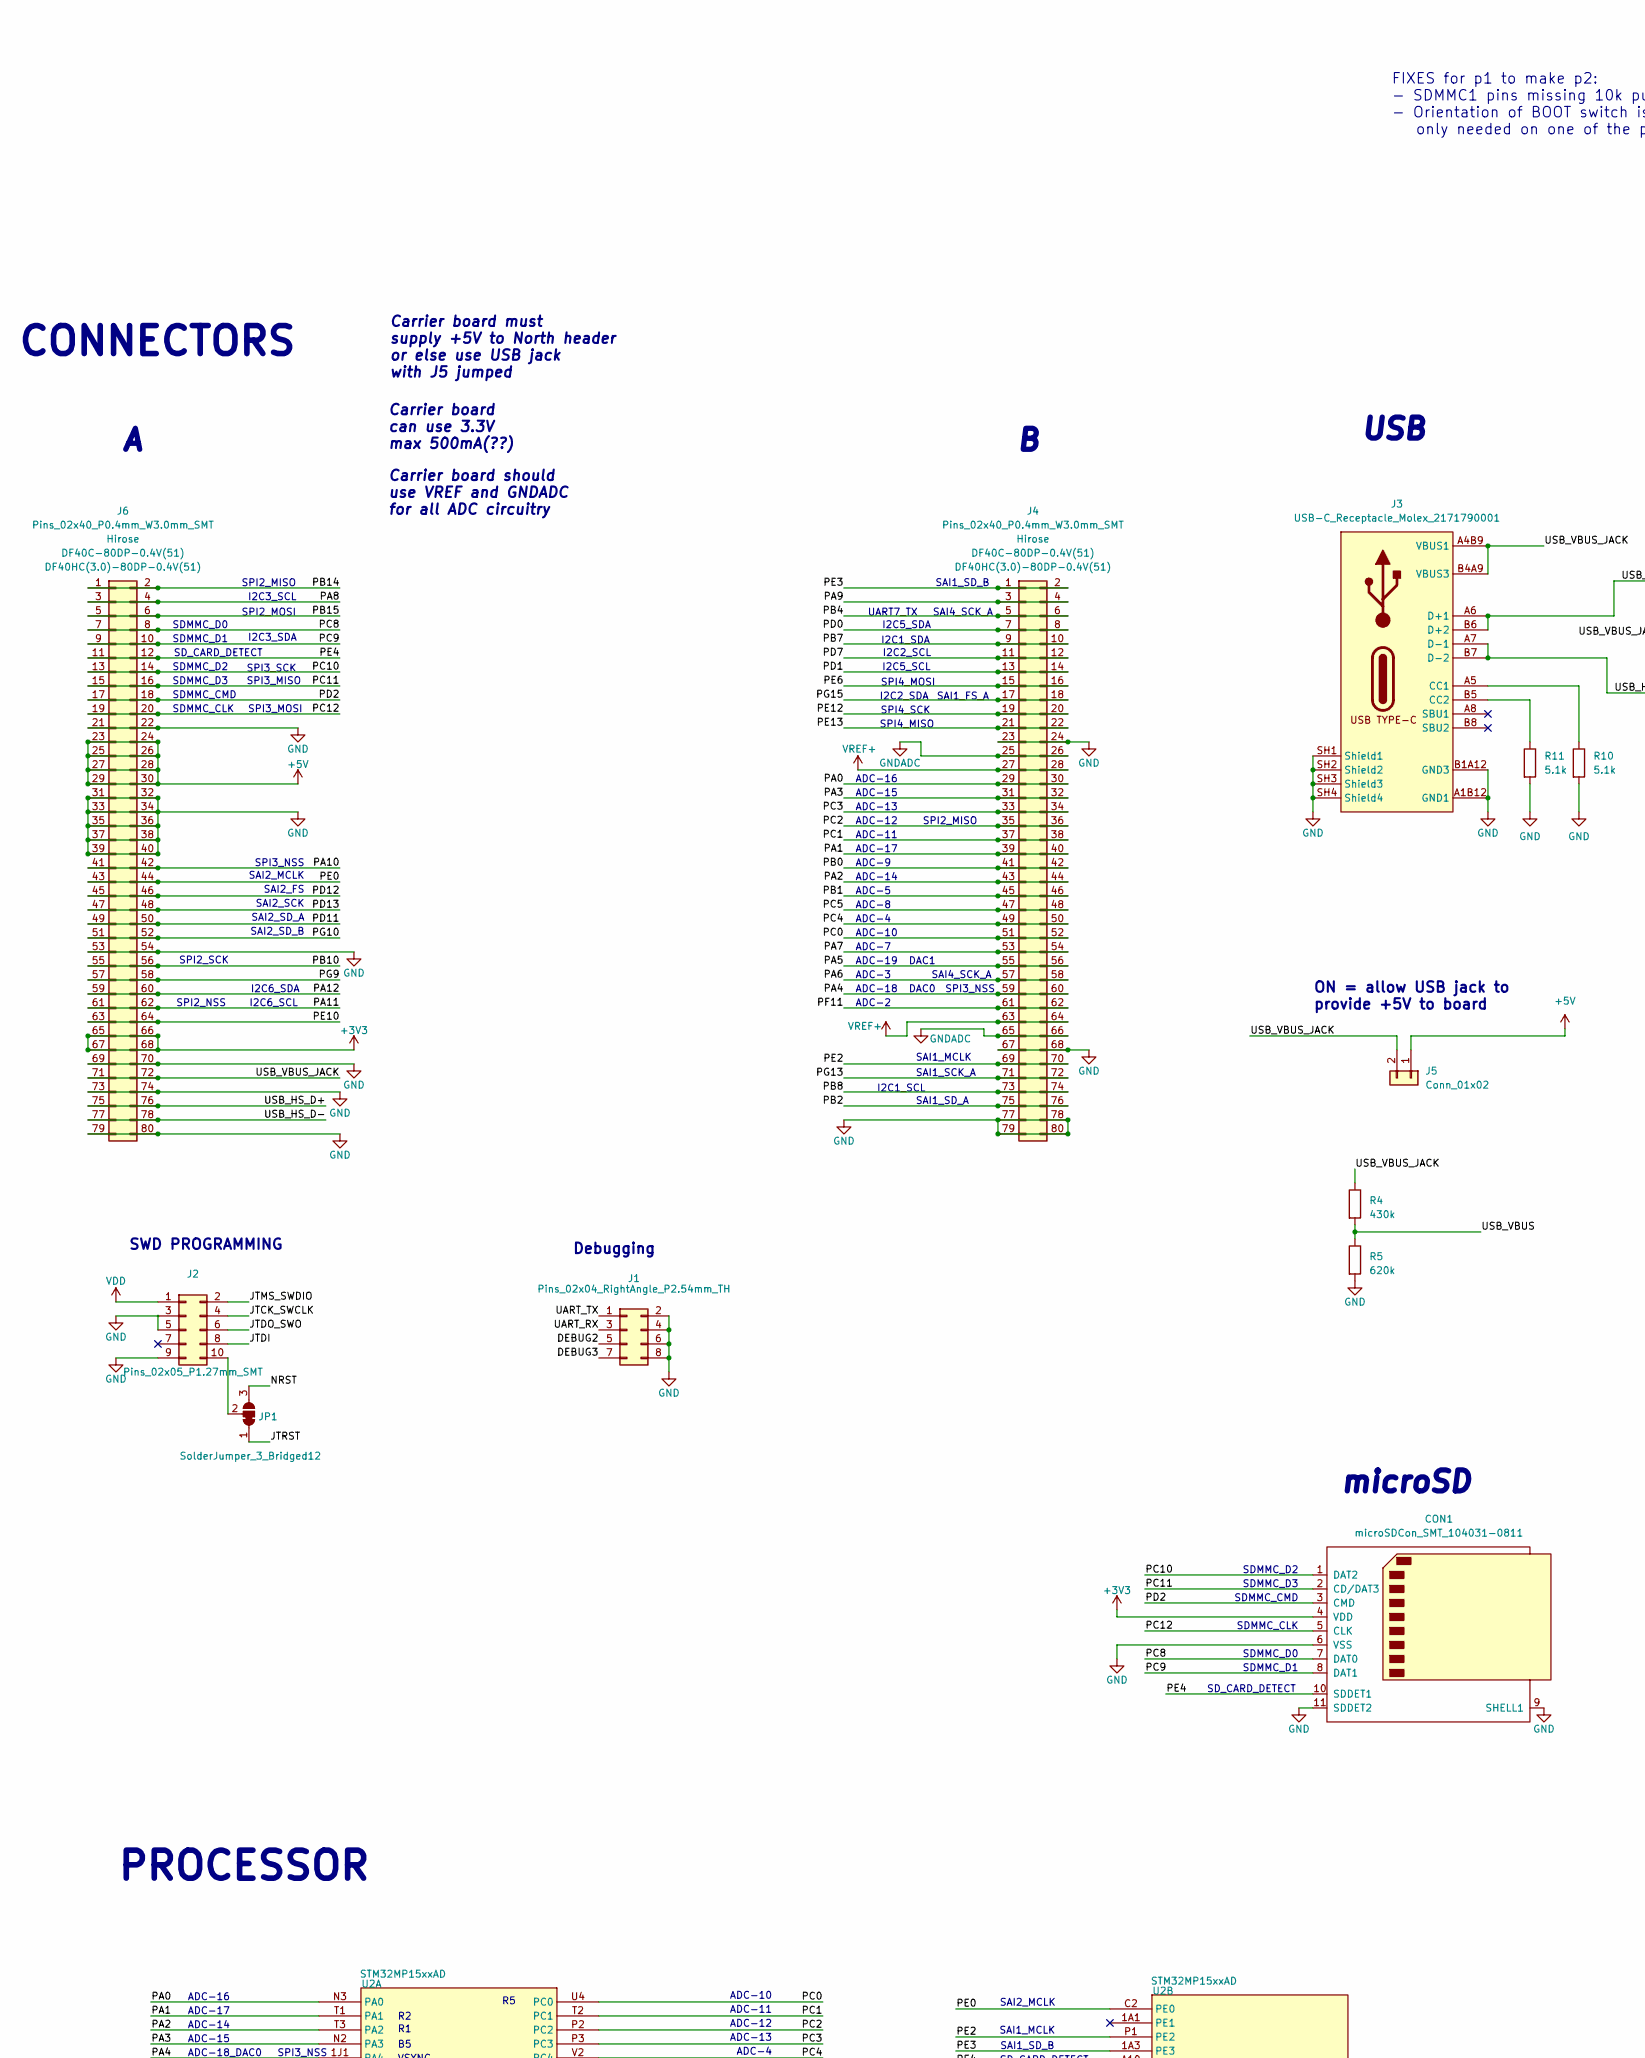
[picture p23: schematic mp153-devboard.kicad_sch, part in row 1, column 1]

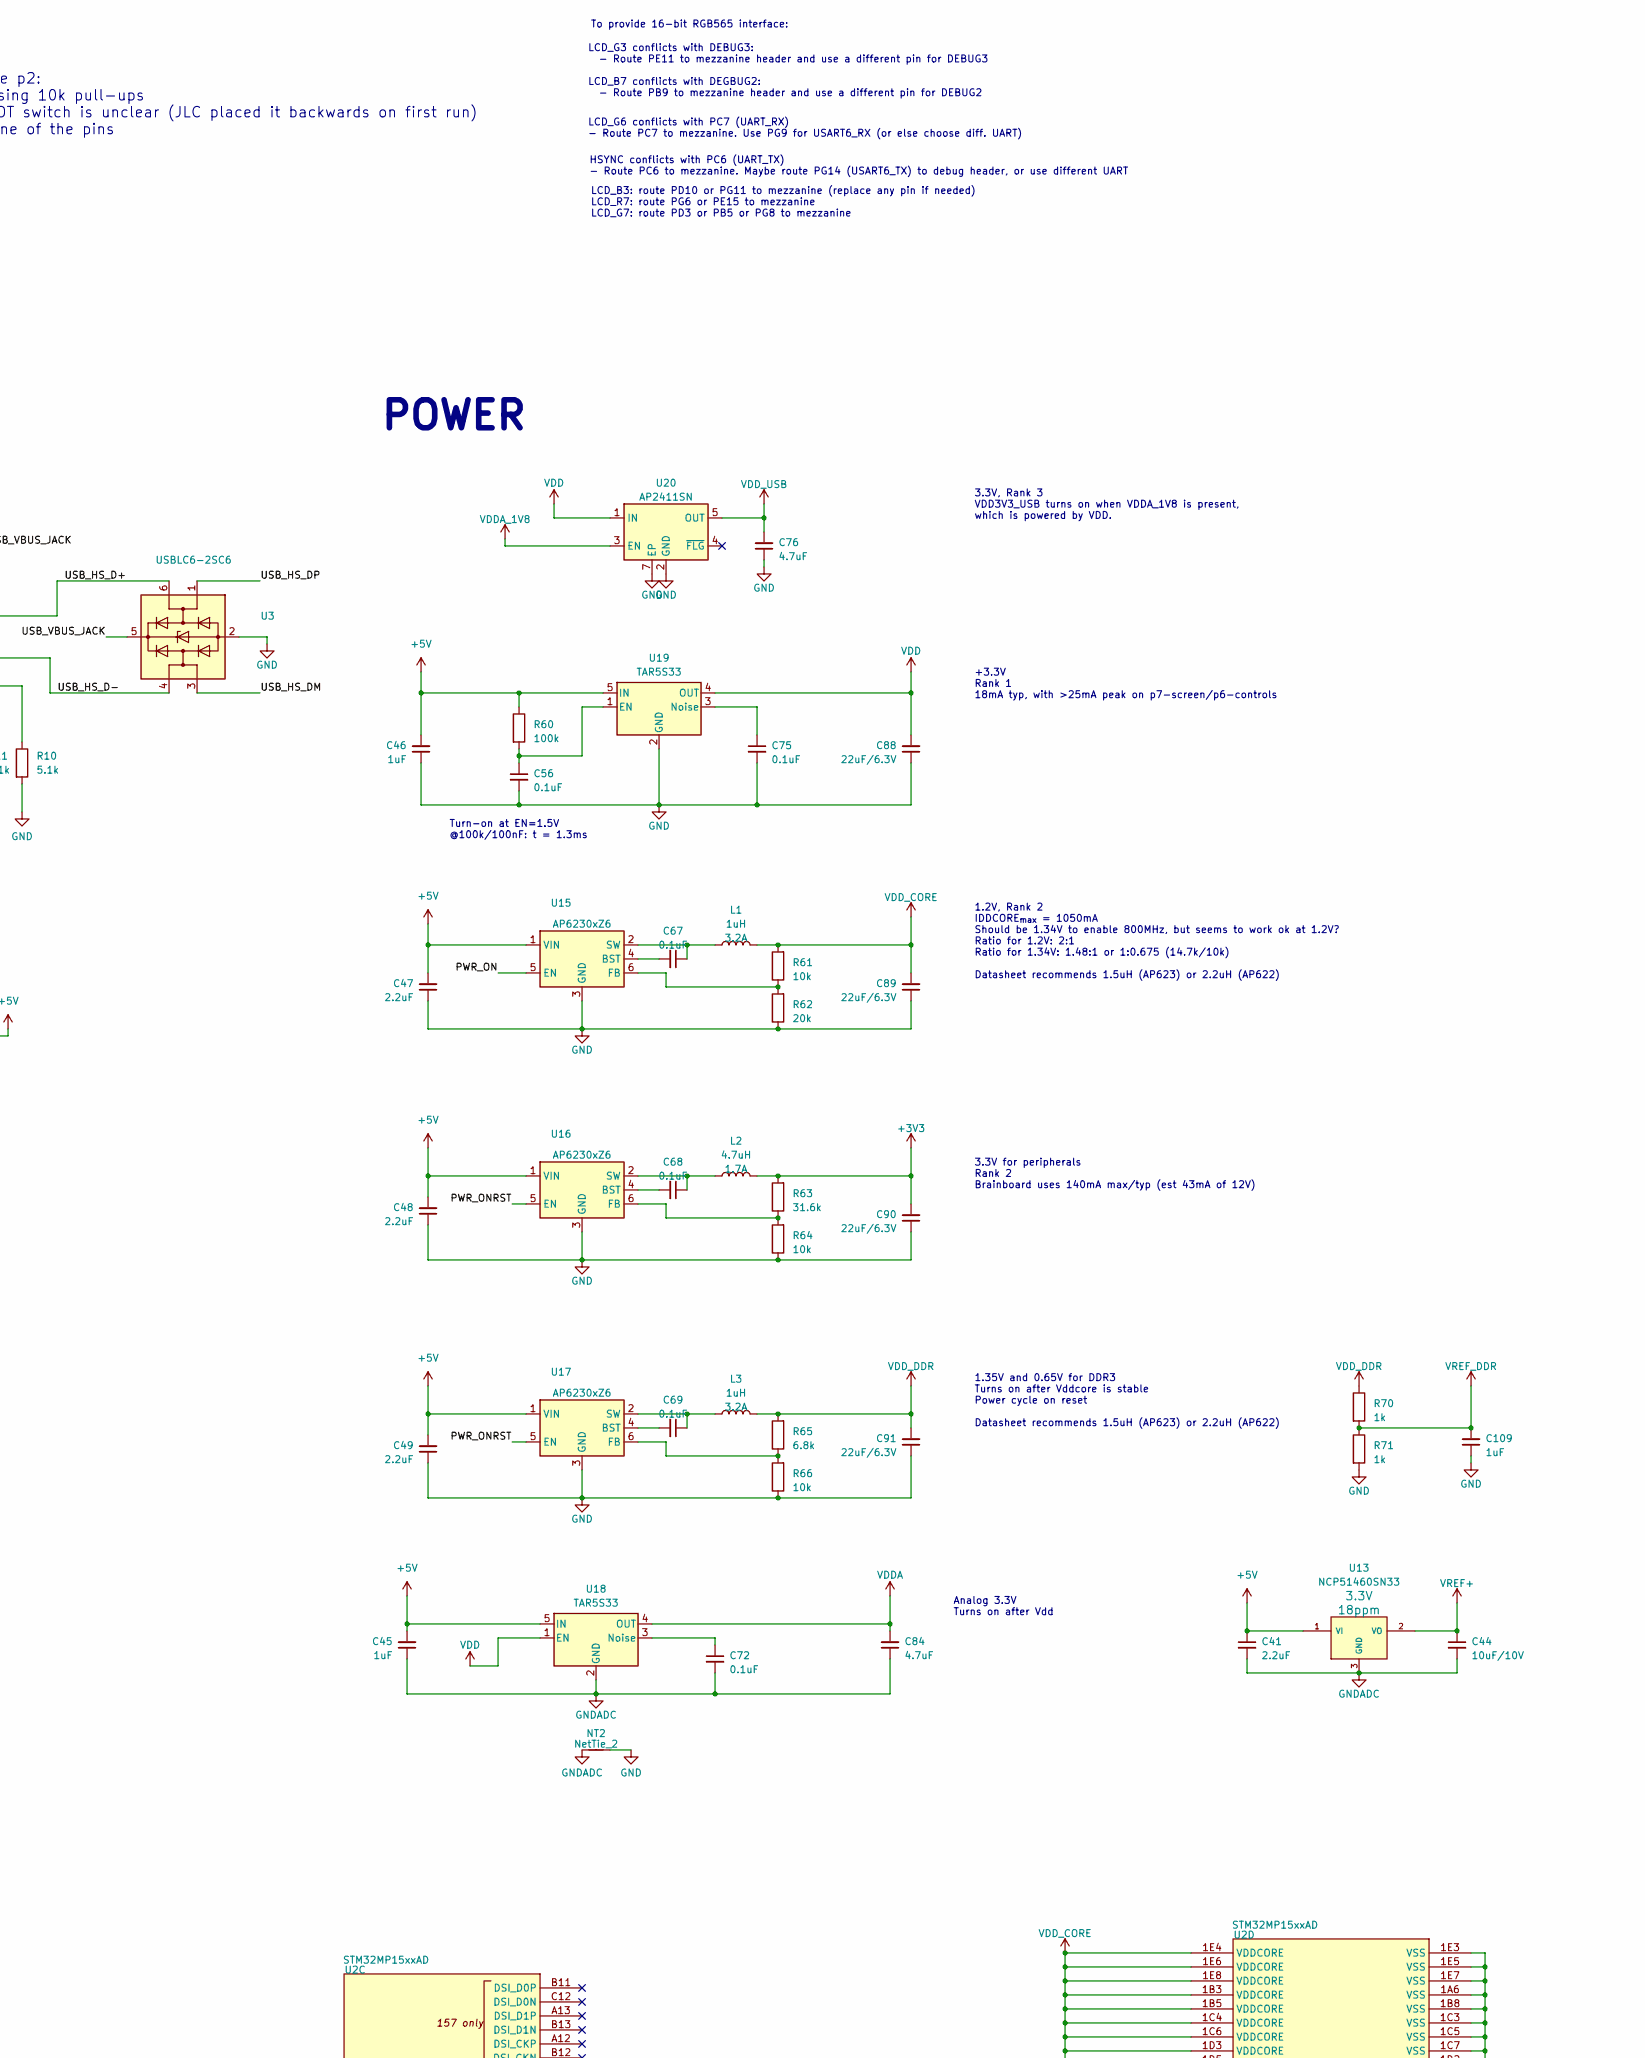
[picture p24: schematic mp153-devboard.kicad_sch, part in row 1, column 2]

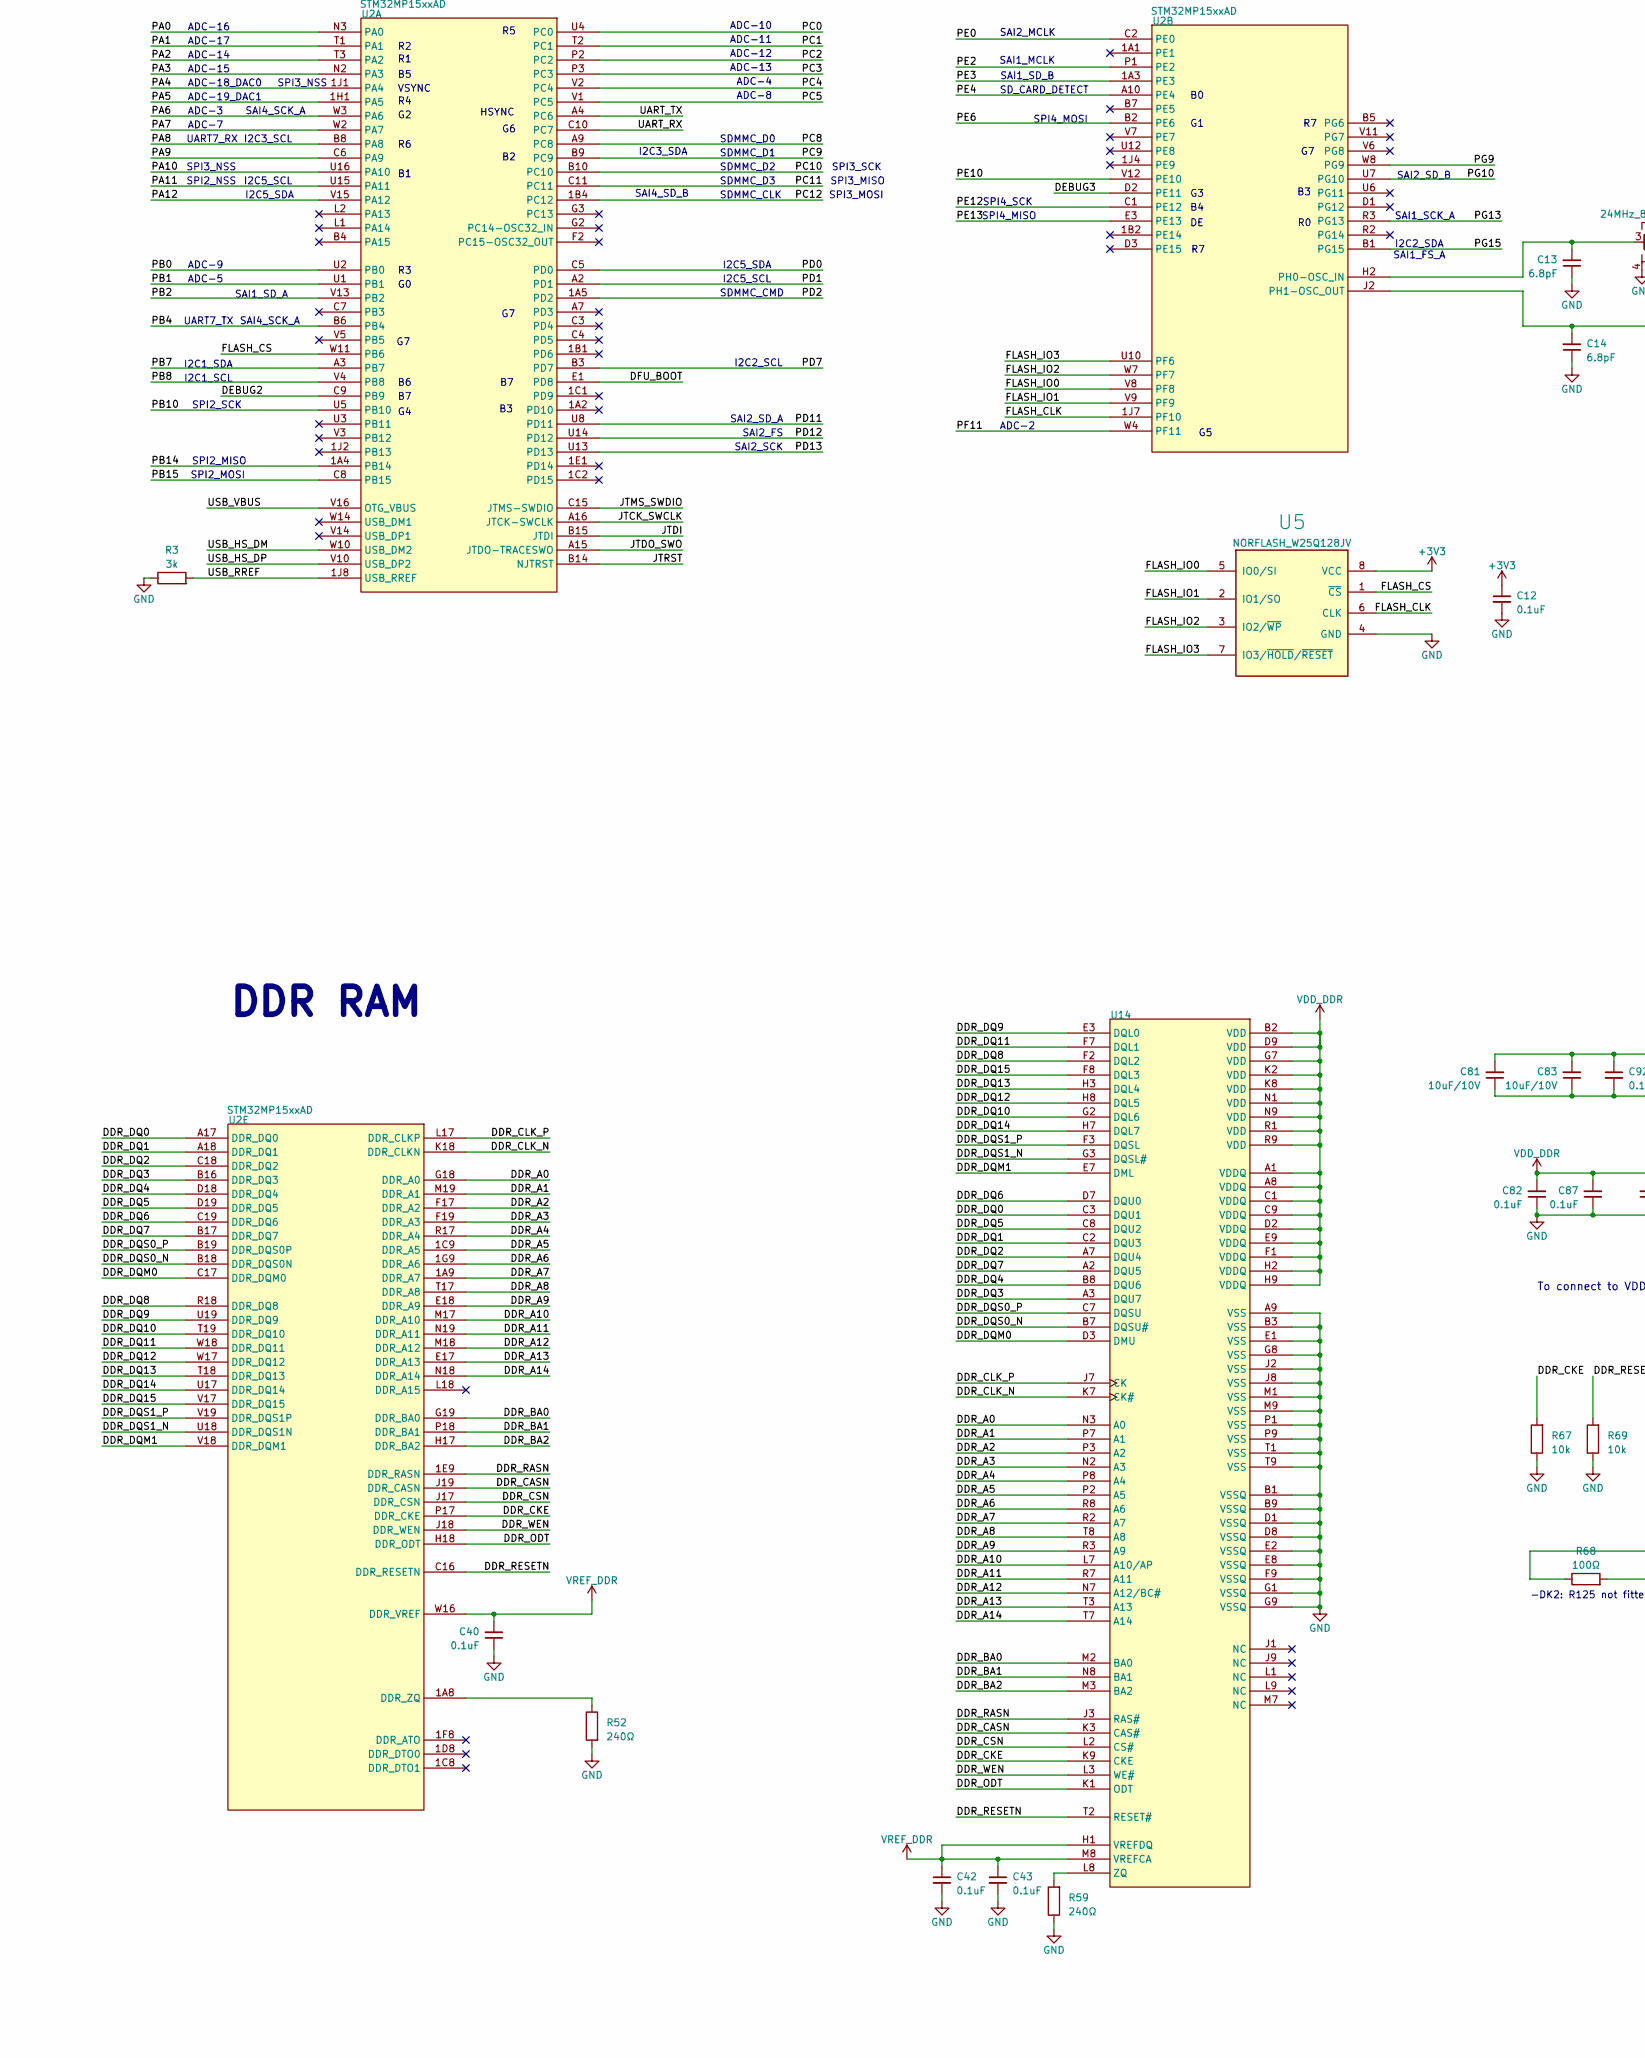
[picture p25: schematic mp153-devboard.kicad_sch, part in row 2, column 1]

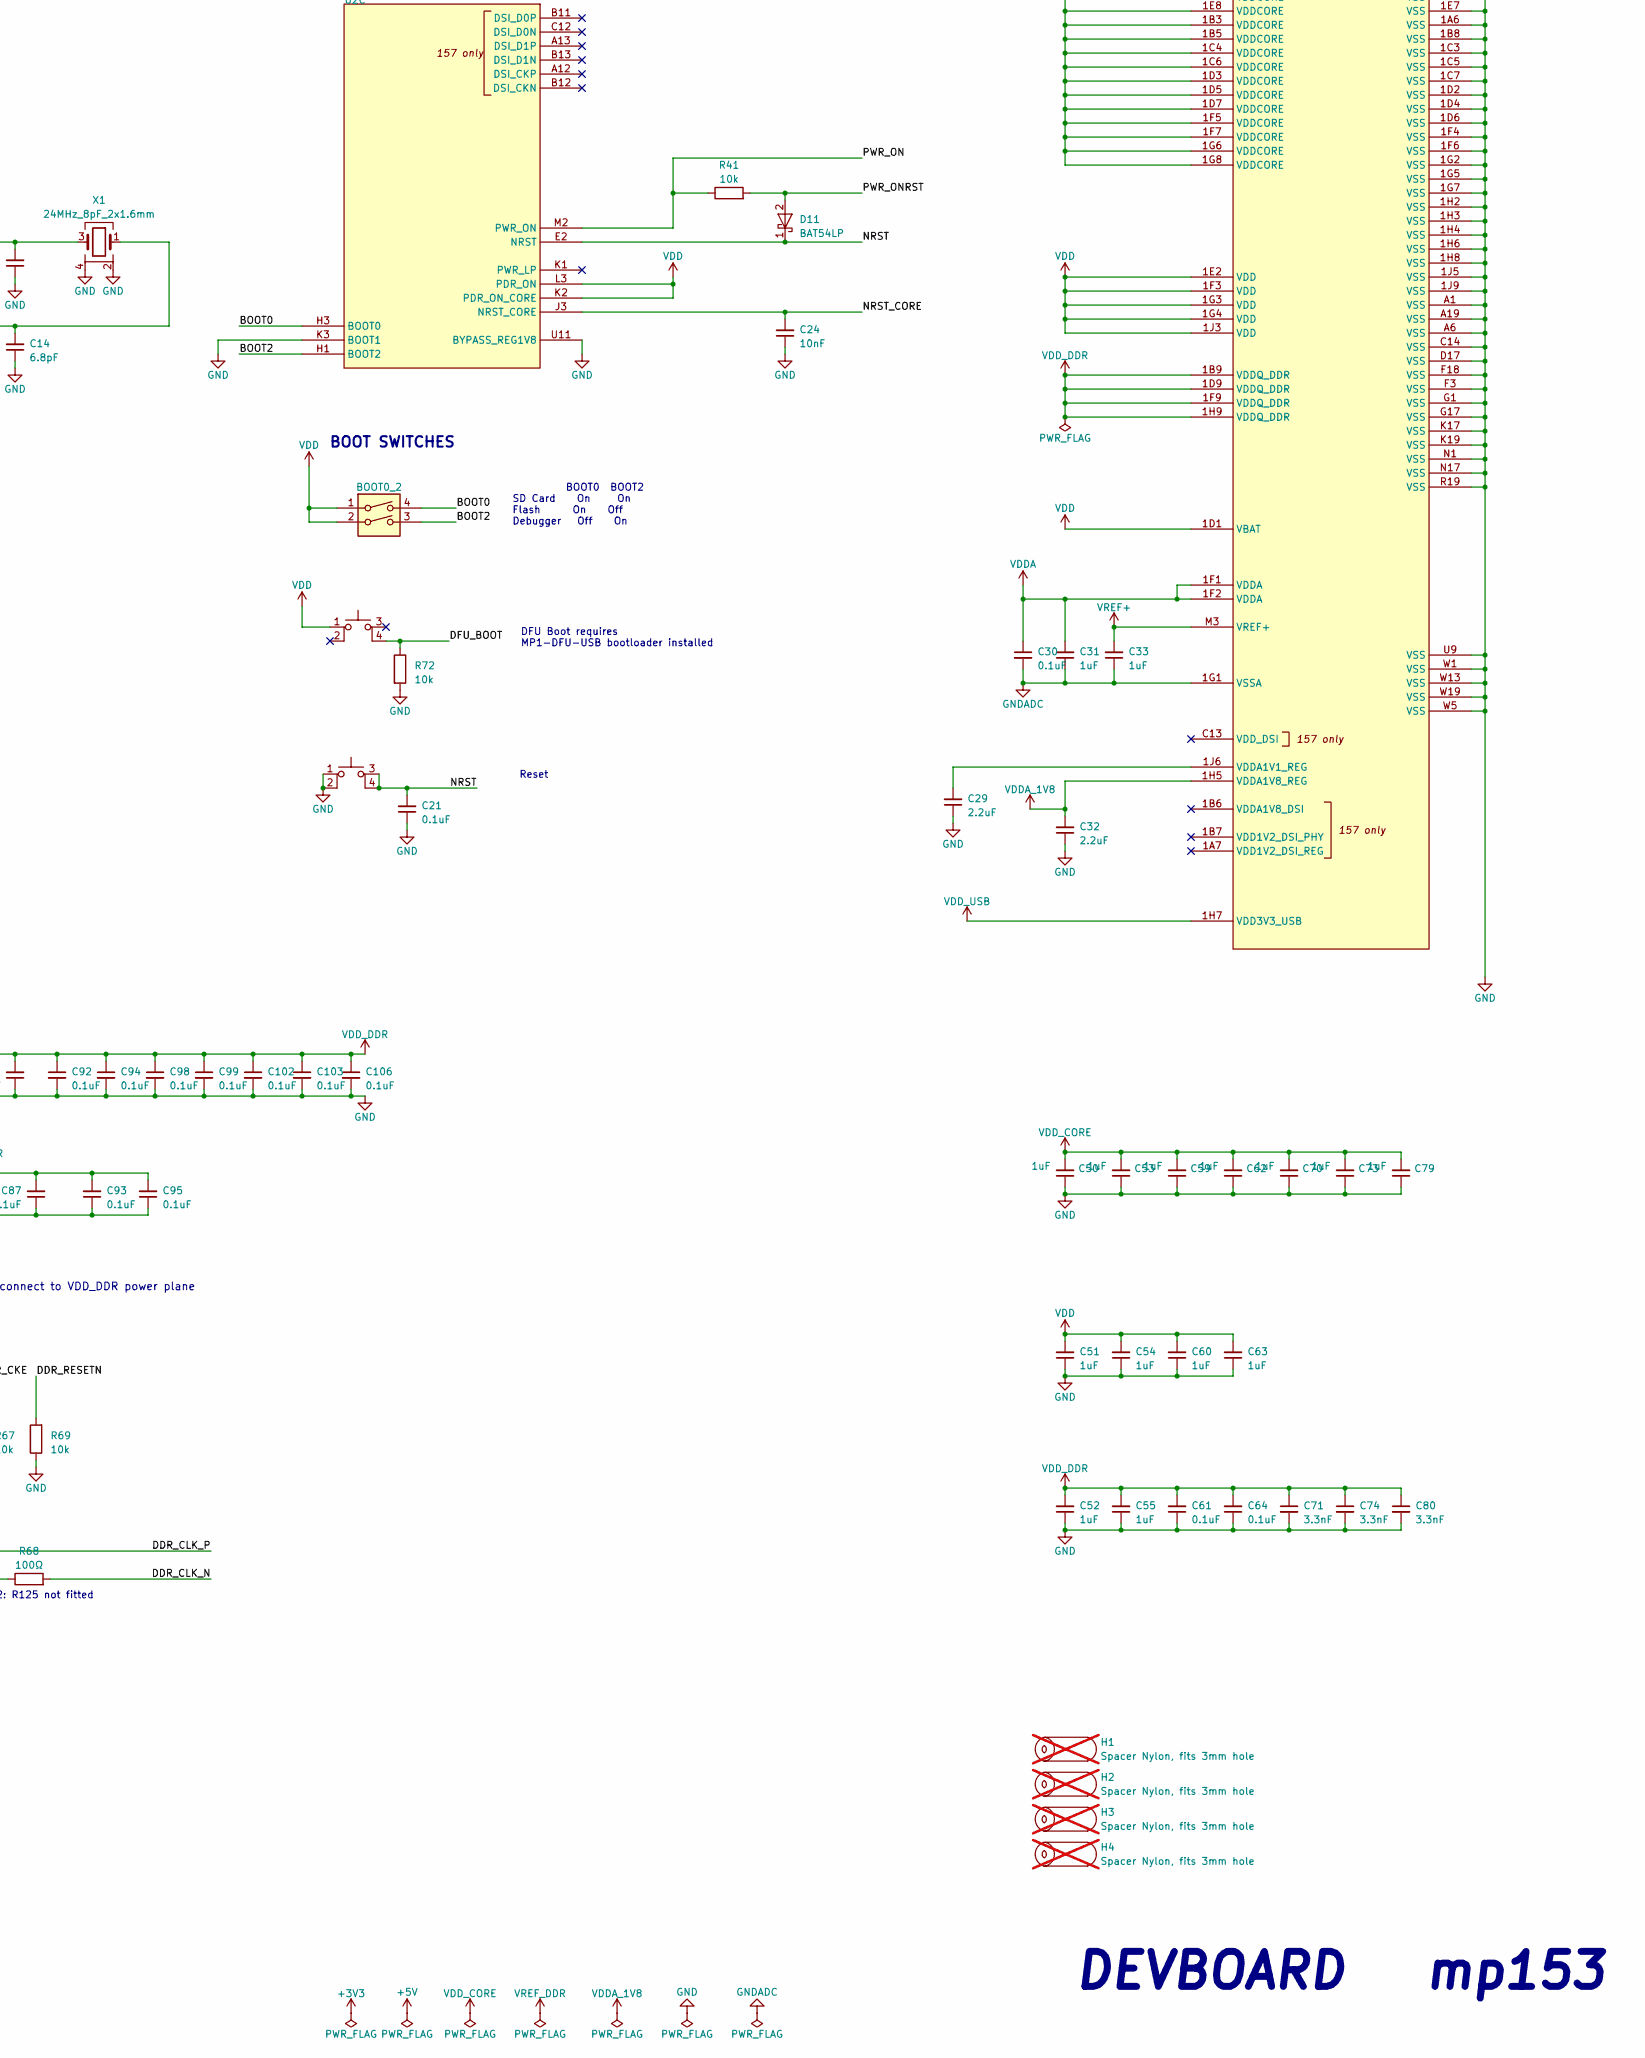
[picture p26: schematic mp153-devboard.kicad_sch, part in row 2, column 2]

Parts:
BOOT0_2: SW_DIP_x02_CTS_219-2MST; SW_DIP_SPSTx02_CTS_219-2MSTR; Part Number 219-2MST; JLCPCB ID C2961978
C12, C21, C30, C40, C42, C43, C61, C64, C67, C68, C69, C82, C87, C92, C93, C94, C95, C98, C99, C102, C103, C106: 100nF_0402_16V; C_0402; Part Number GCM155R71C104KA55D; JLCPCB ID C1525
C13, C14: 6.8pF_0402_25V; C_0402; Part Number CC0402CRNPO9BN6R8; JLCPCB ID C1576
C24: 10nF_0402_16V; C_0402; Part Number CC0402KRX7R7BB103; JLCPCB ID C15195
C29, C32: 2.2uF_0402_6.3V; C_0402; Part Number GRM155R60J225KE95D; JLCPCB ID C12530
C31, C33, C45, C46, C50, C51, C52, C53, C54, C55, C59, C60, C62, C63, C70, C73, C79, C109: 1uF_0402_25V; C_0402; Part Number GMK105CC6105KV-F; JLCPCB ID C52923
C41, C47, C48, C49: 2.2uF_0603_25V; C_0603; Part Number GRM188R6YA225KA12D; JLCPCB ID C57895
C44, C81, C83: 10uF_0603_10V; C_0603; Part Number GRM188R61A106KE69D; JLCPCB ID C19702
C56, C72, C75: 100nF_0402_50V; C_0402; Part Number GRM155R71H104KE14D; JLCPCB ID C307331
C71, C74, C80: 3.3nF_0402_16V; C_0402; Part Number VJ0402Y332KXACW1BC; JLCPCB ID C26404
C76, C84: 4.7uF_0402_6.3V; C_0402; Part Number GRM155R60J475ME47; JLCPCB ID C23733
C88, C89, C90, C91: 22uF_0603_6.3V; C_0603; Part Number GRM188R60J226MEA0J; JLCPCB ID C59461
CON1: microSDCon_SMT_104031-0811; CardSlot_MicroSD_Molex_104031-0811; Part Number 104031-0811; JLCPCB ID C585350
D11: BAT54LP; DFN-1006-2; Part Number BAT54LP-7; JLCPCB ID C134410
H1, H2, H3, H4: Spacer Nylon, fits 3mm hole; MountingHole_Generic_3mm; not fitted
J1: Pins_02x04_RightAngle_P2.54mm_TH; Pins_2x04_P2.54mm_Horizontal_CroppedSilk; Part Number TSW-104-08-T-D-RA
J2: Pins_02x05_P1.27mm_SMT; Pins_2x05_1.27mm_SMD; Part Number FTSH-105-01-F-DV; JLCPCB ID C598540
J3: USB-C_Receptacle_Molex_2171790001; USB_C_Receptacle_Molex_2171790001; Part Number 217179-0001; JLCPCB ID C2894899
J4, J6: Pins_02x40_P0.4mm_W3.0mm_SMT; Connector-80pin-P0.4mm-W3.0mm; Part Number DF40C-80DP-0.4V(51); JLCPCB ID C294544
J5: Conn_01x02; Pins_1x02_2.54mm_TH; Part Number 1-0201FBV0T
JP1: SolderJumper_3_Bridged12; JUMPER_SMD_1x3_tiny
L1, L3: 1uH_3.2A_2520; L_1008_2520Metric; Part Number DFE252012P-1R0M=P2; JLCPCB ID C435392
L2: 4.7uH_1.7A_2510; L_Wuerth_MAPI-2510; Part Number SRN2510F-4R7M; JLCPCB ID C2047781
NT2: NetTie_2; NetTie-2_SMD_Pad0.16mm_6mil
R3: 3k_0402; R_0402; Part Number RC0402FR-073KL; JLCPCB ID C137987
R4: 430k_0402; R_0402; Part Number RC0402FR-07430KL; JLCPCB ID C163463
R5: 620k_0402; R_0402; Part Number RC0402FR-07620KL; JLCPCB ID C137952
R10, R11: 5.1k_0402; R_0402; Part Number RC0402FR-075K1L; JLCPCB ID C105872
R41, R61, R64, R66, R67, R69, R72: 10k_0402; R_0402; Part Number RC0402FR-0710KL; JLCPCB ID C60490
R52, R59: 240Ω_0402; R_0402; Part Number RC0402FR-07240RL; JLCPCB ID C114755
R60: 100k_0402; R_0402; Part Number RC0402FR-07100KL; JLCPCB ID C60491
R62: 20k_0402; R_0402; Part Number RC0402FR-0720KL; JLCPCB ID C93942
R63: 31.6k_0402; R_0402; Part Number RC0402FR-0731K6L; JLCPCB ID C276265
R65: 6.8k_0402; R_0402; Part Number RC0402FR-076K8L; JLCPCB ID C93940
R68: 100Ω_0402; R_0402; Part Number RC0402FR-07100RL; JLCPCB ID C106232
R70, R71: 1k_0402; R_0402; Part Number RC0402FR-071KL; JLCPCB ID C106235
S2, S3: SW_Push_PTS526 SM15 SMTR2 LFS; Button_Tact_PTS526; Part Number PTS526 SM15 SMTR2 LFS; JLCPCB ID C2689521
U2: STM32MP15xxAD; TFBGA-257_10x10mm_perP0.5_cntrP0.65; Part Number STM32MP153DAD; JLCPCB ID C1236719
U3: USBLC6-2SC6; SOT-23-6; Part Number USBLC6-2SC6; JLCPCB ID C2827654
U5: NORFLASH_W25Q128JV; SOIC-8_5.28x4.9mm_Pitch1.27mm; Part Number W25Q128JVSIQ; JLCPCB ID C113767
U13: NCP51460SN33; SOT23-3_PO132; Part Number NCP51460SN33T1G; JLCPCB ID C233715
U14: DDR3L-RAM-4Gb_MT41K256M16TW; FBGA-96_Layout2x3x16_Body8x14_P0.8mm; Part Number MT41K256M16TW-107-P-V00H; JLCPCB ID C253882
U15, U16, U17: AP6230xZ6; SOT-563; Part Number AP62301Z6; JLCPCB ID C1880992
U18, U19: TAR5S33; SOT-23-5; Part Number TAR5S33TE85LF; JLCPCB ID C2762700
U20: AP2411SN; DFN-6-1EP_2x2mm_P0.65mm_EP1x1.6mm; Part Number AP2411SN-7; JLCPCB ID C2149815
X1: 24MHz_8pF_2x1.6mm; Crystal_2.0x1.6mm_4pin; Part Number ECS-240-8-37-CKM-TR3; JLCPCB ID C1986107

Connections:
+3V3: C12.1, C90.2, CON1.4 (VDD), J6.65, J6.66, J6.67, J6.68, L2.2, R63.2, U5.8 (VCC)
+5V: C41.1, C45.2, C46.2, C47.2, C48.2, C49.2, J5.1, J6.23, J6.24, J6.25, J6.26, J6.27, J6.28, J6.29, J6.30, R60.1, U13.1 (VI), U15.1 (VIN), U16.1 (VIN), U17.1 (VIN), U18.5 (IN), U19.5 (IN)
/BOOT0: BOOT0_2.4, U2.H3 (BOOT0)
/BOOT2: BOOT0_2.3, U2.H1 (BOOT2)
/DDR_A0: U2.G18 (DDR_A0), U14.N3 (A0)
/DDR_A1: U2.M19 (DDR_A1), U14.P7 (A1)
/DDR_A2: U2.F17 (DDR_A2), U14.P3 (A2)
/DDR_A3: U2.F19 (DDR_A3), U14.N2 (A3)
/DDR_A4: U2.R17 (DDR_A4), U14.P8 (A4)
/DDR_A5: U2.1C9 (DDR_A5), U14.P2 (A5)
/DDR_A6: U2.1G9 (DDR_A6), U14.R8 (A6)
/DDR_A7: U2.1A9 (DDR_A7), U14.R2 (A7)
/DDR_A8: U2.T17 (DDR_A8), U14.T8 (A8)
/DDR_A9: U2.E18 (DDR_A9), U14.R3 (A9)
/DDR_A10: U2.M17 (DDR_A10), U14.L7 (A10/AP)
/DDR_A11: U2.N19 (DDR_A11), U14.R7 (A11)
/DDR_A12: U2.M18 (DDR_A12), U14.N7 (A12/BC#)
/DDR_A13: U2.E17 (DDR_A13), U14.T3 (A13)
/DDR_A14: U2.N18 (DDR_A14), U14.T7 (A14)
/DDR_BA0: U2.G19 (DDR_BA0), U14.M2 (BA0)
/DDR_BA1: U2.P18 (DDR_BA1), U14.N8 (BA1)
/DDR_BA2: U2.H17 (DDR_BA2), U14.M3 (BA2)
/DDR_CASN: U2.J19 (DDR_CASN), U14.K3 (CAS#)
/DDR_CKE: R67.2, U2.P17 (DDR_CKE), U14.K9 (CKE)
/DDR_CLK_N: R68.2, U2.K18 (DDR_CLKN), U14.K7 (CK#)
/DDR_CLK_P: R68.1, U2.L17 (DDR_CLKP), U14.J7 (CK)
/DDR_CSN: U2.J17 (DDR_CSN), U14.L2 (CS#)
/DDR_DQ0: U2.A17 (DDR_DQ0), U14.C3 (DQU1)
/DDR_DQ1: U2.A18 (DDR_DQ1), U14.C2 (DQU3)
/DDR_DQ2: U2.C18 (DDR_DQ2), U14.A7 (DQU4)
/DDR_DQ3: U2.B16 (DDR_DQ3), U14.A3 (DQU7)
/DDR_DQ4: U2.D18 (DDR_DQ4), U14.B8 (DQU6)
/DDR_DQ5: U2.D19 (DDR_DQ5), U14.C8 (DQU2)
/DDR_DQ6: U2.C19 (DDR_DQ6), U14.D7 (DQU0)
/DDR_DQ7: U2.B17 (DDR_DQ7), U14.A2 (DQU5)
/DDR_DQ8: U2.R18 (DDR_DQ8), U14.F2 (DQL2)
/DDR_DQ9: U2.U19 (DDR_DQ9), U14.E3 (DQL0)
/DDR_DQ10: U2.T19 (DDR_DQ10), U14.G2 (DQL6)
/DDR_DQ11: U2.W18 (DDR_DQ11), U14.F7 (DQL1)
/DDR_DQ12: U2.W17 (DDR_DQ12), U14.H8 (DQL5)
/DDR_DQ13: U2.T18 (DDR_DQ13), U14.H3 (DQL4)
/DDR_DQ14: U2.U17 (DDR_DQ14), U14.H7 (DQL7)
/DDR_DQ15: U2.V17 (DDR_DQ15), U14.F8 (DQL3)
/DDR_DQM0: U2.C17 (DDR_DQM0), U14.D3 (DMU)
/DDR_DQM1: U2.V18 (DDR_DQM1), U14.E7 (DML)
/DDR_DQS0_N: U2.B18 (DDR_DQS0N), U14.B7 (DQSU#)
/DDR_DQS0_P: U2.B19 (DDR_DQS0P), U14.C7 (DQSU)
/DDR_DQS1_N: U2.U18 (DDR_DQS1N), U14.G3 (DQSL#)
/DDR_DQS1_P: U2.V19 (DDR_DQS1P), U14.F3 (DQSL)
/DDR_ODT: U2.H18 (DDR_ODT), U14.K1 (ODT)
/DDR_RASN: U2.1E9 (DDR_RASN), U14.J3 (RAS#)
/DDR_RESETN: R69.2, U2.C16 (DDR_RESETN), U14.T2 (RESET#)
/DDR_WEN: U2.J18 (DDR_WEN), U14.L3 (WE#)
/DEBUG2: J1.5, U2.C9 (PB9)
/DEBUG3: J1.7, U2.D2 (PE11)
/DFU_BOOT: R72.1, S3.4, U2.E1 (PD8)
/FLASH_CLK: U2.1J7 (PF10), U5.6 (CLK)
/FLASH_CS: U2.W11 (PB6), U5.1 (~CS)
/FLASH_IO0: U2.V8 (PF8), U5.5 (IO0/SI)
/FLASH_IO1: U2.V9 (PF9), U5.2 (IO1/SO)
/FLASH_IO2: U2.W7 (PF7), U5.3 (IO2/~WP)
/FLASH_IO3: U2.U10 (PF6), U5.7 (IO3/~HOLD/~RESET)
/JTCK_SWCLK: J2.4, U2.A16 (JTCK-SWCLK)
/JTDI: J2.8, U2.B15 (JTDI)
/JTDO_SWO: J2.6, U2.A15 (JTDO-TRACESWO)
/JTMS_SWDIO: J2.2, U2.C15 (JTMS-SWDIO)
/JTRST: JP1.1 (A), U2.B14 (NJTRST)
/NRST: C21.2, D11.1 (K), JP1.3 (B), S2.3, S2.4, U2.E2 (NRST)
/NRST_CORE: C24.2, U2.J3 (NRST_CORE)
/PA0: J4.29, J4.30, U2.N3 (PA0)
/PA1: J4.39, J4.40, U2.T1 (PA1)
/PA2: J4.43, J4.44, U2.T3 (PA2)
/PA3: J4.31, J4.32, U2.N2 (PA3)
/PA4: J4.59, J4.60, U2.1J1 (PA4)
/PA5: J4.55, J4.56, U2.1H1 (PA5)
/PA6: J4.57, J4.58, U2.W3 (PA6)
/PA7: J4.53, J4.54, U2.W2 (PA7)
/PA8: J6.3, J6.4, U2.B8 (PA8)
/PA9: J4.3, J4.4, U2.C6 (PA9)
/PA10: J6.41, J6.42, U2.U16 (PA10)
/PA11: J6.61, J6.62, U2.U15 (PA11)
/PA12: J6.59, J6.60, U2.V15 (PA12)
/PB0: J4.41, J4.42, U2.U2 (PB0)
/PB1: J4.45, J4.46, U2.U1 (PB1)
/PB2: J4.75, J4.76, U2.V13 (PB2)
/PB4: J4.5, J4.6, U2.B6 (PB4)
/PB7: J4.9, J4.10, U2.A3 (PB7)
/PB8: J4.73, J4.74, U2.V4 (PB8)
/PB10: J6.55, J6.56, U2.U5 (PB10)
/PB14: J6.1, J6.2, U2.1A4 (PB14)
/PB15: J6.5, J6.6, U2.C8 (PB15)
/PC0: J4.51, J4.52, U2.U4 (PC0)
/PC1: J4.37, J4.38, U2.T2 (PC1)
/PC2: J4.35, J4.36, U2.P2 (PC2)
/PC3: J4.33, J4.34, U2.P3 (PC3)
/PC4: J4.49, J4.50, U2.V2 (PC4)
/PC5: J4.47, J4.48, U2.V1 (PC5)
/PC8: CON1.7 (DAT0), J6.7, J6.8, U2.A9 (PC8)
/PC9: CON1.8 (DAT1), J6.9, J6.10, U2.B9 (PC9)
/PC10: CON1.1 (DAT2), J6.13, J6.14, U2.B10 (PC10)
/PC11: CON1.2 (CD/DAT3), J6.15, J6.16, U2.C11
/PC12: CON1.5 (CLK), J6.19, J6.20, U2.1B4 (PC12)
/PD0: J4.7, J4.8, U2.C5 (PD0)
/PD1: J4.13, J4.14, U2.A2 (PD1)
/PD2: CON1.3 (CMD), J6.17, J6.18, U2.1A5 (PD2)
/PD7: J4.11, J4.12, U2.B3 (PD7)
/PD11: J6.49, J6.50, U2.U8 (PD11)
/PD12: J6.45, J6.46, U2.U14 (PD12)
/PD13: J6.47, J6.48, U2.U13 (PD13)
/PE0: J6.43, J6.44, U2.C2 (PE0)
/PE2: J4.69, J4.70, U2.P1 (PE2)
/PE3: J4.1, J4.2, U2.1A3 (PE3)
/PE4: CON1.10 (SDDET1), J6.11, J6.12, U2.A10 (PE4)
/PE6: J4.15, J4.16, U2.B2 (PE6)
/PE10: J6.63, J6.64, U2.V12 (PE10)
/PE12: J4.19, J4.20, U2.C1 (PE12)
/PE13: J4.21, J4.22, U2.E3 (PE13)
/PF11: J4.61, J4.62, U2.W4 (PF11)
/PG9: J6.57, J6.58, U2.W8 (PG9)
/PG10: J6.51, J6.52, U2.U7 (PG10)
/PG13: J4.71, J4.72, U2.R3 (PG13)
/PG15: J4.17, J4.18, U2.B1 (PG15)
/PWR_ON: R41.1, U2.M2 (PWR_ON), U15.5 (EN)
/PWR_ONRST: D11.2 (A), R41.2, U16.5 (EN), U17.5 (EN)
/UART_RX: J1.3, U2.C10 (PC7)
/UART_TX: J1.1, U2.A4 (PC6)
/USB_HS_D+: J3.A6 (D+1), J3.B6 (D+2), J6.75, J6.76, U3.6 (I/O1)
/USB_HS_D-: J3.A7 (D-1), J3.B7 (D-2), J6.77, J6.78, U3.4 (I/O2)
/USB_HS_DM: U2.W10 (USB_DM2), U3.3 (I/O2)
/USB_HS_DP: U2.V10 (USB_DP2), U3.1 (I/O1)
/USB_RREF: R3.2, U2.1J8 (USB_RREF)
/USB_VBUS: R4.2, R5.1, U2.V16 (OTG_VBUS)
/USB_VBUS_JACK: J3.A4B9 (VBUS1), J3.B4A9 (VBUS3), J5.2, J6.71, J6.72, R4.1, U3.5 (VBUS)
GND: C12.2, C13.1, C14.1, C21.1, C24.1, C29.1, C32.1, C40.1, C42.2, C43.2, C46.1, C47.1, C48.1, C49.1, C50.1, C51.1, C52.1, C53.1, C54.1, C55.1, C56.2, C59.1, C60.1, C61.1, C62.1, C63.1, C64.1, C70.1, C71.2, C73.1, C74.2, C75.2, C76.1, C79.1, C80.2, C81.1, C82.1, C83.1, C87.1, C88.1, C89.1, C90.1, C91.1, C92.2, C93.1, C94.2, C95.1, C98.2, C99.2, C102.2, C103.2, C106.2, C109.1, CON1.6 (VSS), CON1.9 (SHELL1), CON1.11 (SDDET2), J1.2, J1.4, J1.6, J1.8, J2.3, J2.5, J2.9, J3.A1B12 (GND1), J3.B1A12 (GND3), J3.SH1 (Shield1), J3.SH2 (Shield2), J3.SH3 (Shield3), J3.SH4 (Shield4), J4.23, J4.24, J4.67, J4.68, J4.77, J4.78, J4.79, J4.80, J6.21, J6.22, J6.31, J6.32, J6.33, J6.34, J6.35, J6.36, J6.37, J6.38, J6.39, J6.40, J6.53, J6.54, J6.69, J6.70, J6.73, J6.74, J6.79, J6.80, NT2.2, R3.1, R5.2, R10.2, R11.2, R52.2, R59.1, R62.1, R64.1, R66.1, R67.1, R69.1, R71.2, R72.2, S2.1, S2.2, U2.1A6 (VSS), U2.1B8 (VSS), U2.1C3 (VSS), U2.1C5 (VSS), U2.1C7 (VSS), U2.1D2 (VSS), U2.1D4 (VSS), U2.1D6 (VSS), U2.1E3 (VSS), U2.1E5 (VSS), U2.1E7 (VSS), U2.1F4 (VSS), U2.1F6 (VSS), U2.1G2 (VSS), U2.1G5 (VSS), U2.1G7 (VSS), U2.1H2 (VSS), U2.1H3 (VSS), U2.1H4 (VSS), U2.1H6 (VSS), U2.1H8 (VSS), U2.1J5 (VSS), U2.1J9 (VSS), U2.A1 (VSS), U2.A6 (VSS), U2.A19 (VSS), U2.C14 (VSS), U2.D17 (VSS), U2.F3 (VSS), U2.F18 (VSS), U2.G1 (VSS), U2.G17 (VSS), U2.K3 (BOOT1), U2.K17 (VSS), U2.K19 (VSS), U2.N1 (VSS), U2.N17 (VSS), U2.R19 (VSS), U2.U9 (VSS), U2.U11 (BYPASS_REG1V8), U2.W1 (VSS), U2.W5 (VSS), U2.W13 (VSS), U2.W19 (VSS), U3.2 (GND), U5.4 (GND), U14.A9 (VSS), U14.B1 (VSSQ), U14.B3 (VSS), U14.B9 (VSSQ), U14.D1 (VSSQ), U14.D8 (VSSQ), U14.E1 (VSS), U14.E2 (VSSQ), U14.E8 (VSSQ), U14.F9 (VSSQ), U14.G1 (VSSQ), U14.G8 (VSS), U14.G9 (VSSQ), U14.J2 (VSS), U14.J8 (VSS), U14.M1 (VSS), U14.M9 (VSS), U14.P1 (VSS), U14.P9 (VSS), U14.T1 (VSS), U14.T9 (VSS), U15.3 (GND), U16.3 (GND), U17.3 (GND), U19.2 (GND), U20.2 (GND), U20.7 (EP), X1.2, X1.4
GNDADC: C30.2, C31.1, C33.1, C41.2, C44.2, C45.1, C72.2, C84.1, J4.25, J4.26, J4.65, J4.66, NT2.1, U2.1G1 (VSSA), U13.3 (GND), U18.2 (GND)
unnamed: J2.10, JP1.2 (C)
unnamed: J3.A5 (CC1), R10.1
unnamed: J3.B5 (CC2), R11.1
unnamed: C13.2, U2.H2 (PH0-OSC_IN), X1.3
unnamed: C14.2, U2.J2 (PH1-OSC_OUT), X1.1
unnamed: C29.2, U2.1J6 (VDDA1V1_REG)
unnamed: R52.1, U2.1A8 (DDR_ZQ)
unnamed: R59.2, U14.L8 (ZQ)
unnamed: C67.2, U15.4 (BST)
unnamed: R61.1, R62.2, U15.6 (FB)
unnamed: C67.1, L1.1, U15.2 (SW)
unnamed: C68.2, U16.4 (BST)
unnamed: R63.1, R64.2, U16.6 (FB)
unnamed: C68.1, L2.1, U16.2 (SW)
unnamed: C69.2, U17.4 (BST)
unnamed: R65.1, R66.2, U17.6 (FB)
unnamed: C69.1, L3.1, U17.2 (SW)
unnamed: C72.1, U18.3 (Noise)
unnamed: C56.1, R60.2, U19.1 (EN)
unnamed: C75.1, U19.3 (Noise)
VDD: BOOT0_2.1, BOOT0_2.2, C51.2, C54.2, C60.2, C63.2, C88.2, J2.1, S3.1, U2.1D1 (VBAT), U2.1E2 (VDD), U2.1F3 (VDD), U2.1G3 (VDD), U2.1G4 (VDD), U2.1J3 (VDD), U2.K2 (PDR_ON_CORE), U2.L3 (PDR_ON), U18.1 (EN), U19.4 (OUT), U20.1 (IN)
VDDA: C30.1, C31.2, C84.2, U2.1F1 (VDDA), U2.1F2 (VDDA), U18.4 (OUT)
VDDA_1V8: C32.2, U2.1H5 (VDDA1V8_REG), U20.3 (EN)
VDD_CORE: C50.2, C53.2, C59.2, C62.2, C70.2, C73.2, C79.2, C89.2, L1.2, R61.2, U2.1B3 (VDDCORE), U2.1B5 (VDDCORE), U2.1C4 (VDDCORE), U2.1C6 (VDDCORE), U2.1D3 (VDDCORE), U2.1D5 (VDDCORE), U2.1D7 (VDDCORE), U2.1E4 (VDDCORE), U2.1E6 (VDDCORE), U2.1E8 (VDDCORE), U2.1F5 (VDDCORE), U2.1F7 (VDDCORE), U2.1G6 (VDDCORE), U2.1G8 (VDDCORE)
VDD_DDR: C52.2, C55.2, C61.2, C64.2, C71.1, C74.1, C80.1, C81.2, C82.2, C83.2, C87.2, C91.2, C92.1, C93.2, C94.1, C95.2, C98.1, C99.1, C102.1, C103.1, C106.1, L3.2, R65.2, R70.1, U2.1B9 (VDDQ_DDR), U2.1D9 (VDDQ_DDR), U2.1F9 (VDDQ_DDR), U2.1H9 (VDDQ_DDR), U14.A1 (VDDQ), U14.A8 (VDDQ), U14.B2 (VDD), U14.C1 (VDDQ), U14.C9 (VDDQ), U14.D2 (VDDQ), U14.D9 (VDD), U14.E9 (VDDQ), U14.F1 (VDDQ), U14.G7 (VDD), U14.H2 (VDDQ), U14.H9 (VDDQ), U14.K2 (VDD), U14.K8 (VDD), U14.N1 (VDD), U14.N9 (VDD), U14.R1 (VDD), U14.R9 (VDD)
VDD_USB: C76.2, U2.1H7 (VDD3V3_USB), U20.5 (OUT)
VREF+: C33.2, C44.1, J4.27, J4.28, J4.63, J4.64, U2.M3 (VREF+), U13.2 (VO)
VREF_DDR: C40.2, C42.1, C43.1, C109.2, R70.2, R71.1, U2.W16 (DDR_VREF), U14.H1 (VREFDQ), U14.M8 (VREFCA)

Notes on the sheet:
SPI2_SCK
SPI3_SCK
LCD_G6 conflicts with PC7 (UART_RX) - Route PC7 to mezzanine. Use PG9 for USART6_RX (or else choose diff. UART)
DFU Boot requires MP1-DFU-USB bootloader installed
SPI4_SCK
SDMMC_CMD
UART7_TX
DAC0
Carrier board must supply +5V to North header or else use USB jack with J5 jumped
microSD
I2C1_SDA
HSYNC conflicts with PC6 (UART_TX) - Route PC6 to mezzanine. Maybe route PG14 (USART6_TX) to debug header, or use different UART
SPI2_MISO
SPI3_NSS
ADC-5
SAI2_SD_B
SPI3_MISO
SPI3_MOSI
SAI2_MCLK
LCD_B3: route PD10 or PG11 to mezzanine (replace any pin if needed) LCD_R7: route PG6 or PE15 to mezzanine LCD_G7: route PD3 or PB5 or PG8 to mezzanine
POWER
SAI2_FS
I2C2_SDA
SD_CARD_DETECT
ADC-18_DAC0
ADC-15
ADC-8
SAI1_SD_A
BOOT SWITCHES
I2C6_SDA
I2C5_SCL
SPI4_MISO
I2C3_SCL
HSYNC
mp153
ADC-4
ADC-16
ADC-19_DAC1
SDMMC_D1
ADC-17
SAI2_SD_A
SDMMC_D3
ADC-14
SAI1_SCK_A
-DK2: R125 not fitted
SWD PROGRAMMING
I2C5_SDA
3.3V for peripherals Rank 2 Brainboard uses 140mA max/typ (est 43mA of 12V)
ADC-9
SAI4_SCK_A
I2C3_SDA
CONNECTORS
SDMMC_CLK
1.35V and 0.65V for DDR3 Turns on after Vddcore is stable Power cycle on reset Datasheet recommends 1.5uH (AP623) or 2.2uH (AP622)
ADC-2
SPI2_NSS
SAI1_SD_B
ADC-12
3.3V, Rank 3 VDD3V3_USB turns on when VDDA_1V8 is present, which is powered by VDD.
VSYNC
ADC-13
SPI2_MOSI
SAI1_FS_A
SAI1_MCLK
Analog 3.3V Turns on after Vdd
SDMMC_D0
ADC-11
To connect to VDD_DDR power plane
ADC-7
SDMMC_D2
ADC-10
SAI4_SD_B
USB
I2C2_SCL
PROCESSOR
DAC1
To provide 16-bit RGB565 interface:
DEVBOARD
ADC-19
UART7_RX
Turn-on at EN=1.5V @100k/100nF: t = 1.3ms
SAI2_SCK
ADC-18
I2C6_SCL
ADC-3
BOOT0 BOOT2 SD Card On On Flash On Off Debugger Off On
ON = allow USB jack to provide +5V to board
Carrier board should use VREF and GNDADC for all ADC circuitry
FIXES for p1 to make p2: - SDMMC1 pins missing 10k pull-ups - Orientation of BOOT switch is unclear (JLC placed it backwards on first run) only needed on one of the pins
SPI4_MOSI
Reset
1.2V, Rank 2 IDDCORE_{max} = 1050mA Should be 1.34V to enable 800MHz, but seems to work ok at 1.2V? Ratio for 1.2V: 2:1 Ratio for 1.34V: 1.48:1 or 1:0.675 (14.7k/10k) Datasheet recommends 1.5uH (AP623) or 2.2uH (AP622)
Carrier board can use 3.3V max 500mA(??)
I2C1_SCL
LCD_G3 conflicts with DEBUG3: - Route PE11 to mezzanine header and use a different pin for DEBUG3 LCD_B7 conflicts with DEGBUG2: - Route PB9 to mezzanine header and use a different pin for DEBUG2
Debugging
+3.3V Rank 1 18mA typ, with >25mA peak on p7-screen/p6-controls
DDR RAM
