4ms/mp153-devboard/v0.1/mp153-devboard.kicad_pcb

## KiCad design v0.1/mp153-devboard.kicad_pcb (continued)

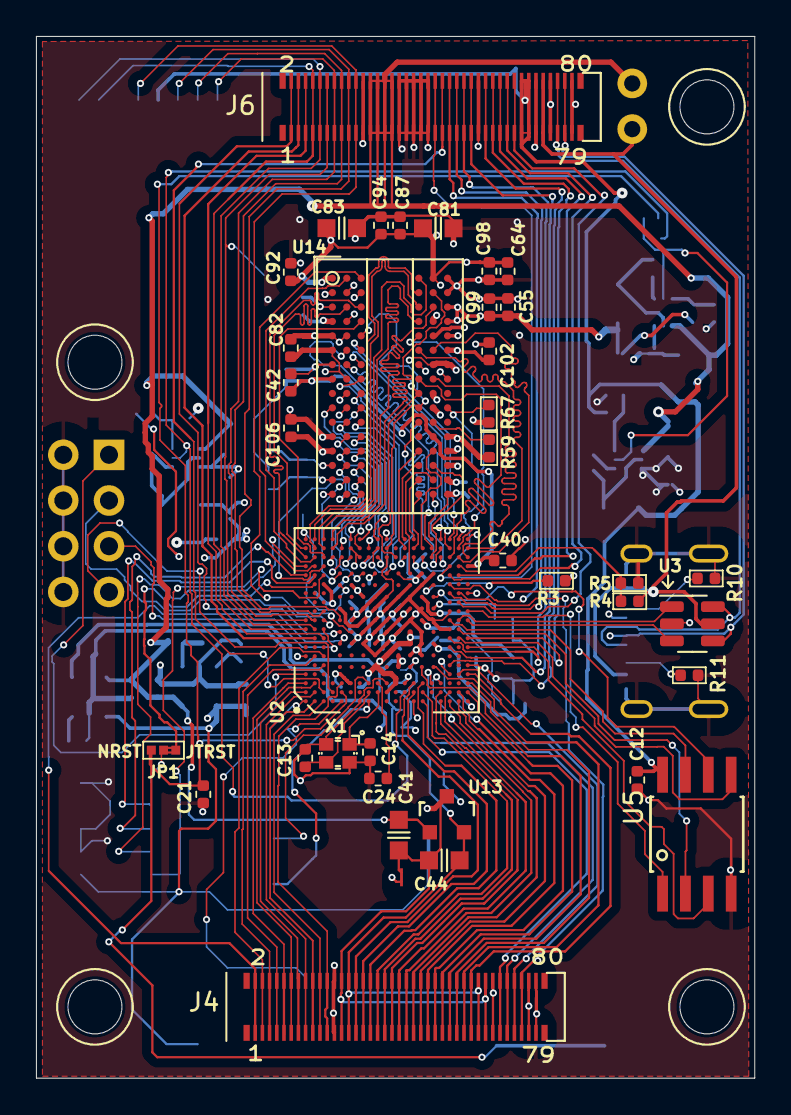
[picture p27: board mp153-devboard.kicad_pcb from above]

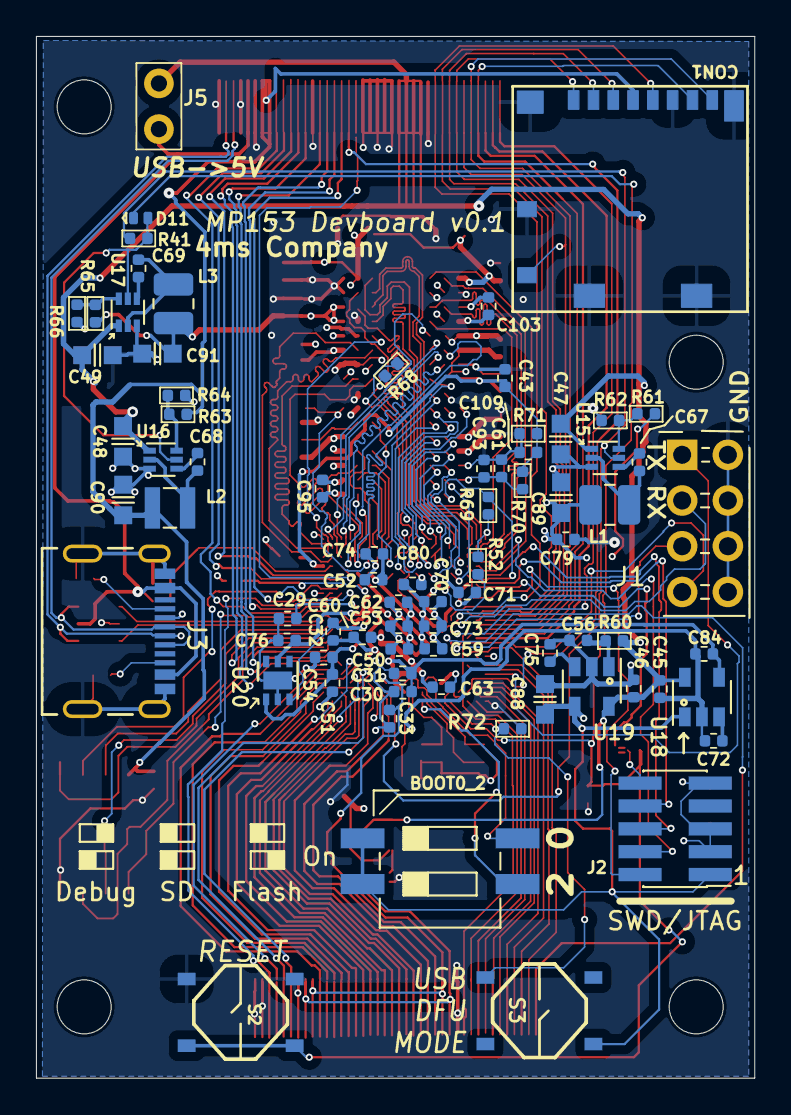
[picture p28: board mp153-devboard.kicad_pcb from below]

Board: 4 copper layers, 39.9 x 57.9 mm, 117 parts (75 on the bottom side), 163 nets.
