4ms/mp153-devboard/carrier board/v0.1/mp153-carrier-board.kicad_pcb

## KiCad design carrier board/v0.1/mp153-carrier-board.kicad_pcb (2025-06-11, an earlier design)

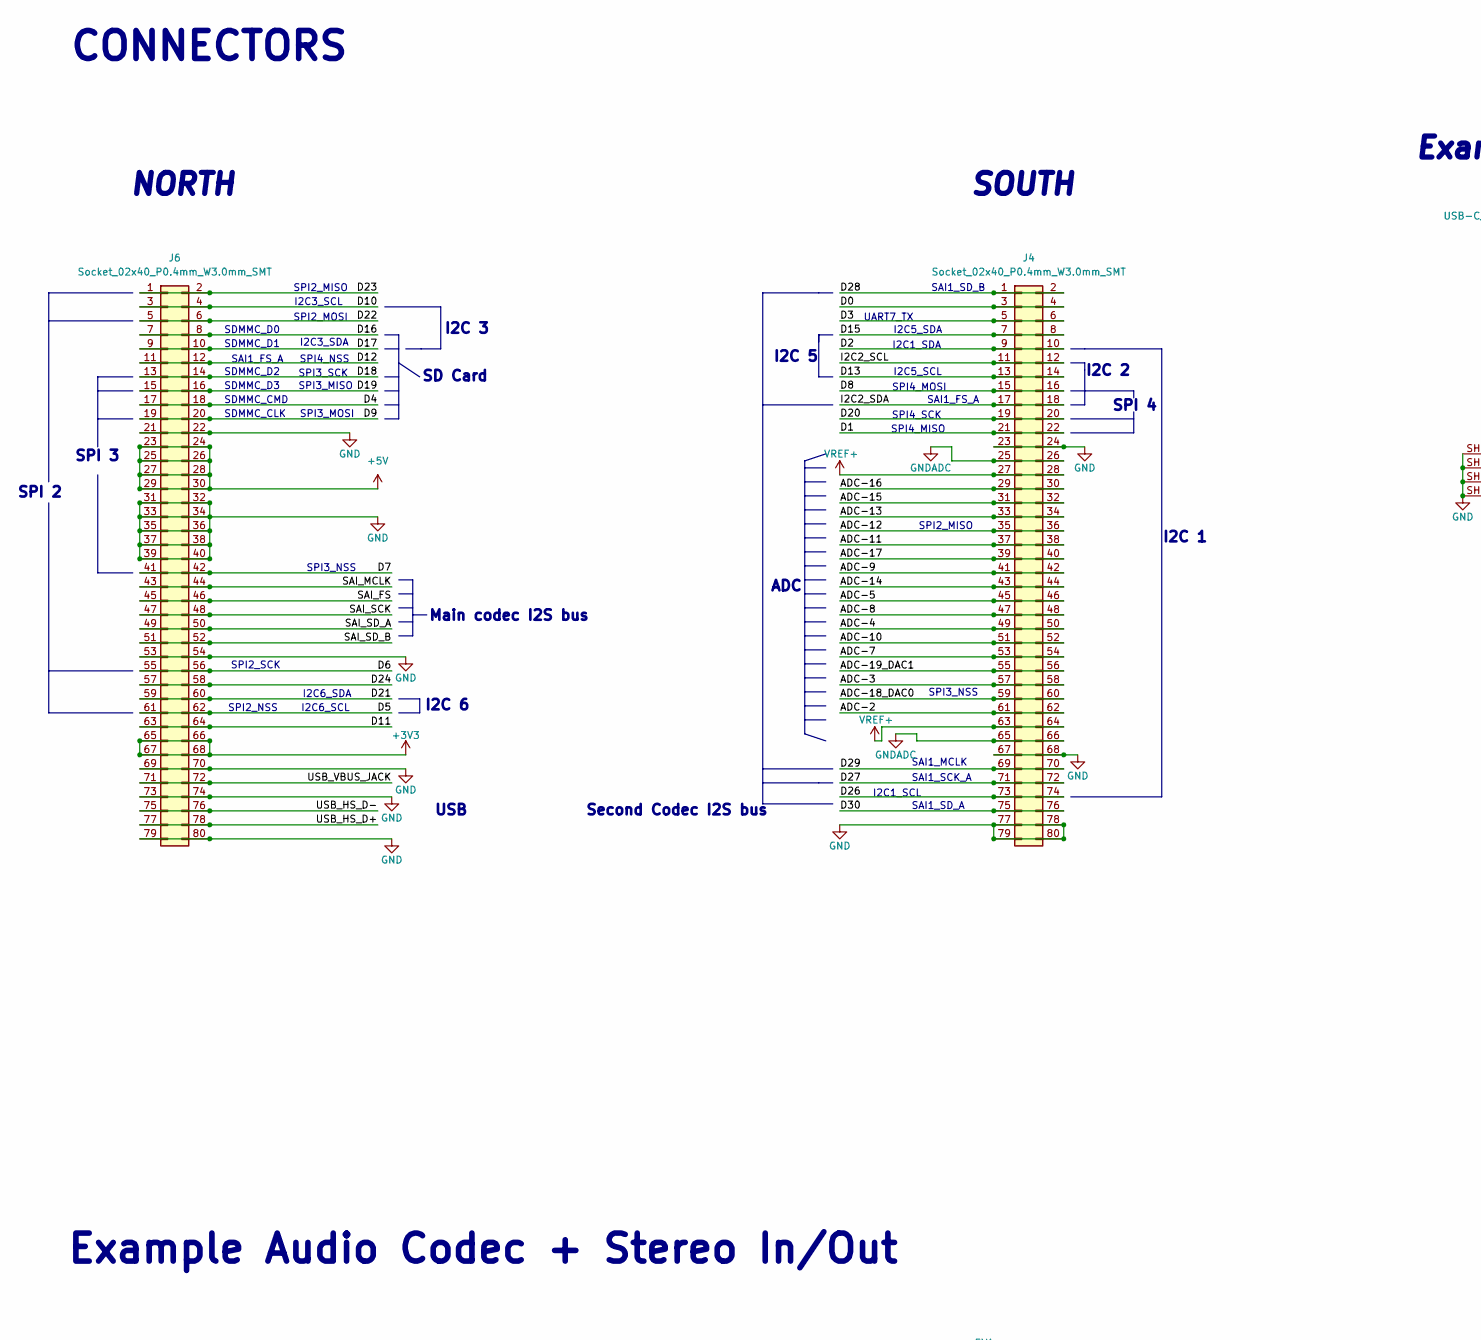
[picture p29: schematic mp153-carrier-board.kicad_sch, part in row 1, column 1]

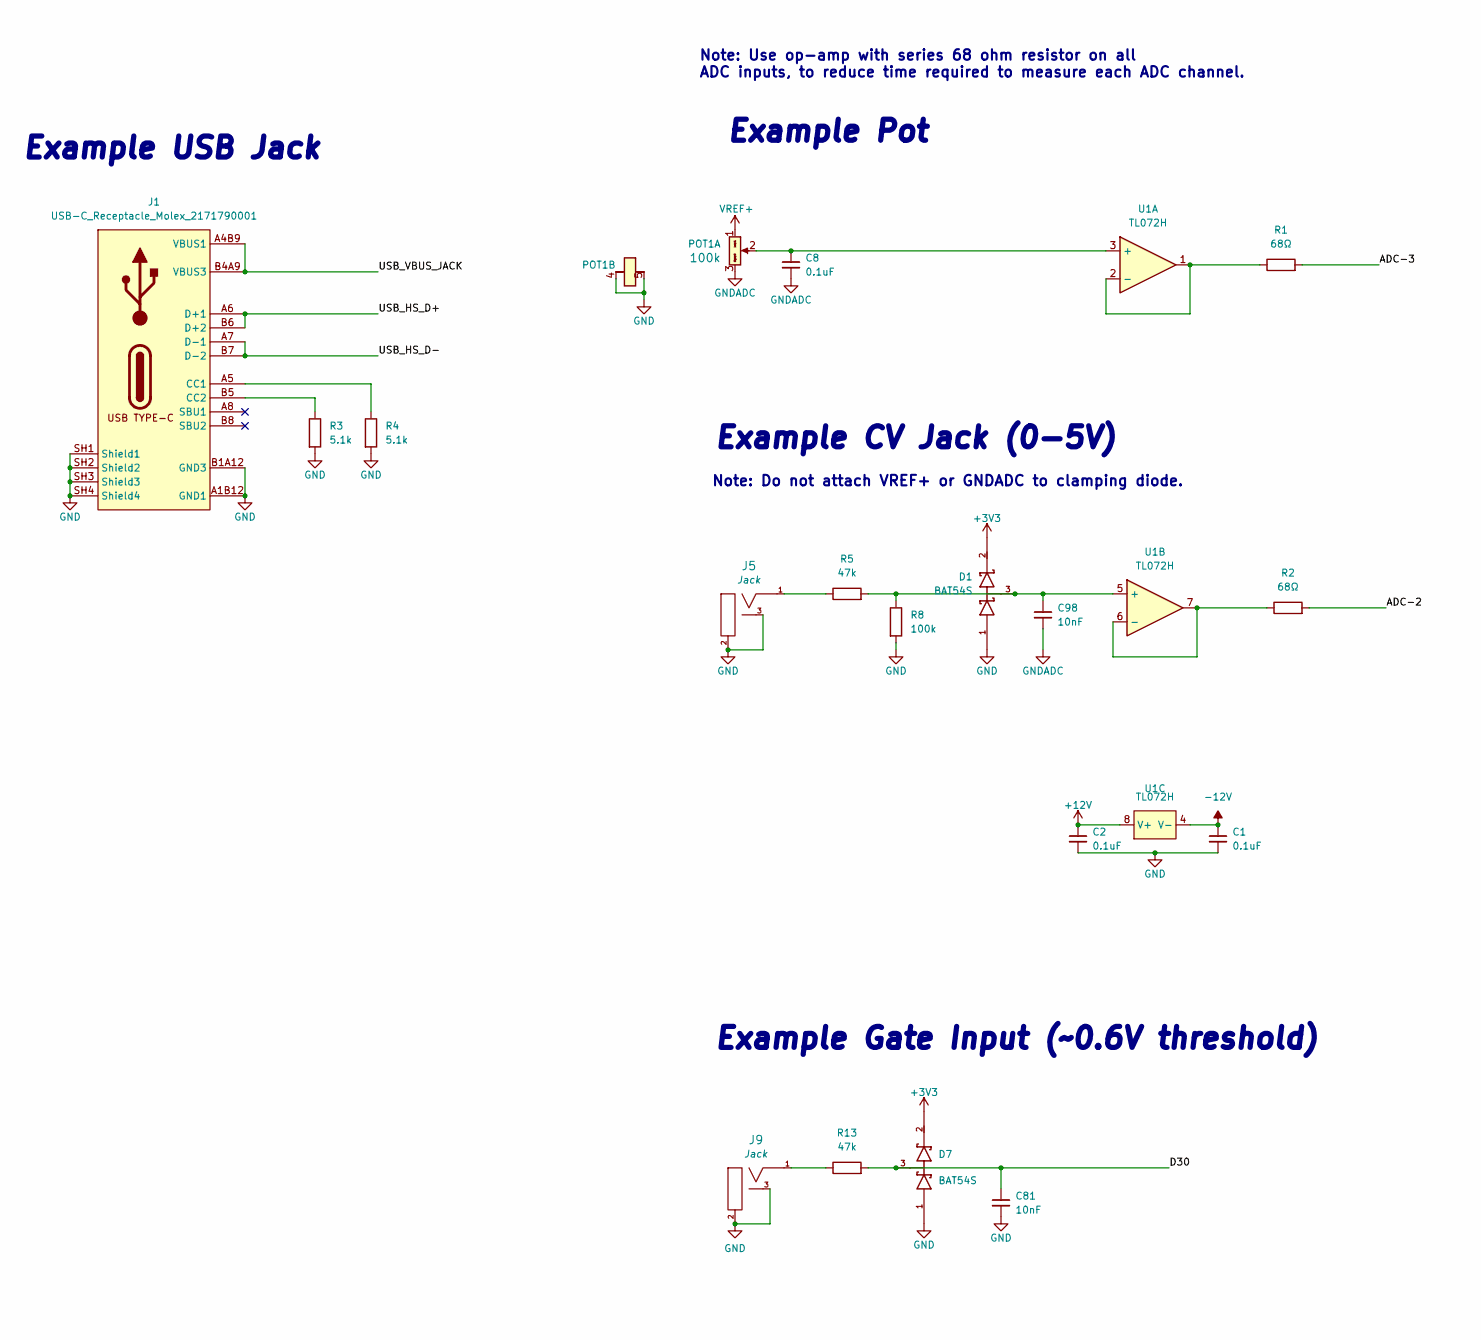
[picture p30: schematic mp153-carrier-board.kicad_sch, part in row 1, column 2]

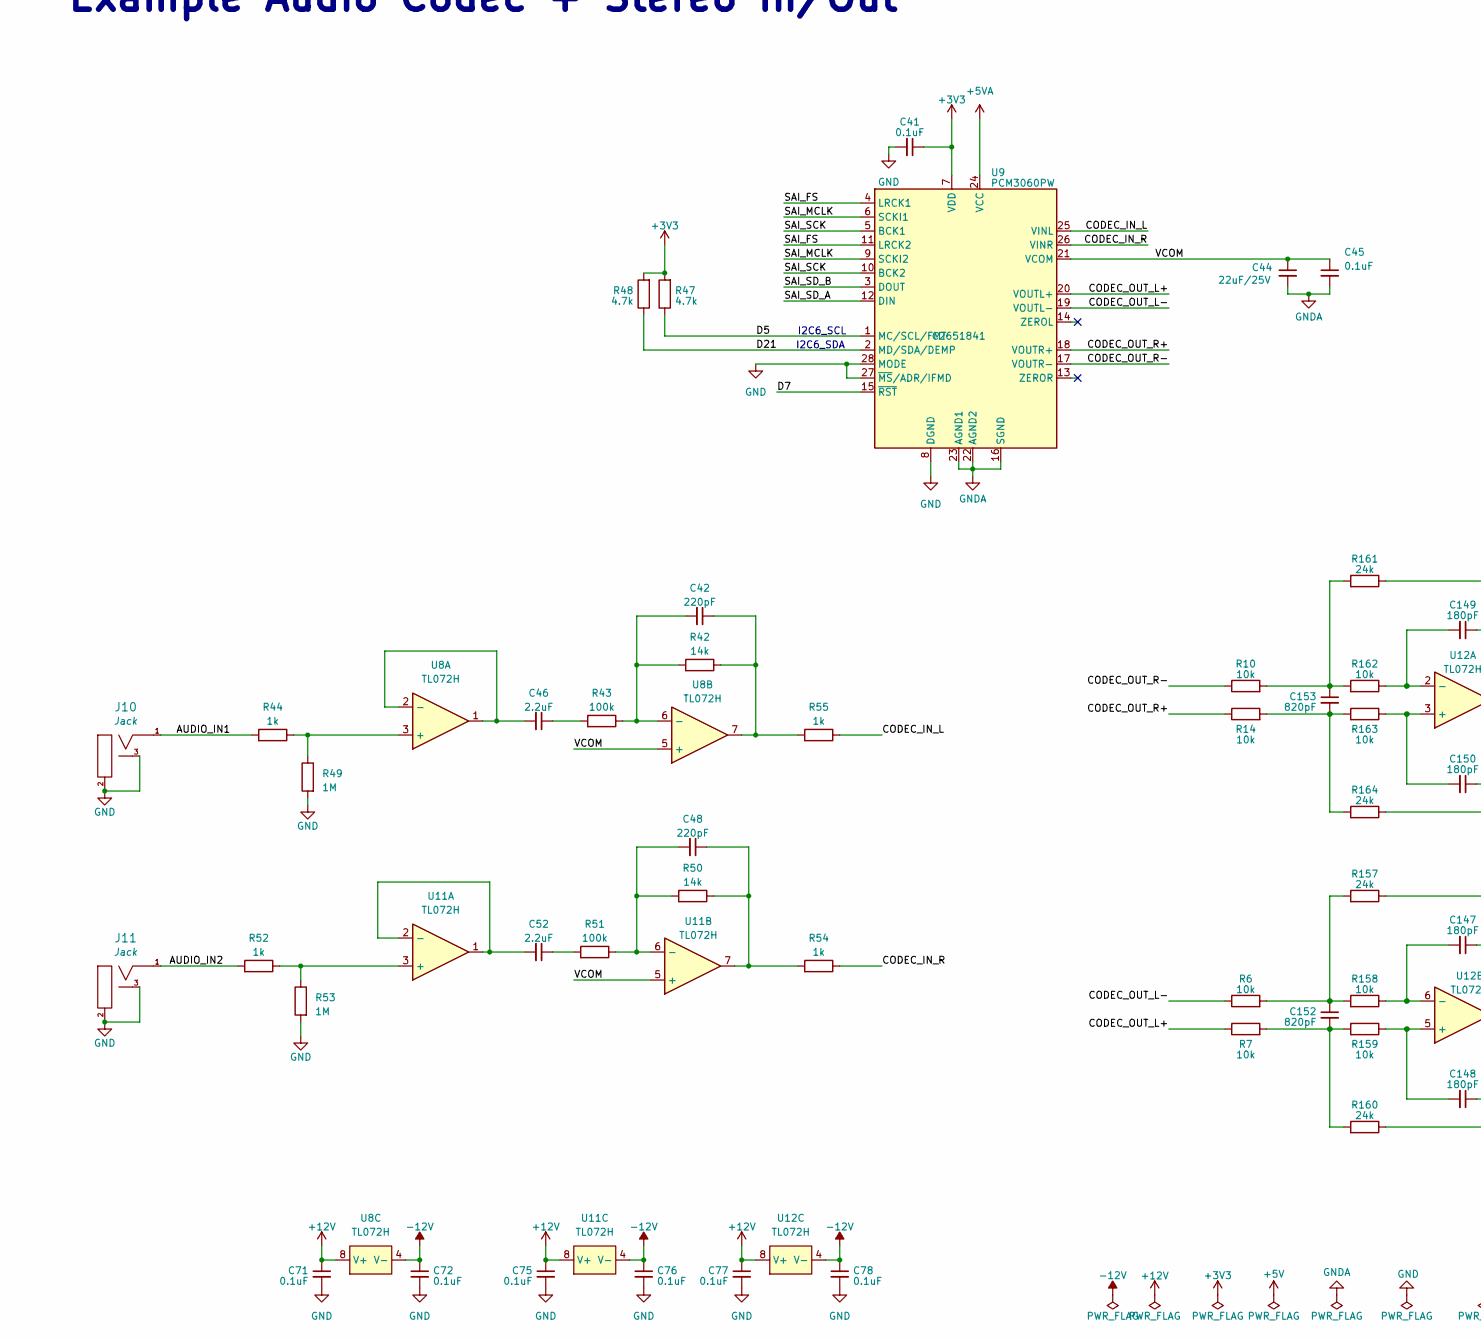
[picture p31: schematic mp153-carrier-board.kicad_sch, part in row 2, column 1]

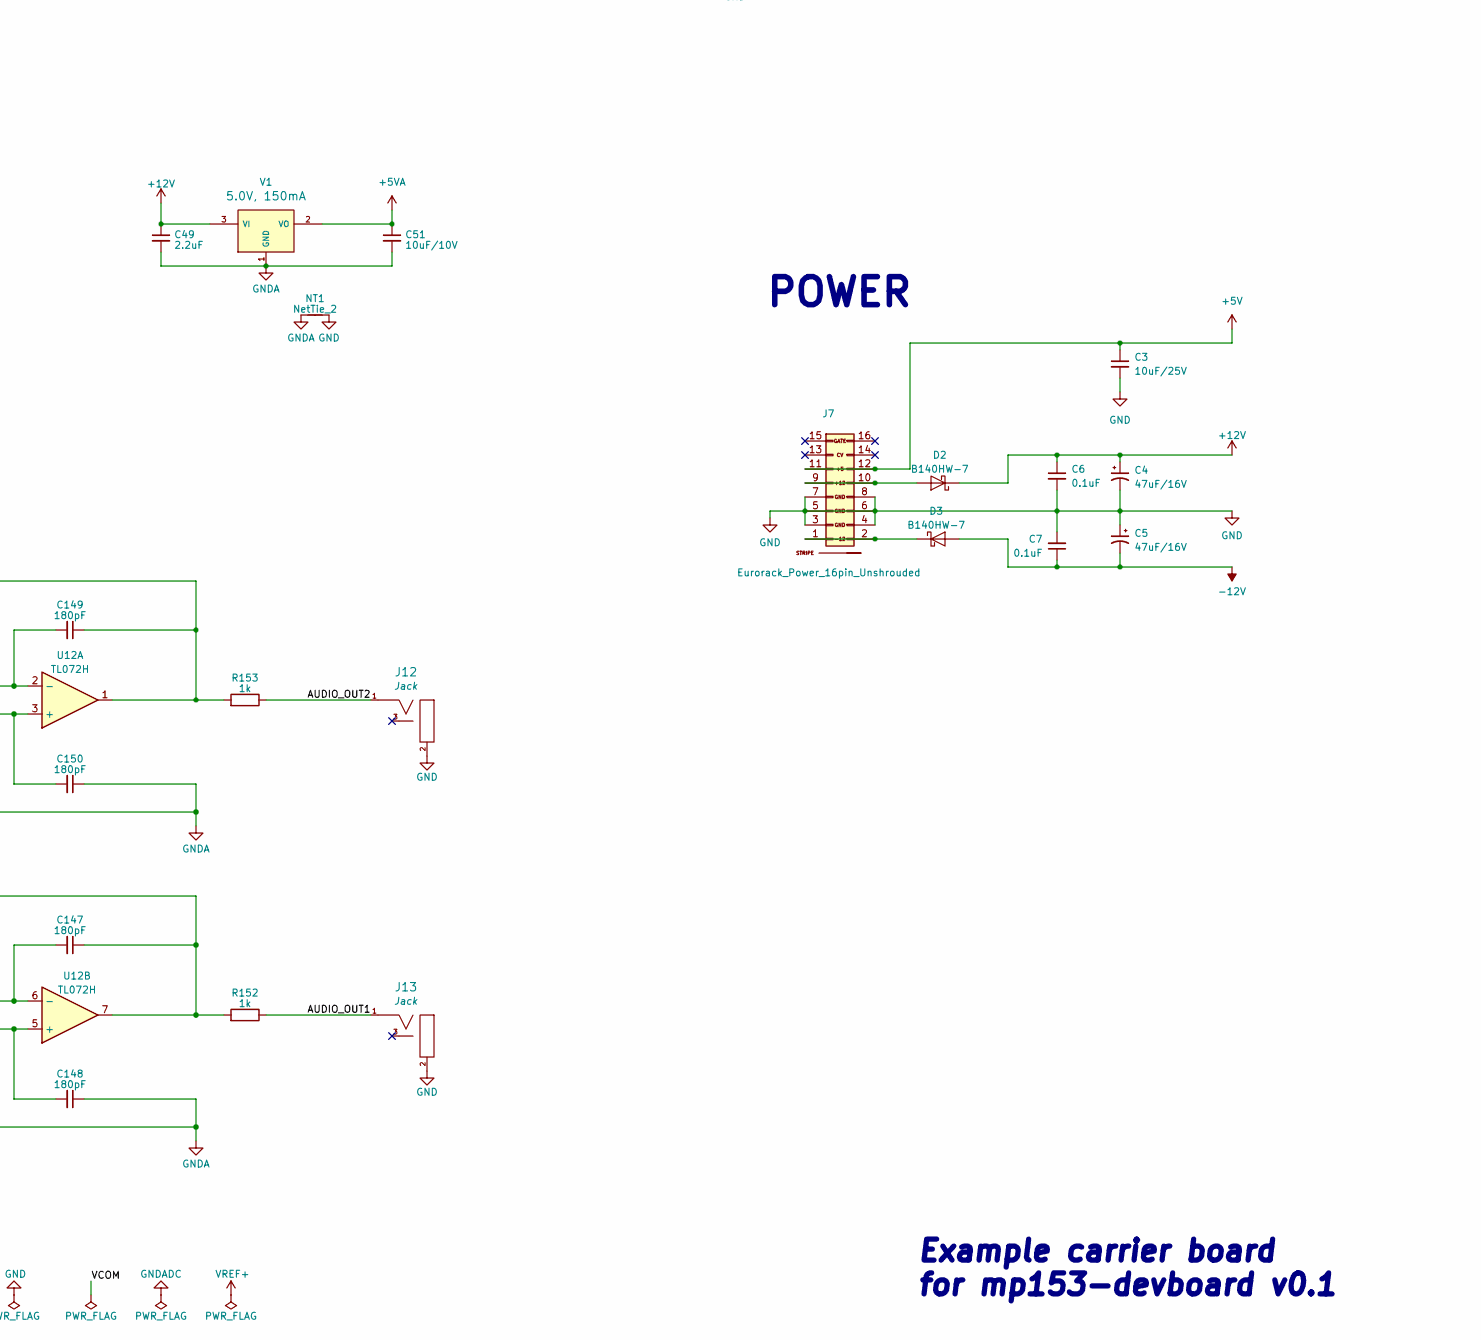
[picture p32: schematic mp153-carrier-board.kicad_sch, part in row 2, column 2]

Parts:
C1, C2, C6, C7, C8: 100nF_0603_16V; C_0603; Part Number 0603YC104KAT2A; JLCPCB ID C14663
C3: 10uF_0805_25V; C_0805; Part Number GRM21BR61E106MA73L; JLCPCB ID C15850
C4, C5: 47uF_5x5.3_16V; CP_Elec_5x5.3; Part Number VES470M1CTR-0505; JLCPCB ID C134798
C41, C45: 100nF_0402_16V; C_0402; Part Number GCM155R71C104KA55D; JLCPCB ID C1525
C42, C48: 220pF_0603_25V; C_0603; Part Number CC0603JRNPO9BN221; JLCPCB ID C1603
C44: 22uF_0805_25V; C_0805; Part Number GRM21BR61E226ME44L; JLCPCB ID C45783
C46, C49, C52: 2.2uF_0603_25V; C_0603; Part Number GRM188R6YA225KA12D; JLCPCB ID C57895
C51: 10uF_0603_10V; C_0603; Part Number GRM188R61A106KE69D; JLCPCB ID C19702
C71, C72, C75, C76, C77, C78: 100nF_0402_50V; C_0402; Part Number GRM155R71H104KE14D; JLCPCB ID C307331
C81, C98: 10nF_0603_25V; C_0603; Part Number 06035C103KAT2A; JLCPCB ID C57112
C147, C148, C149, C150: 180pF_0402_25V; C_0402; Part Number GRM1555C2A181JE01D; JLCPCB ID C106999
C152, C153: 820pF_0402_10v; C_0402; Part Number 0402ZC821KAT2A; JLCPCB ID C565563
D1, D7: BAT54S; SOT23-3_PO132; Part Number BAT54S-7-F; JLCPCB ID C83574
D2, D3: B140HW-7; D_SOD-123; Part Number B140HW-7; JLCPCB ID C134429
J1: USB-C_Receptacle_Molex_2171790001; USB_C_Receptacle_Molex_2171790001; Part Number 217179-0001; JLCPCB ID C2894899
J4, J6: Socket_02x40_P0.4mm_W3.0mm_SMT; Connector-80socket-P0.4mm-W3.0mm; Part Number DF40HC(3.0)-80DS-0.4V(51); JLCPCB ID C2858577
J5, J9, J10, J11, J12, J13: 3.5mm_Mono_Switched_sm; EighthInch_PJ398SM; Part Number WQP-WQP518MA
J7: Eurorack_Power_16pin_Unshrouded; Pins_2x08_2.54mm_TH_EurorackPower; Part Number 1-1602FBV0T
NT1: NetTie_2; NetTie-2_SMD_Pad0.5mm
POT1: 9mm_NoDet_100k_Knurled_Lined; Pot_9mm_Knurl_NoDet; Part Number R0904N-B100K L-25KQ/LWS
R1, R2: 68Ω_0603; R_0603; Part Number RC0603FR-0768RL; JLCPCB ID C126362
R3, R4: 5.1k_0603; R_0603; Part Number RC0603FR-075K1L; JLCPCB ID C105580
R5, R13: 47k_0603; R_0603; Part Number RC0603FR-0747KL; JLCPCB ID C105579
R6, R7, R10, R14, R158, R159, R162, R163: 10k_0402; R_0402; Part Number RC0402FR-0710KL; JLCPCB ID C60490
R8: 100k_0603; R_0603; Part Number RC0603FR-07100KL; JLCPCB ID C14675
R42, R50: 14k_0402; R_0402; Part Number RC0402FR-0714KL; JLCPCB ID C327372
R43, R51: 100k_0402; R_0402; Part Number RC0402FR-07100KL; JLCPCB ID C60491
R44, R52, R54, R55, R152, R153: 1k_0402; R_0402; Part Number RC0402FR-071KL; JLCPCB ID C106235
R47, R48: 4.7k_0402; R_0402; Part Number RC0402FR-074K7L; JLCPCB ID C105871
R49, R53: 1M_0402; R_0402; Part Number RC0402FR-071ML; JLCPCB ID C138033
R157, R160, R161, R164: 24k_0402; R_0402; Part Number RC0402FR-0724KL; JLCPCB ID C138026
U1, U8, U11, U12: TL072H; TSSOP-8_4.4x3mm_Pitch0.65mm; Part Number TL072HIPWR; JLCPCB ID C4370341
U9: PCM3060PW; TSSOP-28_4.4x9.7mm_P0.65mm; Part Number PCM3060PW; JLCPCB ID C2651841
V1: AP2120N-5.0TRG1; SOT23-3_PO132; Part Number AP2120N-5.0TRG1; JLCPCB ID C50754

Connections:
+3V3: C41.1, D1.2 (cathode), D7.2 (cathode), J6.65, J6.66, J6.67, J6.68, R47.2, R48.2, U9.7 (VDD)
+5V: C3.1, J6.23, J6.24, J6.25, J6.26, J6.27, J6.28, J6.29, J6.30, J7.11 (5V), J7.12 (5V)
+5VA: C51.1, U9.24 (VCC), V1.2 (VO)
+12V: C2.1, C4.1, C6.1, C49.1, C71.1, C75.1, C77.1, D2.1 (K), U1.8 (V+), U8.8 (V+), U11.8 (V+), U12.8 (V+), V1.3 (VI)
-12V: C1.1, C5.2, C7.1, C72.1, C76.1, C78.1, D3.2 (A), U1.4 (V-), U8.4 (V-), U11.4 (V-), U12.4 (V-)
/ADC-2: J4.61, J4.62, R2.2
/ADC-3: J4.57, J4.58, R1.2
/ADC-4: J4.49, J4.50
/ADC-5: J4.45, J4.46
/ADC-7: J4.53, J4.54
/ADC-8: J4.47, J4.48
/ADC-9: J4.41, J4.42
/ADC-10: J4.51, J4.52
/ADC-11: J4.37, J4.38
/ADC-12: J4.35, J4.36
/ADC-13: J4.33, J4.34
/ADC-14: J4.43, J4.44
/ADC-15: J4.31, J4.32
/ADC-16: J4.29, J4.30
/ADC-17: J4.39, J4.40
/ADC-18_DAC0: J4.59, J4.60
/ADC-19_DAC1: J4.55, J4.56
/AUDIO_IN1: J10.1 (SIG), R44.2
/AUDIO_IN2: J11.1 (SIG), R52.2
/AUDIO_OUT1: J13.1 (SIG), R152.1
/AUDIO_OUT2: J12.1 (SIG), R153.1
/CODEC_IN_L: R55.1, U9.25 (VINL)
/CODEC_IN_R: R54.1, U9.26 (VINR)
/CODEC_OUT_L+: R7.1, U9.20 (VOUTL+)
/CODEC_OUT_L-: R6.1, U9.19 (VOUTL-)
/CODEC_OUT_R+: R14.1, U9.18 (VOUTR+)
/CODEC_OUT_R-: R10.1, U9.17 (VOUTR-)
/D0: J4.3, J4.4
/D1: J4.21, J4.22
/D2: J4.9, J4.10
/D3: J4.5, J4.6
/D4: J6.17, J6.18
/D5: J6.61, J6.62, R47.1, U9.1 (MC/SCL/FMT)
/D6: J6.55, J6.56
/D7: J6.41, J6.42, U9.15 (~RST)
/D8: J4.15, J4.16
/D9: J6.19, J6.20
/D10: J6.3, J6.4
/D11: J6.63, J6.64
/D12: J6.11, J6.12
/D13: J4.13, J4.14
/D15: J4.7, J4.8
/D16: J6.7, J6.8
/D17: J6.9, J6.10
/D18: J6.13, J6.14
/D19: J6.15, J6.16
/D20: J4.19, J4.20
/D21: J6.59, J6.60, R48.1, U9.2 (MD/SDA/DEMP)
/D22: J6.5, J6.6
/D23: J6.1, J6.2
/D24: J6.57, J6.58
/D26: J4.73, J4.74
/D27: J4.71, J4.72
/D28: J4.1, J4.2
/D29: J4.69, J4.70
/D30: C81.1, D7.3 (AK), J4.75, J4.76, R13.2
/I2C2_SCL: J4.11, J4.12
/I2C2_SDA: J4.17, J4.18
/SAI_FS: J6.45, J6.46, U9.4 (LRCK1), U9.11 (LRCK2)
/SAI_MCLK: J6.43, J6.44, U9.6 (SCKI1), U9.9 (SCKI2)
/SAI_SCK: J6.47, J6.48, U9.5 (BCK1), U9.10 (BCK2)
/SAI_SD_A: J6.49, J6.50, U9.12 (DIN)
/SAI_SD_B: J6.51, J6.52, U9.3 (DOUT)
/USB_HS_D+: J1.A6 (D+1), J1.B6 (D+2), J6.77, J6.78
/USB_HS_D-: J1.A7 (D-1), J1.B7 (D-2), J6.75, J6.76
/USB_VBUS_JACK: J1.A4B9 (VBUS1), J1.B4A9 (VBUS3), J6.71, J6.72
/VCOM: C44.1, C45.1, U8.5 (+), U9.21 (VCOM), U11.5 (+)
GND: C1.2, C2.2, C3.2, C4.2, C5.1, C6.2, C7.2, C41.2, C71.2, C72.2, C75.2, C76.2, C77.2, C78.2, C81.2, D1.1 (Anode), D7.1 (Anode), J1.A1B12 (GND1), J1.B1A12 (GND3), J1.SH1 (Shield1), J1.SH2 (Shield2), J1.SH3 (Shield3), J1.SH4 (Shield4), J4.23, J4.24, J4.67, J4.68, J4.77, J4.78, J4.79, J4.80, J5.2 (SHEILD), J5.3 (SW), J6.21, J6.22, J6.31, J6.32, J6.33, J6.34, J6.35, J6.36, J6.37, J6.38, J6.39, J6.40, J6.53, J6.54, J6.69, J6.70, J6.73, J6.74, J6.79, J6.80, J7.3 (GND), J7.4 (GND), J7.5 (GND), J7.6 (GND), J7.7 (GND), J7.8 (GND), J9.2 (SHEILD), J9.3 (SW), J10.2 (SHEILD), J10.3 (SW), J11.2 (SHEILD), J11.3 (SW), J12.2 (SHEILD), J13.2 (SHEILD), NT1.2, POT1.4 (Tab1), POT1.5 (Tab2), R3.2, R4.2, R8.2, R49.2, R53.2, U9.8 (DGND), U9.27 (~MS/ADR/IFMD), U9.28 (MODE)
GNDA: C44.2, C45.2, C49.2, C51.2, C148.1, C150.1, NT1.1, R160.1, R164.1, U9.16 (SGND), U9.22 (AGND2), U9.23 (AGND1), V1.1 (GND)
GNDADC: C8.2, C98.2, J4.25, J4.26, J4.65, J4.66, POT1.3 (Right)
unnamed: C42.1, R42.1, R55.2, U8.7
unnamed: C46.1, R43.2
unnamed: C48.1, R50.1, R54.2, U11.7
unnamed: C52.1, R51.2
unnamed: C147.1, R152.2, R157.1, U12.7
unnamed: C149.1, R153.2, R161.1, U12.1
unnamed: C152.1, R6.2, R157.2, R158.2
unnamed: C152.2, R7.2, R159.2, R160.2
unnamed: C153.1, R10.2, R161.2, R162.2
unnamed: C153.2, R14.2, R163.2, R164.2
unnamed: C98.1, D1.3 (AK), R5.2, R8.1, U1.5 (+)
unnamed: D2.2 (A), J7.9 (+12V), J7.10 (+12V)
unnamed: D3.1 (K), J7.1 (-12V), J7.2 (-12V)
unnamed: J1.A5 (CC1), R4.1
unnamed: J1.B5 (CC2), R3.1
unnamed: J5.1 (SIG), R5.1
unnamed: J9.1 (SIG), R13.1
unnamed: C8.1, POT1.2 (Center), U1.3 (+)
unnamed: R1.1, U1.1, U1.2 (-)
unnamed: R2.1, U1.6 (-), U1.7
unnamed: R44.1, R49.1, U8.3 (+)
unnamed: C46.2, U8.1, U8.2 (-)
unnamed: C42.2, R42.2, R43.1, U8.6 (-)
unnamed: R52.1, R53.1, U11.3 (+)
unnamed: C52.2, U11.1, U11.2 (-)
unnamed: C48.2, R50.2, R51.1, U11.6 (-)
unnamed: C150.2, R163.1, U12.3 (+)
unnamed: C149.2, R162.1, U12.2 (-)
unnamed: C148.2, R159.1, U12.5 (+)
unnamed: C147.2, R158.1, U12.6 (-)
VREF+: J4.27, J4.28, J4.63, J4.64, POT1.1 (Left)

Notes on the sheet:
SDMMC_CMD
UART7_TX
SPI2_MISO
I2C 5
SPI3_NSS
Example CV Jack (0-5V)
SPI3_MISO
SPI3_SCK
SPI 3
I2C 6
POWER
I2C 3
SPI 4
Second Codec I2S bus
I2C6_SDA
Main codec I2S bus
SPI 2
I2C3_SCL
SD Card
SDMMC_D3
I2C1_SDA
I2C3_SDA
CONNECTORS
SAI1_SD_A
I2C5_SCL
SAI1_SD_B
SDMMC_CLK
I2C6_SCL
Note: Use op-amp with series 68 ohm resistor on all ADC inputs, to reduce time required to measure each ADC channel.
Example Gate Input (~0.6V threshold)
I2C 2
SPI4_SCK
SPI2_MOSI
SAI1_FS_A
SPI4_MISO
SOUTH
NORTH
Example USB Jack
Note: Do not attach VREF+ or GNDADC to clamping diode.
SPI4_NSS
I2C 1
Example Audio Codec + Stereo In/Out
ADC
SPI2_NSS
Example Pot
I2C5_SDA
SAI1_SCK_A
Example carrier board for mp153-devboard v0.1
SDMMC_D0
SAI1_MCLK
SPI2_SCK
SDMMC_D2
I2C1_SCL
SPI3_MOSI
USB
SDMMC_D1
SPI4_MOSI

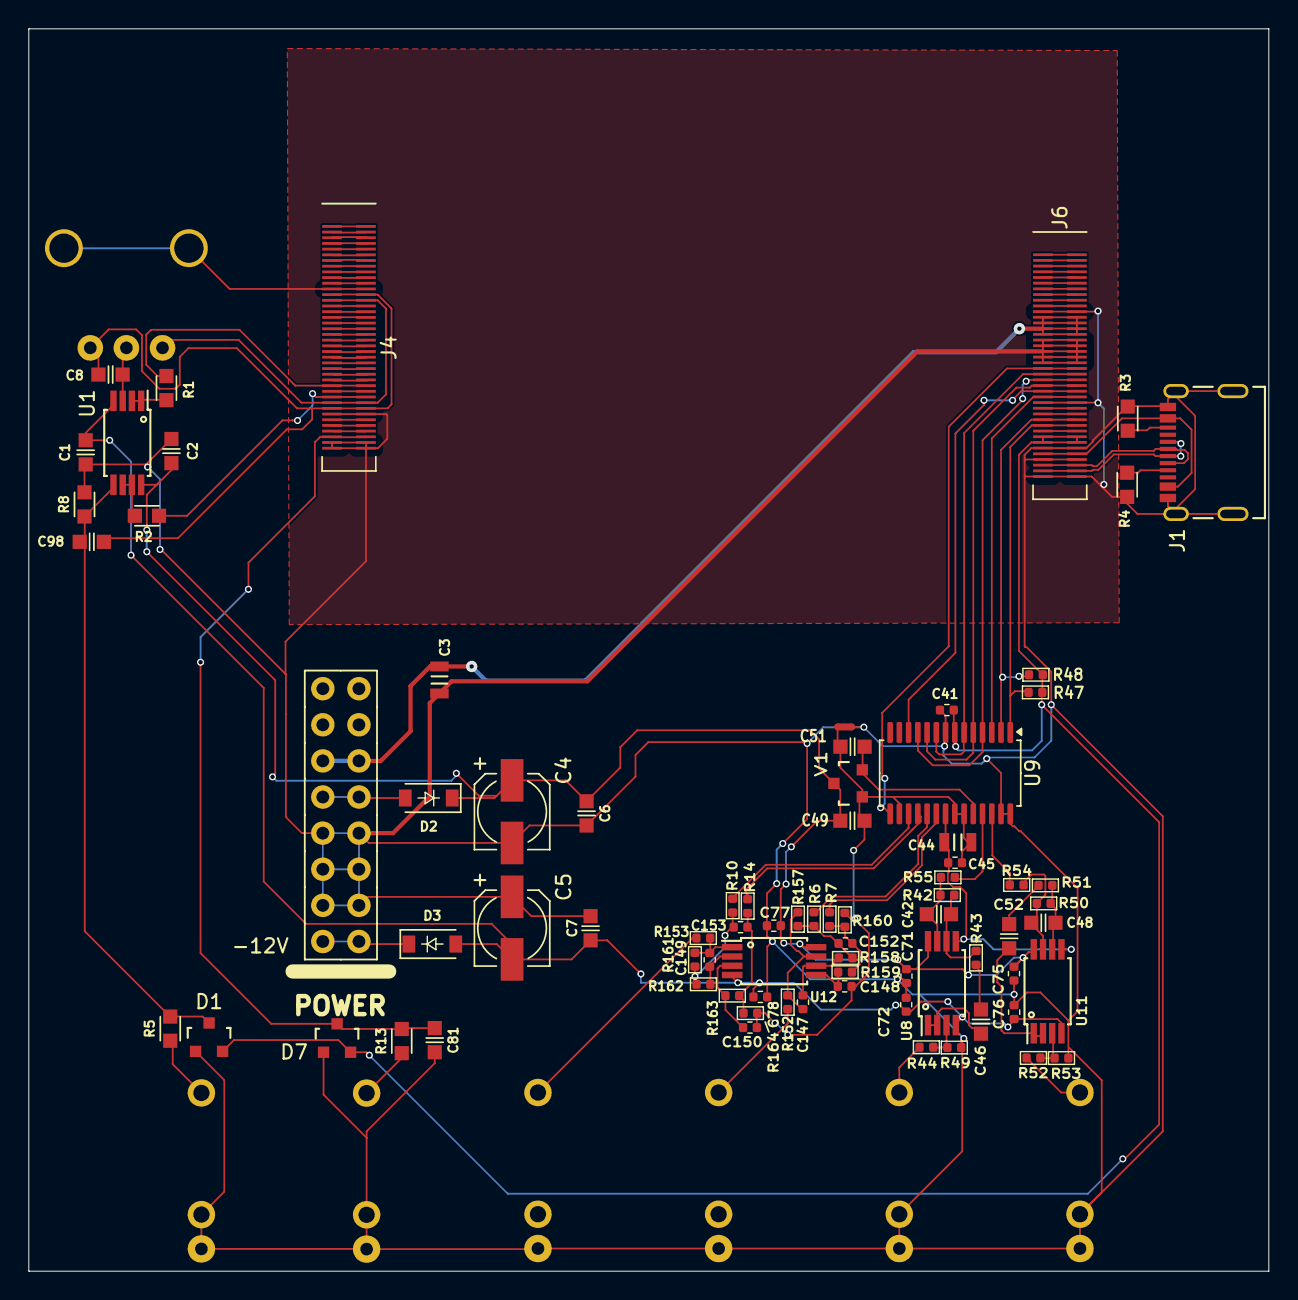
[picture p33: board carrier board/v0.1/mp153-carrier-board.kicad_pcb from above]

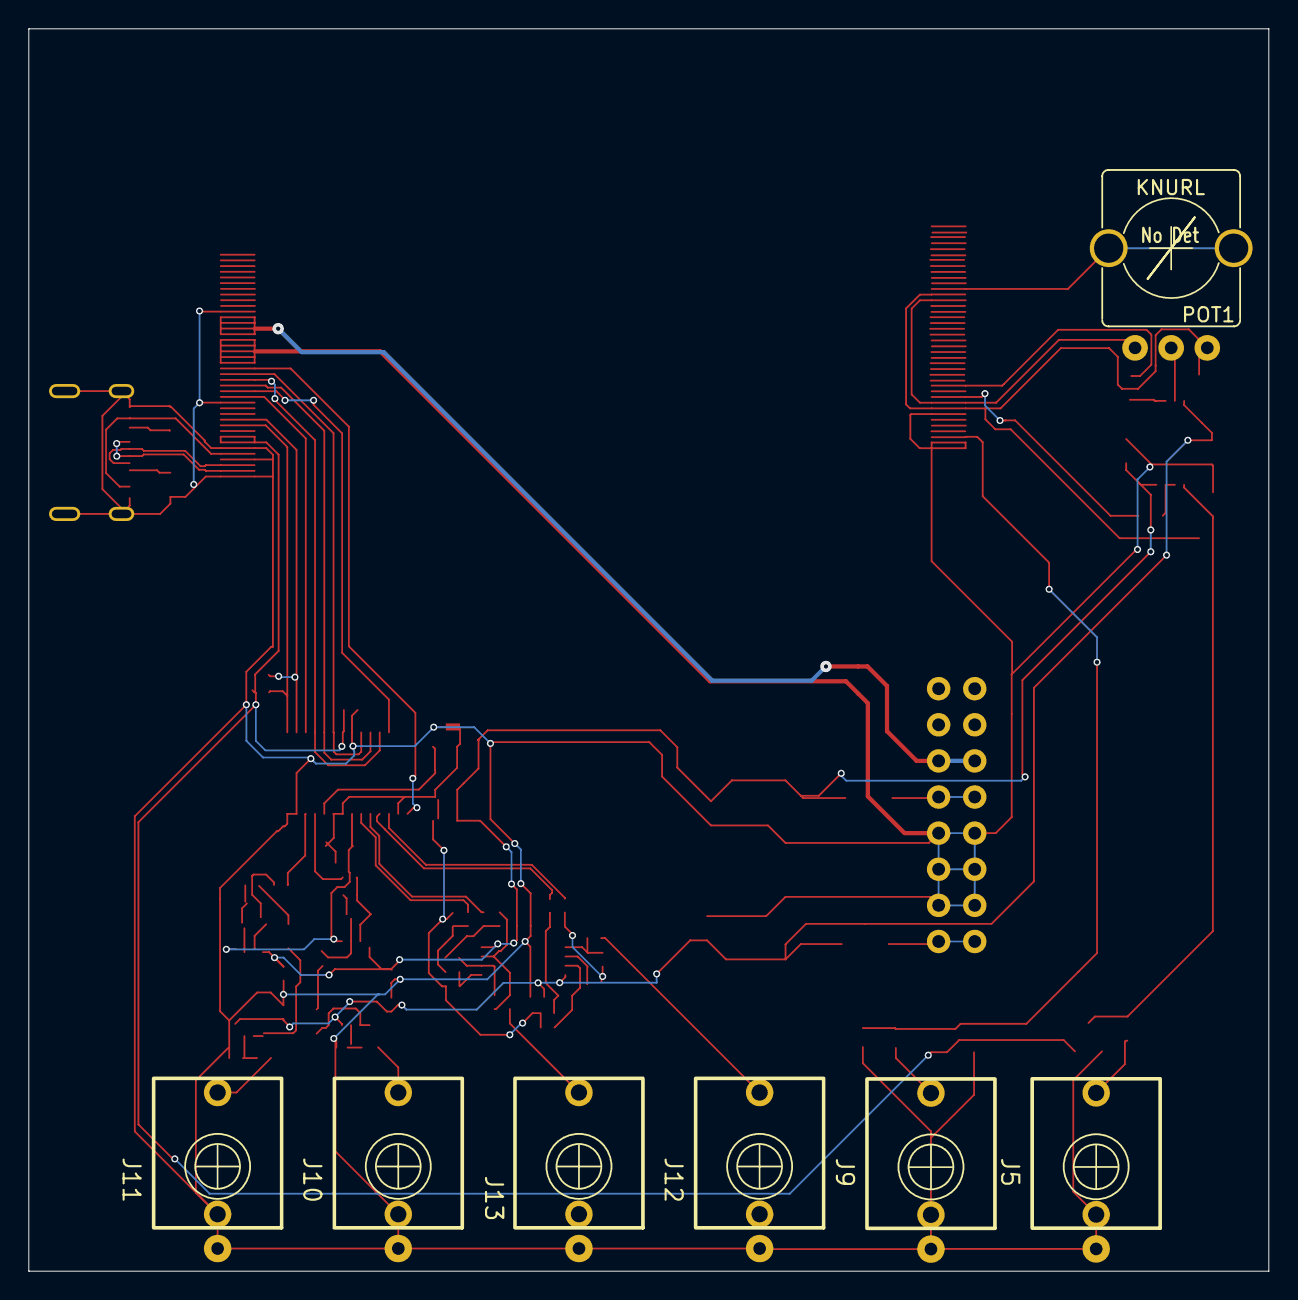
[picture p34: board carrier board/v0.1/mp153-carrier-board.kicad_pcb from below]

Board: 2 copper layers, 87.2 x 87.4 mm, 86 parts (7 on the bottom side), 106 nets.
