4ms/mp153-devboard/v0.2/cubemx/mp153-devboard-v0.1/mp153-devboard-v0.1.ioc

Mcu.UserName=STM32MP153DADx
PA0.Signal=ADC1_INP16
PA1.Signal=ADC1_INP17
PA10.Signal=GPIO_Input
PA11.Signal=I2C5_SCL
PA12.Signal=I2C5_SDA
PA15.GPIO_Label=DEBUG3
PA15.Signal=GPIO_Output
PA2.Signal=ADCx_INP14
PA3.Signal=ADCx_INP15
PA4.Signal=ADCx_INP18
PA5.Signal=ADCx_INP19
PA6.Signal=ADCx_INP3
PA7.Signal=ADCx_INP7
PA8.Signal=GPIO_Input
PA9.Signal=GPIO_Input
PB0.Signal=ADCx_INP9
PB1.Signal=ADCx_INP5
PB14.Signal=SPI2_MISO
PB15.Signal=SPI2_MOSI
PB2.Signal=SAI1_SD_A
PB4.Signal=GPIO_Output
PB6.Signal=QUADSPI_BK1_NCS
PB7.Signal=I2C1_SDA
PB8.Signal=I2C1_SCL
PB9.GPIO_Label=DEBUG2
PB9.Signal=GPIO_Output
PC0.Signal=ADCx_INP10
PC1.Signal=ADCx_INP11
PC10.Signal=SDMMC1_D2
PC11.Signal=SDMMC1_D3
PC12.Signal=SDMMC1_CK
PC2.Signal=ADCx_INP12
PC3.Signal=ADCx_INP13
PC4.Signal=ADCx_INP4
PC5.Signal=ADCx_INP8
PC6.Signal=USART6_TX
PC7.Signal=USART6_RX
PC8.Signal=SDMMC1_D0
PC9.Signal=SDMMC1_D1
PD0.Signal=I2C6_SDA
PD1.Signal=I2C6_SCL
PD11.Signal=SAI2_SD_A
PD12.Signal=SAI2_FS_A
PD13.Signal=SAI2_SCK_A
PD2.Signal=SDMMC1_CMD
PD3.Signal=SPI2_SCK
PD7.Signal=GPIO_Output
PD8.GPIO_Label=DFU_BOOT
PD8.Signal=GPIO_Input
PE0.Signal=SAI2_MCLK_A
PE10.Signal=GPIO_Output
PE11.GPIO_Label=DEBUG3
PE11.Signal=GPIO_Output
PE12.Signal=SPI4_SCK
PE13.Signal=SPI4_MISO
PE2.Signal=SAI1_MCLK_A
PE3.Signal=SAI1_SD_B
PE4.GPIO_Label=SD_DETECT
PE4.Signal=GPIO_Input
PE6.Signal=SPI4_MOSI
PF10.Signal=QUADSPI_CLK
PF11.Signal=ADC1_INP2
PF6.Signal=QUADSPI_BK1_IO3
PF7.Signal=QUADSPI_BK1_IO2
PF8.Signal=QUADSPI_BK1_IO0
PF9.Signal=QUADSPI_BK1_IO1
PG10.Signal=SAI2_SD_B
PG13.Signal=SAI1_SCK_A
PG15.Signal=SAI1_FS_A
PG9.Signal=GPIO_Output
PH0-OSC_IN.Signal=RCC_OSC_IN
PH1-OSC_OUT.Signal=RCC_OSC_OUT
