4ms/mp153-devboard/(commit log)

2025-06-03 Start v0.1 devboard
    [Kit-Brainboard.kicad_pcb, Kit-Brainboard.kicad_sch]
2025-06-03 WIP routing v0.1
    [Kit-Brainboard.kicad_pcb, Kit-Brainboard.kicad_sch]
2025-06-03 Rename project files
    [mp153-devboard.kicad_pcb, mp153-devboard.kicad_sch]
2025-06-03 Finish v0.1 dev board
    [DF40C-80DP.stp, DF40HC(3.0)-80DS.stp, mp153-devboard.kicad_pcb, mp153-devboard.kicad_sch]
2025-06-03 Generate JLC and generic/Posin production files
    [bom.csv, designators.csv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]
2025-06-03 Move project to v0.1 folder
    [DF40C-80DP.stp, DF40HC(3.0)-80DS.stp, bom.csv, designators.csv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]
2025-06-04 v0.1: add microSD slot, use USB-C, jumper for USB power, boot switches
    [2171790001.stp, DF40C-80DP.stp, DF40HC(3.0)-80DS.stp, TSW-102-08-T-S-RA.stp, bom.csv, designators.csv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]
2025-06-04 Start carrier board
    [mp153-carrier-board.kicad_pcb, mp153-carrier-board.kicad_sch]
2025-06-04 Update BOM with JLC numbers
    [bom.csv]
2025-06-04 Add JLC numbers
    [mp153-devboard.kicad_pcb]
2025-06-04 Cleanup carrier board example
    [mp153-carrier-board.kicad_sch]
2025-06-11 Carrier-board: Added codec and audio in/out
    [mp153-carrier-board.kicad_pcb, mp153-carrier-board.kicad_sch]
2025-06-11 Finished carrier board. Produced JLC files
    [mp153-carrier-board.kicad_pcb, mp153-carrier-board.kicad_sch]
2025-06-11 JLC files for carrier board. Ordered
    [bom.csv, designators.csv, positions.csv]
2025-06-11 devboard v0.1: increased spacing between zones on inner layers. Vias => 0.25mm holes
    [mp153-devboard.kicad_pcb, mp153-devboard.kicad_sch]
2025-06-11 Fix silk overlap on 80pin connector footprint
2025-06-11 Exported production files for v0.1 devboard
    [bom.csv]
2025-06-11 Update devboard v0.1 with 0.3mm minimum via hole. Ordered JLCPCB
    [mp153-devboard.kicad_pcb]
2025-06-23 Start p2 carrier board
    [mp153-carrier-board.kicad_pcb, mp153-carrier-board.kicad_sch]
2025-06-24 p2 carrier board: fixed position of headers
    [mp153-carrier-board.kicad_pcb, mp153-carrier-board.kicad_sch, mp153-devboard.kicad_pcb]
2025-06-24 Move carrier board to v0.1 dir. Rename p2=>v0.2
    [bom.csv, designators.csv, mp153-carrier-board.kicad_pcb, mp153-carrier-board.kicad_sch, positions.csv]
2025-06-24 Add note to devboard schematic
    [mp153-devboard.kicad_sch]
2025-06-26 Schematic notes (v0.1)
    [mp153-devboard.kicad_sch]
2025-06-26 More notes on v0.1 devboard schematic. Updated cubemx file for v0.1
    [mp153-devboard.kicad_sch]
2025-07-02 devboard v0.1: rename all header pins
    No electrical changes made: only renamed pins to use PX# style (e.g. "PA0") instead of D# style (e.g. "D23")
    [mp153-devboard.kicad_pcb, mp153-devboard.kicad_sch]
2025-07-02 devboard symbol: pin A39 should be unconnected
    For future revisions, it will be a pin, so carrier boards shouldn't ground it
2025-07-02 Add footprint for mp153 devboard
2025-07-02 Cubemx: export pinout.csv
    [pinout.csv]
2025-07-02 Create carrier board v0.3:
    - Fix D+/D- swap on USB jack
    - Generate +5V from +12V
    - Use symbol and footprint
    [mp153-carrier-board.kicad_pcb, mp153-carrier-board.kicad_sch]
2025-07-02 carrier board v0.3: finish schematic and PCB
    [mp153-carrier-board.kicad_pcb, mp153-carrier-board.kicad_sch]
2025-07-02 carrier board: fix-it notes for v0.2
    [mp153-carrier-board.kicad_sch]
2025-07-03 JLC Producton files for carrier board v0.3
    [bom.csv, designators.csv, mp153-carrier-board.kicad_pcb, mp153-carrier-board.kicad_sch, positions.csv]
2025-07-05 Create A and B socket footprints
2025-07-05 Start v0.4 (to test out new footprints/sym)
    Compared gerbers vs v0.3:
    - Mask opening along center of 2x40 connectors (was traces, now is one extended pad)
    - B68 via now connects to GND (may have been an error on v0.3?)
    - Minor silk changes (around jacks and 2x40s).
    [mp153-carrier-board.kicad_pcb, mp153-carrier-board.kicad_sch]
2025-07-11 Create and order v0.2 devboard (Posin)
    Moved v0.1 board to v0.1 dir
    [2171790001.stp, DF40C-80DP.stp, DF40HC(3.0)-80DS.stp, TSW-102-08-T-S-RA.stp, bom.csv, designators.csv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]
2025-07-11 Hide 1x1 GND header 3d model
    [mp153-devboard.kicad_pcb]
2025-07-17 v0.2: Update AP62301Z6 part numbers
    [mp153-devboard.kicad_sch]
2025-07-30 rgb carrier board v0.1
    [mp153-rgb-carrier.kicad_pcb, mp153-rgb-carrier.kicad_sch]
2025-09-09 v0.3 and v0.4 carrier board
    [mp153-carrier-board.kicad_sch]
2025-09-09 v0.1 symbol: Add part numbers for Hirose connectors
2025-09-09 Footprint: Remove version text
2025-12-11 Add v0.3-mp135 project
    [mp153-devboard.kicad_pcb, mp153-devboard.kicad_sch]
2025-12-11 Rename mp135 board to v0.3-mp133
    [mp133-devboard.kicad_pcb, mp133-devboard.kicad_sch, pinout-all.csv]
2025-12-11 mp133 schematic WIP
    [mp133-devboard.kicad_sch]
2025-12-11 v0.2 uart connection image
2025-12-11 TODO note for v0.2 board
    [mp153-devboard.kicad_sch]
2025-12-11 carrier-board v0.4: notes and updates
    [mp153-carrier-board.kicad_sch]
2025-12-12 mp133 devboard sch WIP
    [mp133-devboard.kicad_sch]
2025-12-13 Work on mp133 devboard PCB
    [mp133-devboard.kicad_pcb]
2025-12-16 mp133 devboard DDR routing started
    [mp133-devboard.kicad_pcb, mp133-devboard.kicad_sch]
2025-12-17 mp133: add DDR pins escaped or has via
    [mp133-devboard.kicad_pcb, mp133-devboard.kicad_sch]
2025-12-17 mp13x: DDR3 RAM routed
    [mp133-devboard.kicad_pcb, mp133-devboard.kicad_sch]
2025-12-22 WIP Routing
    [mp133-devboard.kicad_pcb, mp133-devboard.kicad_sch]
2025-12-24 Created breakoutboard project
    [mp153-carrier-board.kicad_pcb, mp153-carrier-board.kicad_sch]
2025-12-27 Laying out board - WIP
    [mp153-carrier-board.kicad_pcb, mp153-carrier-board.kicad_sch]
2025-12-28 Organized breakoutheader silk
    [mp153-carrier-board.kicad_pcb, mp153-carrier-board.kicad_sch]
2025-12-29 WIP - completeing traces
    [mp153-carrier-board.kicad_pcb, mp153-carrier-board.kicad_sch]
2025-12-29 Begin fixing audio out section
    [mp153-carrier-board.kicad_pcb]
2025-12-29 Resolved ERC and DRC errors - warnings need to be reviewed. Cleaned up silk and cleaned up Audio out opamp section
    [mp153-carrier-board.kicad_pcb, mp153-carrier-board.kicad_sch]
2025-12-29 Removed redundant ADC net labels
    [mp153-carrier-board.kicad_pcb, mp153-carrier-board.kicad_sch]
2025-12-29 Project files updated to kicad 9.0.6
2025-12-29 carrier-breakout cleanup:
    - Fix nets with two names
    - Fix some silk overlap DRC warning for components too close
    - Add more space for pins names to fix DRC warnings for silk sizes
    - Remove empty boxes on silk
    - Space out jumpers that we may have to cut with an exacto (more space = easier to cut)
    - Added jumper for USB_5V_ENABLE, and pull-down to prevent floating when jumper is cut
    [mp153-carrier-board.kicad_pcb, mp153-carrier-board.kicad_sch]
2025-12-29 carrier-breakout: Production files (ordered JLC PCBA)
    [bom.csv, designators.csv, positions.csv]
2025-12-29 mp133: WIP routing and pin assignment
    [mp133-devboard.kicad_pcb, mp133-devboard.kicad_sch]
2025-12-30 mp133 cubemx: pin assignment
2025-12-30 mp133: routing and pin assignment
    [mp133-devboard.kicad_pcb, mp133-devboard.kicad_sch]
2025-12-30 mp133: completed routing
    [mp133-devboard.kicad_pcb, mp133-devboard.kicad_sch]
2025-12-30 mp133: cleanup for production
    [mp133-devboard.kicad_sch]
2025-12-30 mp133: Ordered JLC PCBA. Production files
    [bom.csv, designators.csv, positions.csv]
2026-01-02 PCB for mp133 v0.4 (length-matched some DDR_Q traces)
    [mp133-devboard.kicad_pcb]
2026-02-17 Copy v0.3-mp133 schematic and tables to v0.4-mp133
    [mp133-devboard.kicad_sch]
2026-02-20 Add sdprog project
    [sdprog.kicad_pcb, sdprog.kicad_sch]
2026-02-20 Cleanup sdprog
    [sdprog.kicad_pcb, sdprog.kicad_sch]
2026-02-20 JLC production files for sdprog
    [bom.csv, designators.csv, positions.csv]
